clemarfolly/TK3000/componentes.jpg

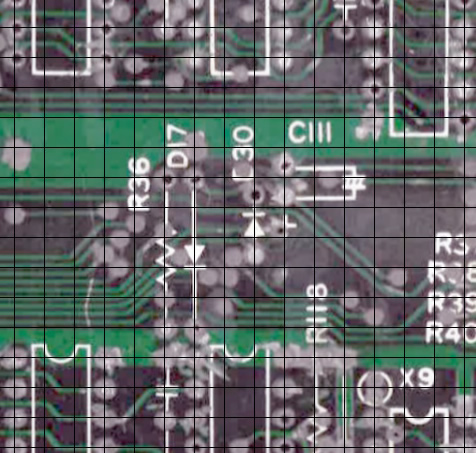
componentes.jpg
