clemarfolly/TK3000/TK3000_mapa_cis.jpg

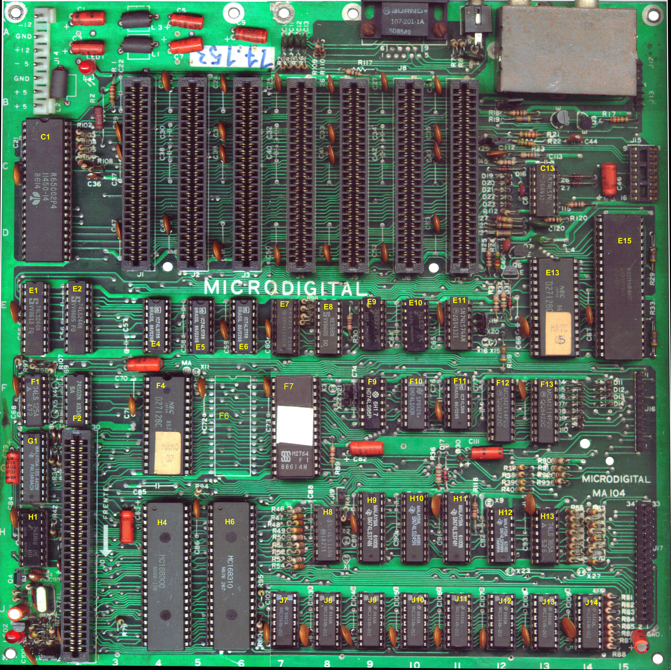
TK3000_mapa_cis.jpg
