clemarfolly/TK3000/Fotos Originais/SEskasoni-H25090512270.pdf

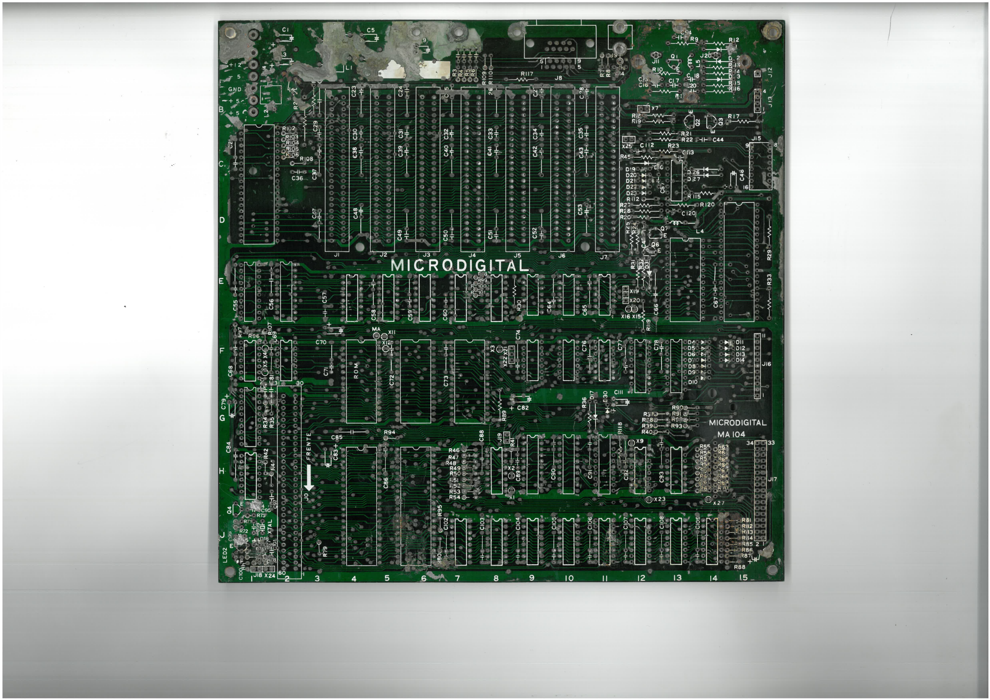
[picture p3: page 1]
