clemarfolly/TK3000/Fotos Originais/SEskasoni-H25090512280.pdf

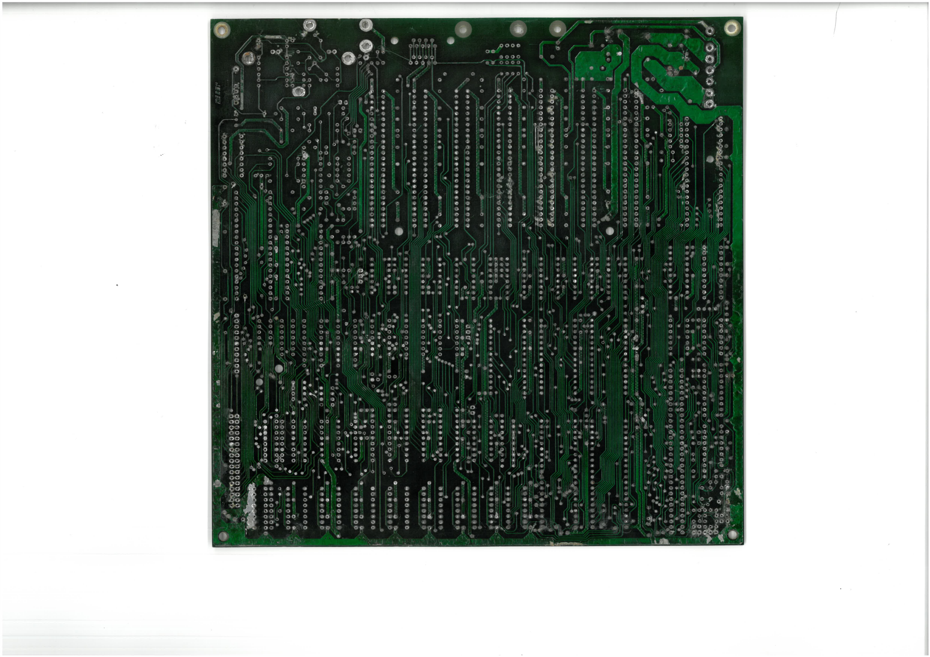
[picture p4: page 1]
