clemarfolly/TK3000/Apoio/ModuladorRF-canal-vbe-youtube-v=0MxuOd1NND4.jpg

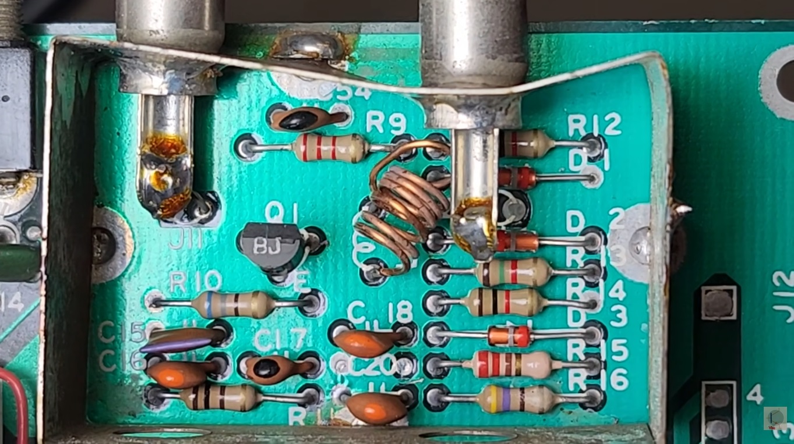
Apoio/ModuladorRF-canal-vbe-youtube-v=0MxuOd1NND4.jpg
