clemarfolly/TK3000/Apoio/tk3000_f.JPG

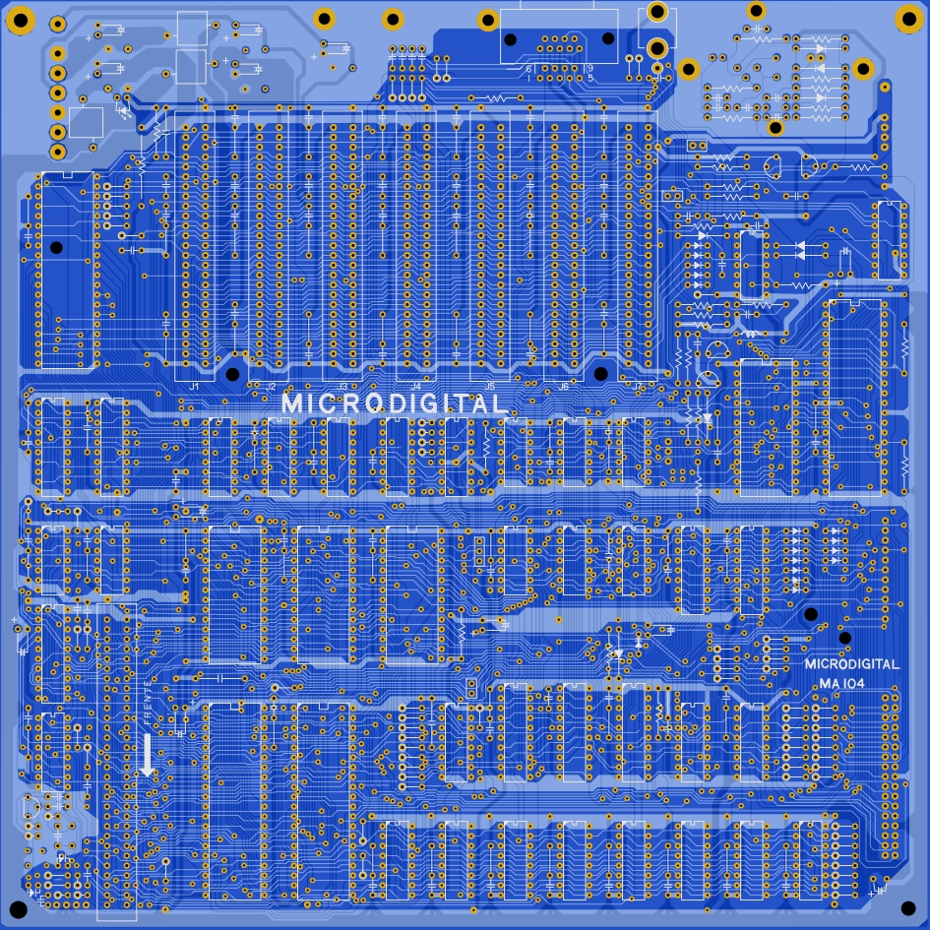
Apoio/tk3000_f.JPG
