clemarfolly/TK3000/comparação.jpg

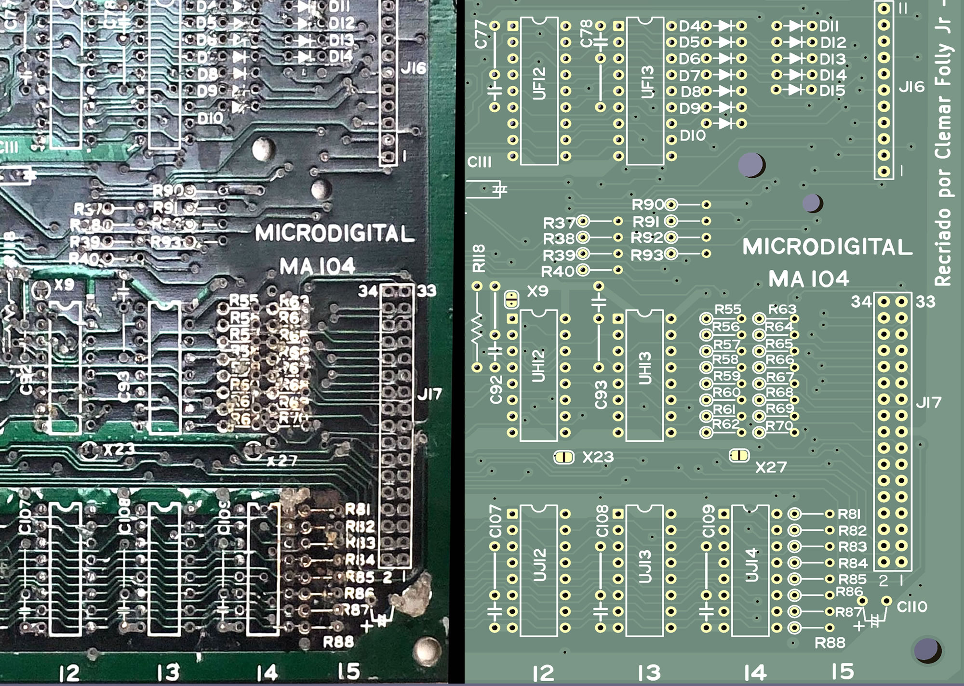
comparação.jpg
