clemarfolly/TK3000/Esquema Original/esquema_tk3000_microdigital.gif

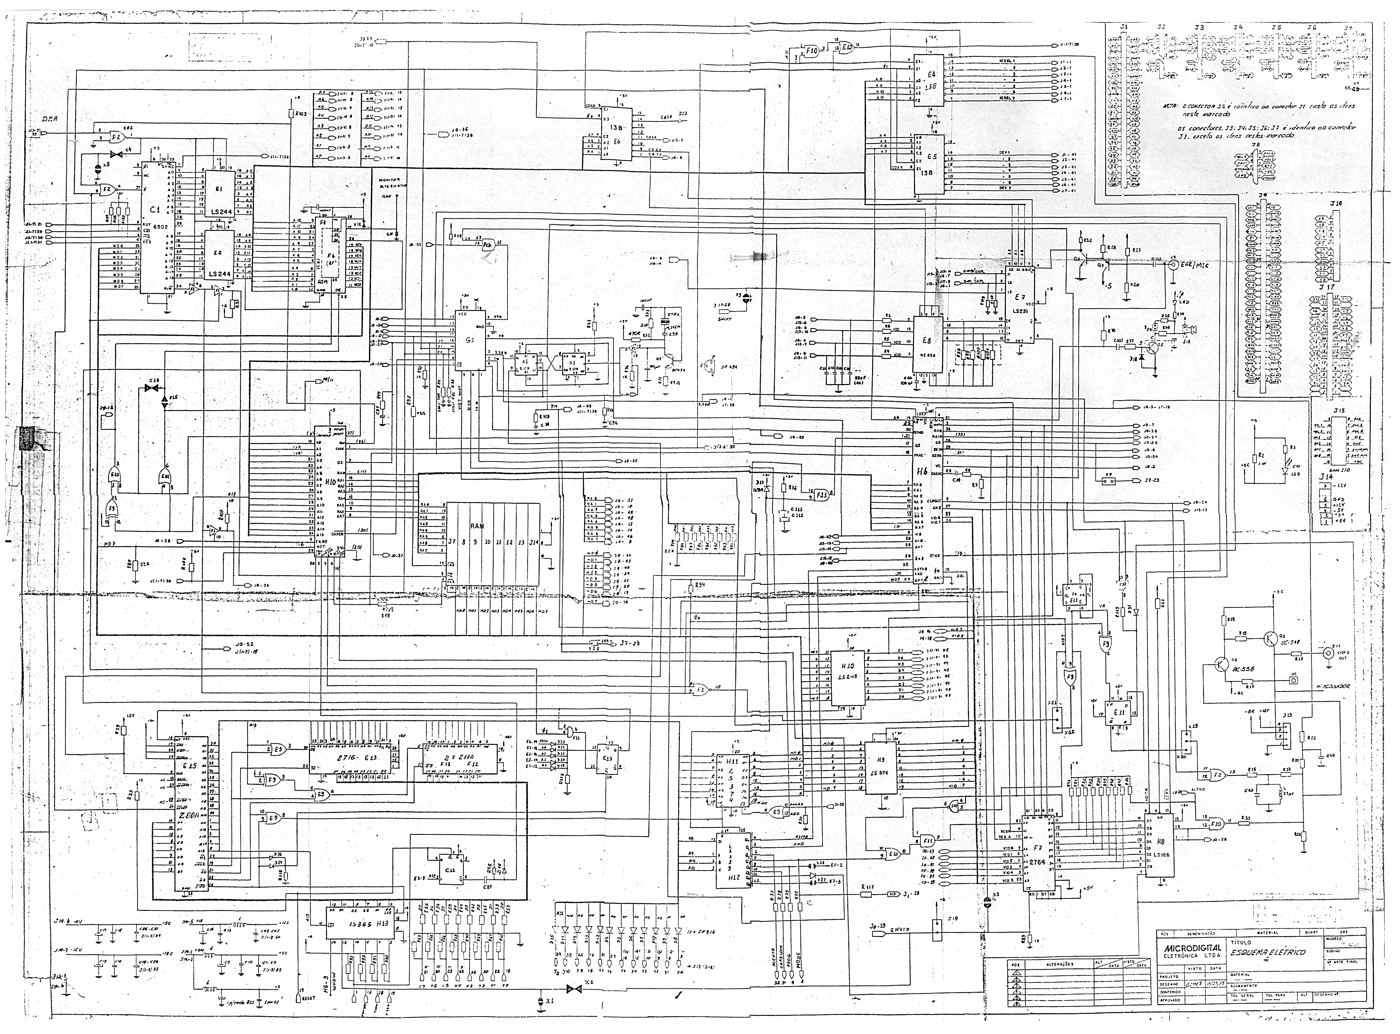
Esquema Original/esquema_tk3000_microdigital.gif
