clemarfolly/TK3000/Esquema Original/TK3000_DiagramaBlocos.tif

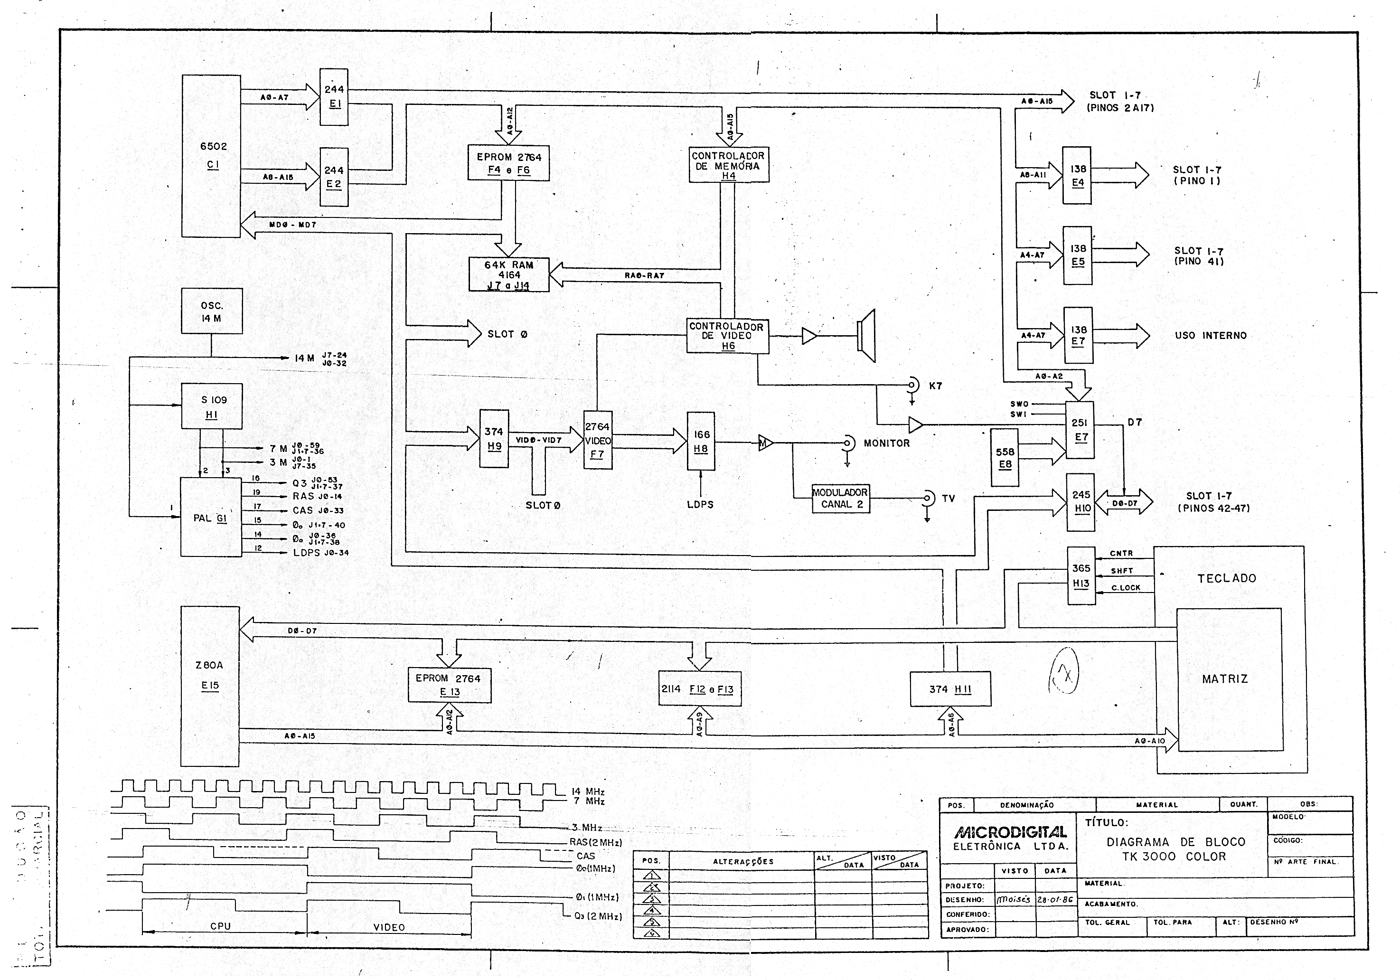
Esquema Original/TK3000_DiagramaBlocos.tif
