clemarfolly/TK3000/Fotos Ajustadas/tk3000_cel_frente2.jpg

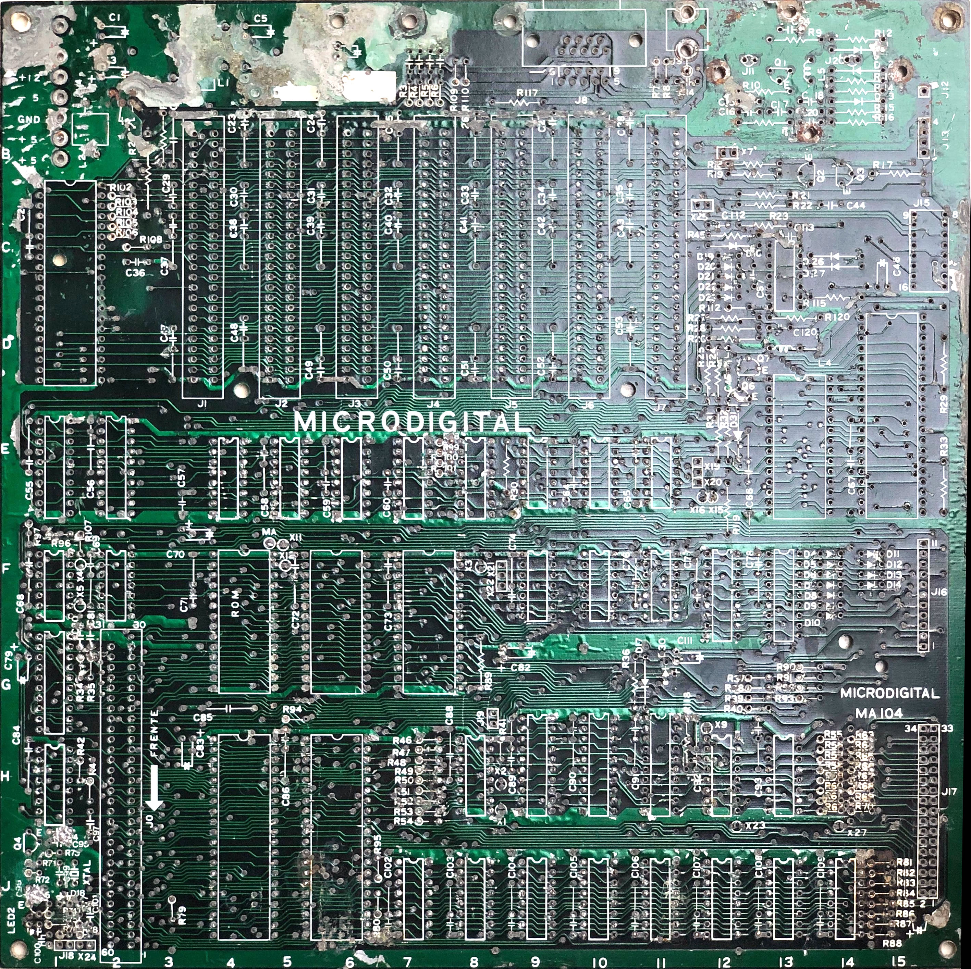
Fotos Ajustadas/tk3000_cel_frente2.jpg
