clemarfolly/TK3000/Fotos Ajustadas/tk3000_cel_frente3.jpg

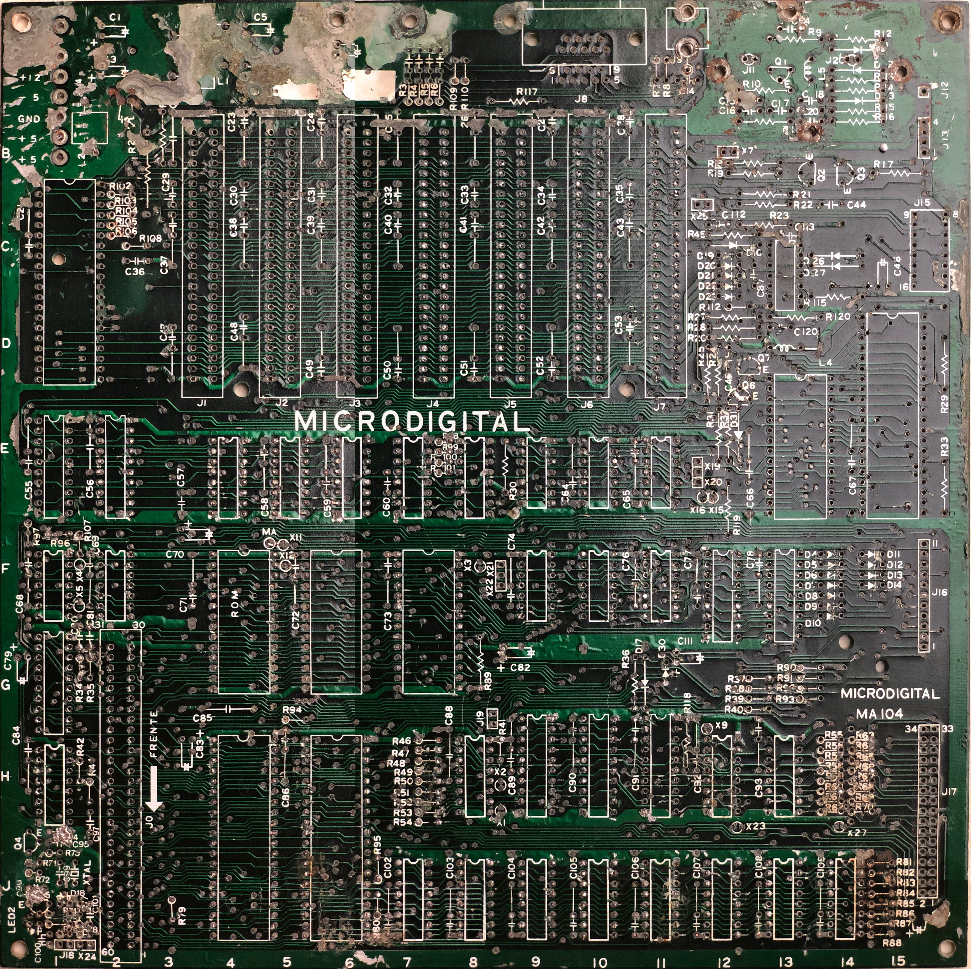
Fotos Ajustadas/tk3000_cel_frente3.jpg
