clemarfolly/TK3000/Fotos Ajustadas/tk3000_cel_verso2.jpg

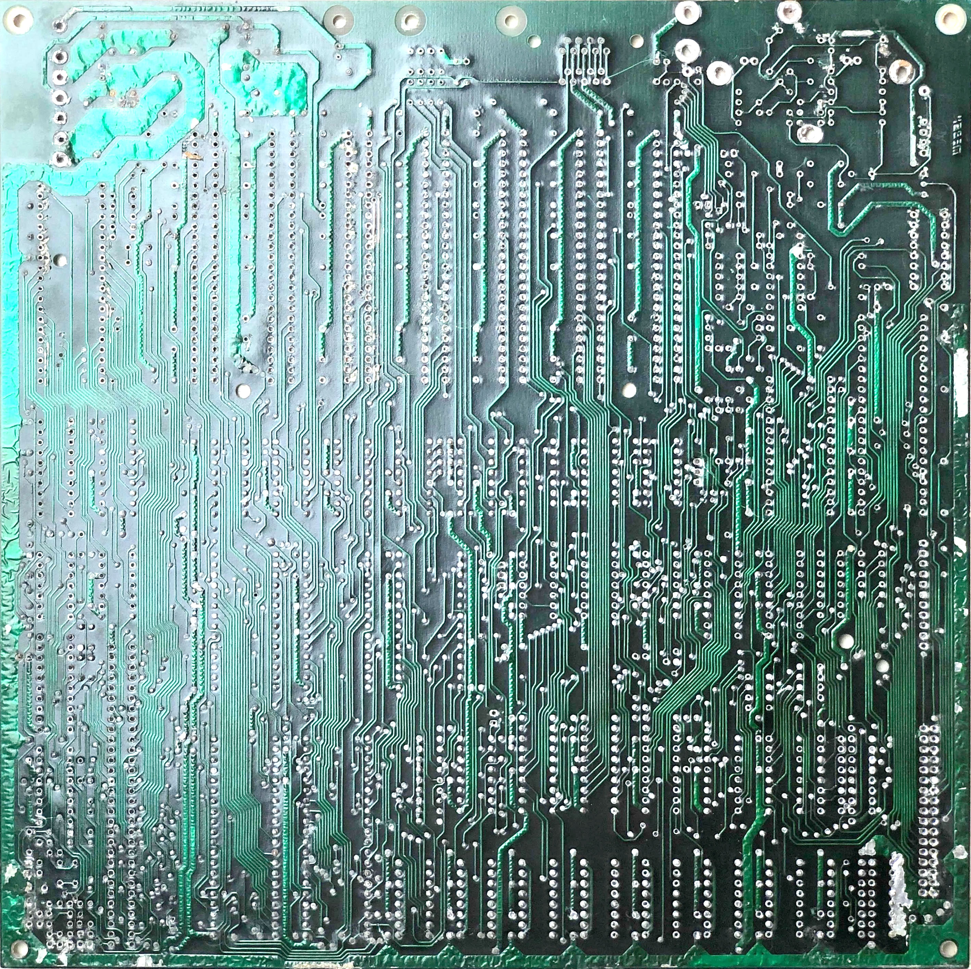
Fotos Ajustadas/tk3000_cel_verso2.jpg
