clemarfolly/TK3000/Fotos Ajustadas/tk3000_cel_verso4.jpg

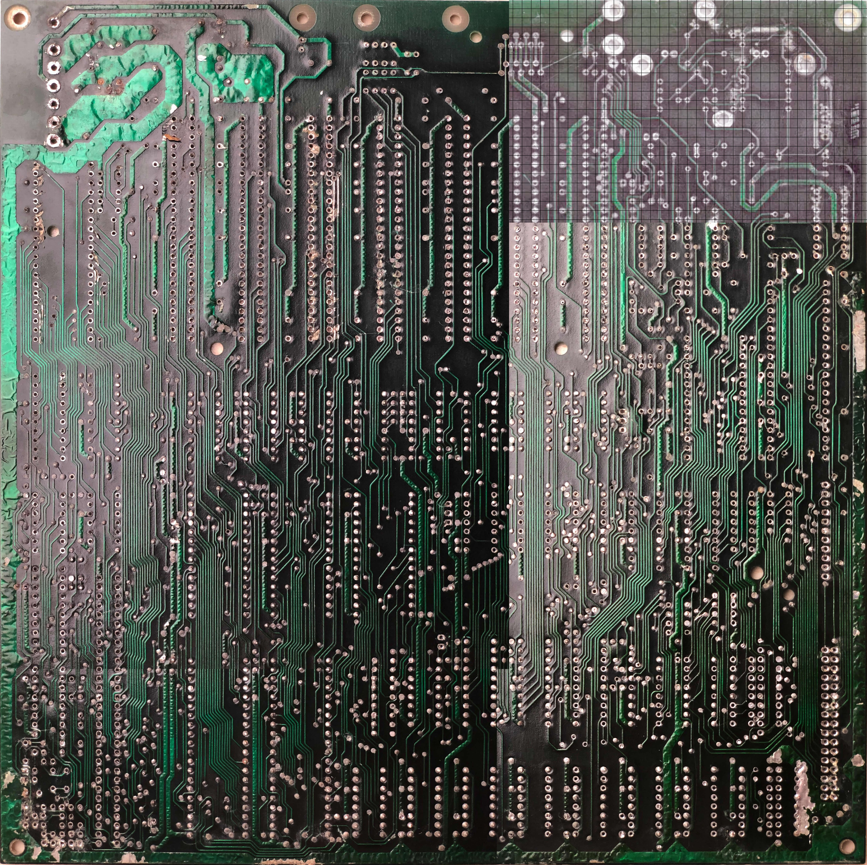
Fotos Ajustadas/tk3000_cel_verso4.jpg
