clemarfolly/TK3000/Fotos Ajustadas/TK3000_scan_frente.jpg

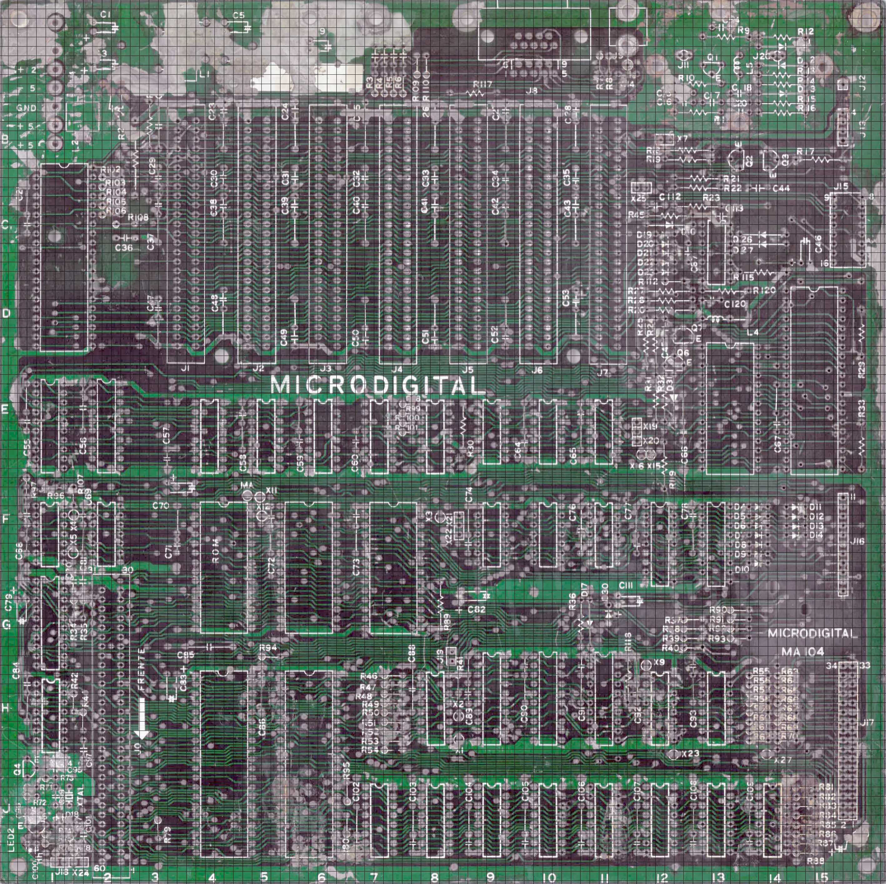
Fotos Ajustadas/TK3000_scan_frente.jpg
