clemarfolly/TK3000/Fotos Ajustadas/TK3000_scan_verso.jpg

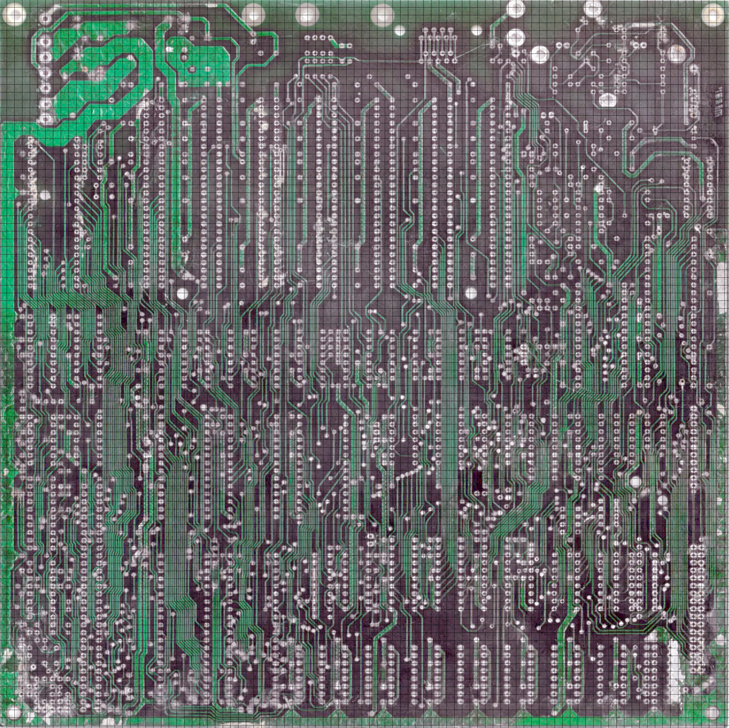
Fotos Ajustadas/TK3000_scan_verso.jpg
