clemarfolly/TK3000/Fotos Ajustadas/tk3000_verso_alternativo.jpg

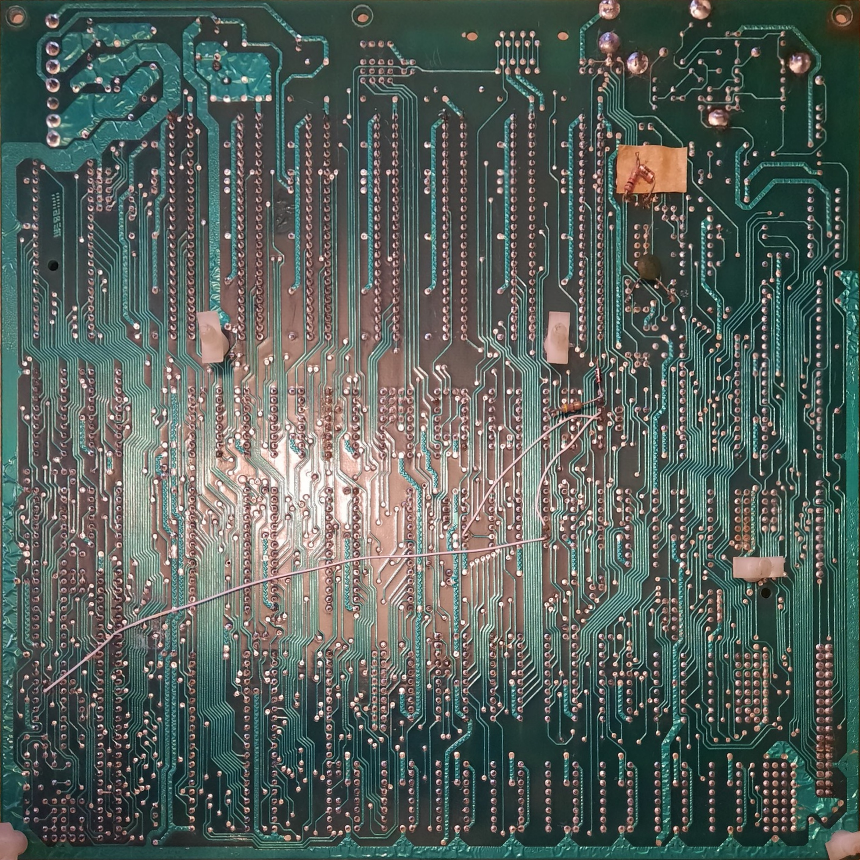
Fotos Ajustadas/tk3000_verso_alternativo.jpg
