clemarfolly/TK3000/Fotos Originais/459558370_9009164292432499_6865627964230679064_n.jpg

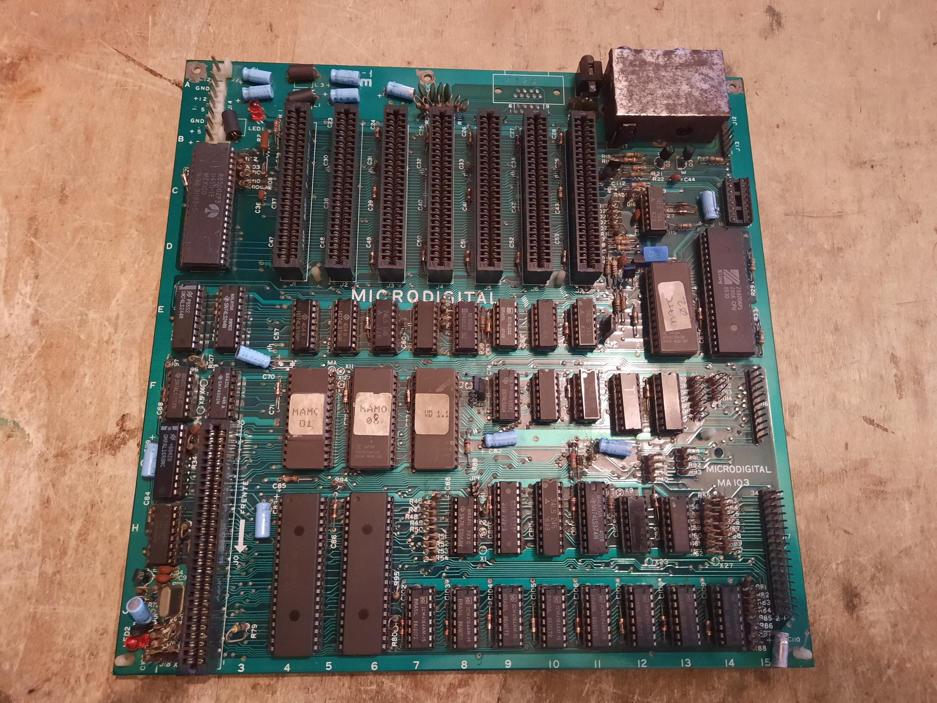
Fotos Originais/459558370_9009164292432499_6865627964230679064_n.jpg
