clemarfolly/TK3000/Fotos Originais/459910241_9009164349099160_2916040112095149237_n.jpg

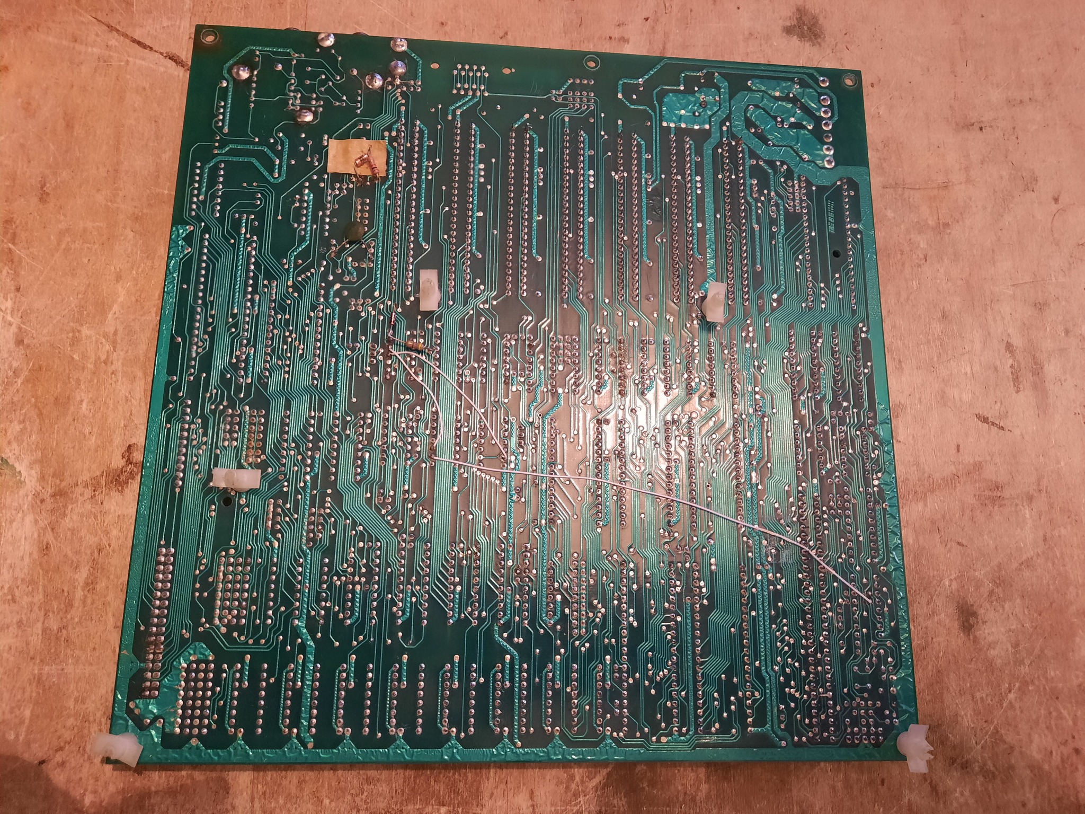
Fotos Originais/459910241_9009164349099160_2916040112095149237_n.jpg
