clemarfolly/TK3000/Fotos Originais/Celular/01.jpeg

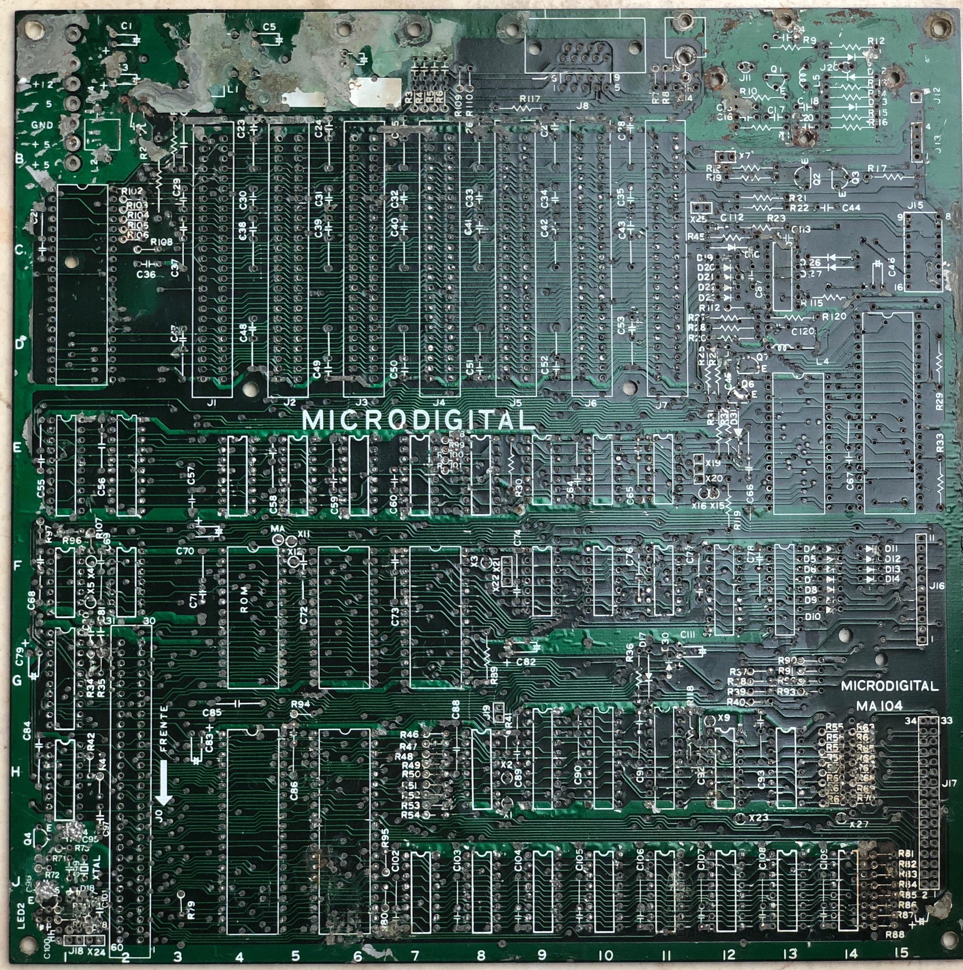
Fotos Originais/Celular/01.jpeg
