clemarfolly/TK3000/Fotos Originais/Celular/02.jpeg

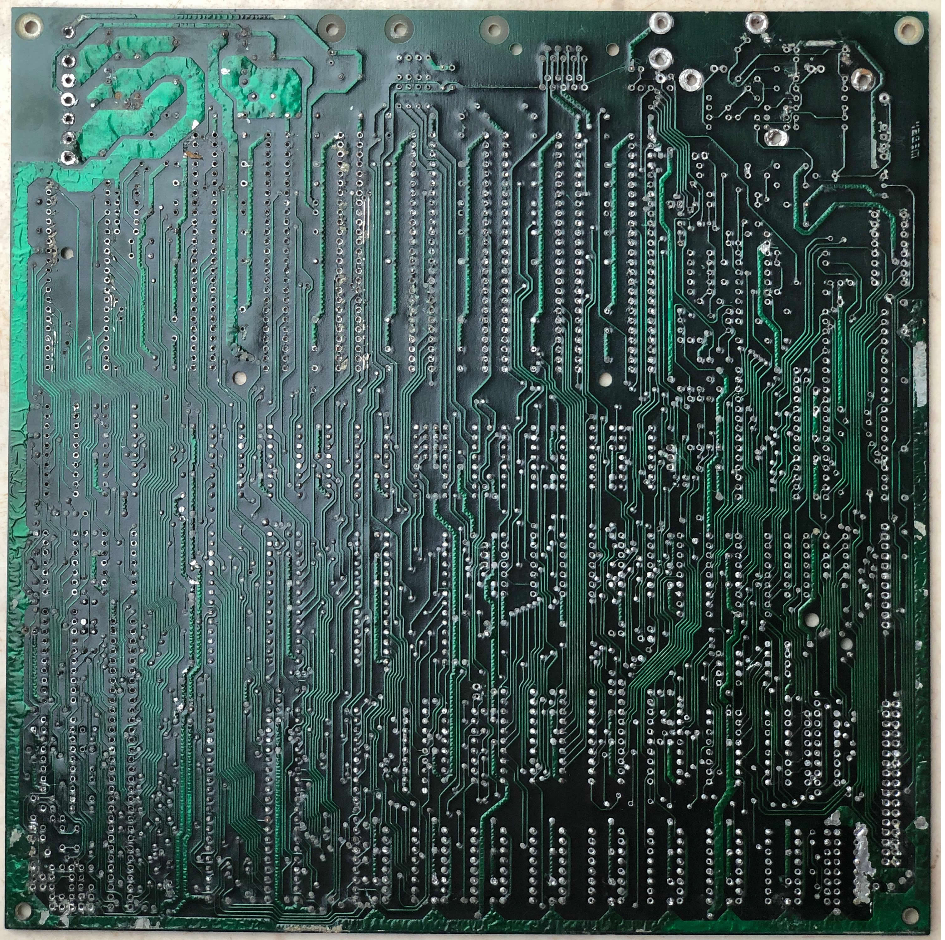
Fotos Originais/Celular/02.jpeg
