clemarfolly/TK3000/Fotos Originais/Celular/03.jpeg

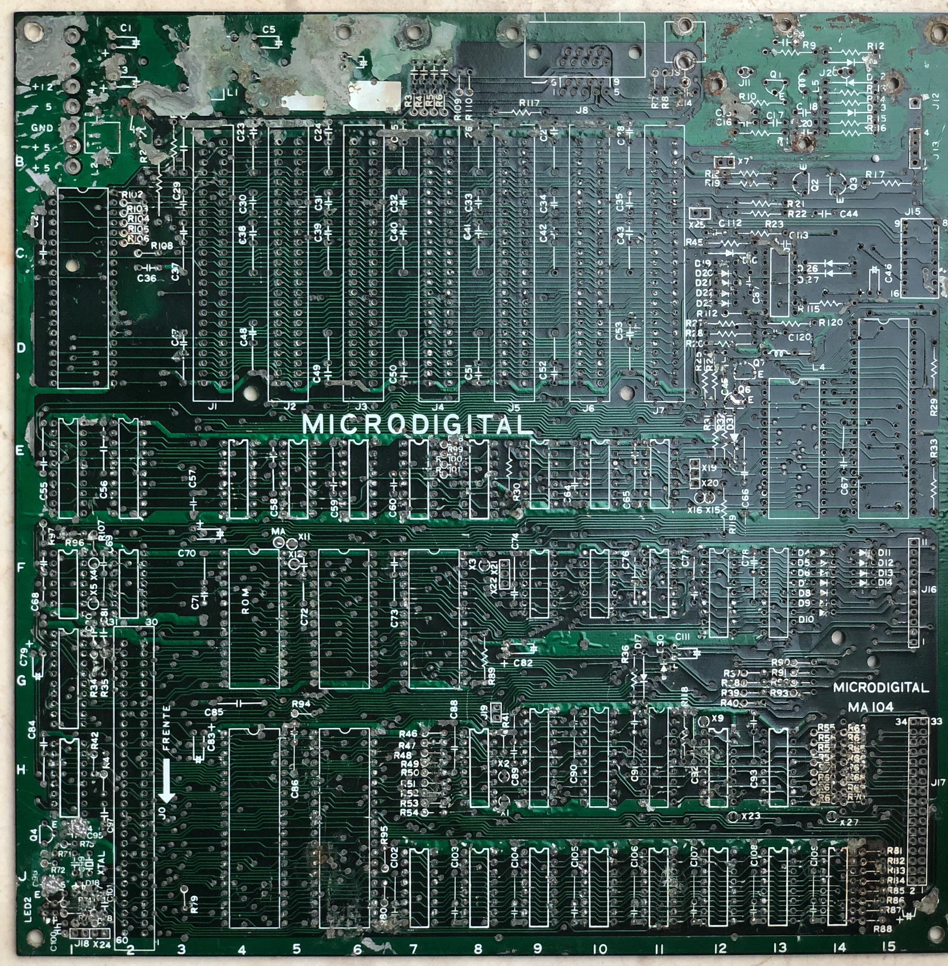
Fotos Originais/Celular/03.jpeg
