clemarfolly/TK3000/Fotos Originais/Celular/04.jpeg

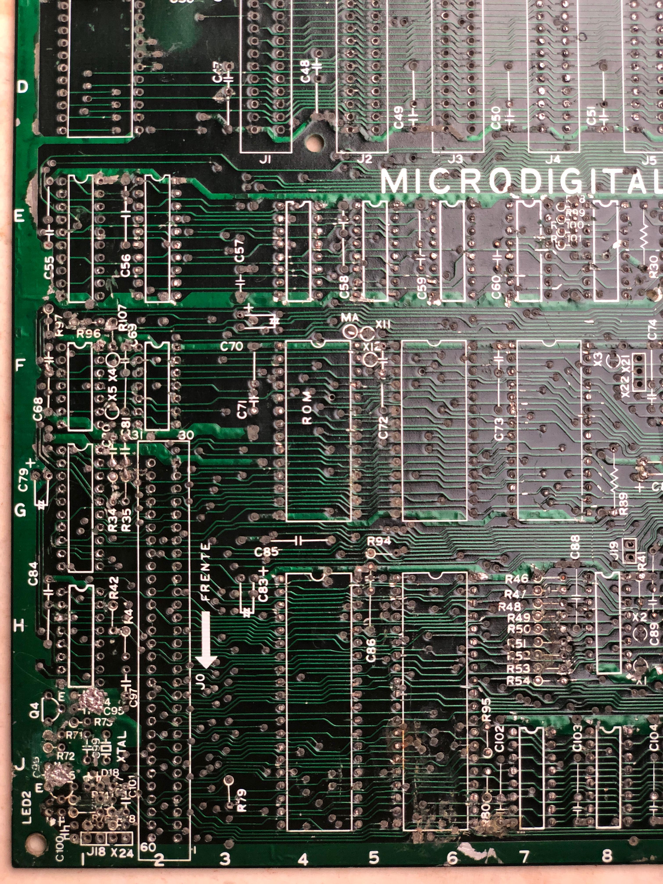
Fotos Originais/Celular/04.jpeg
