clemarfolly/TK3000/Fotos Originais/Celular/05.jpeg

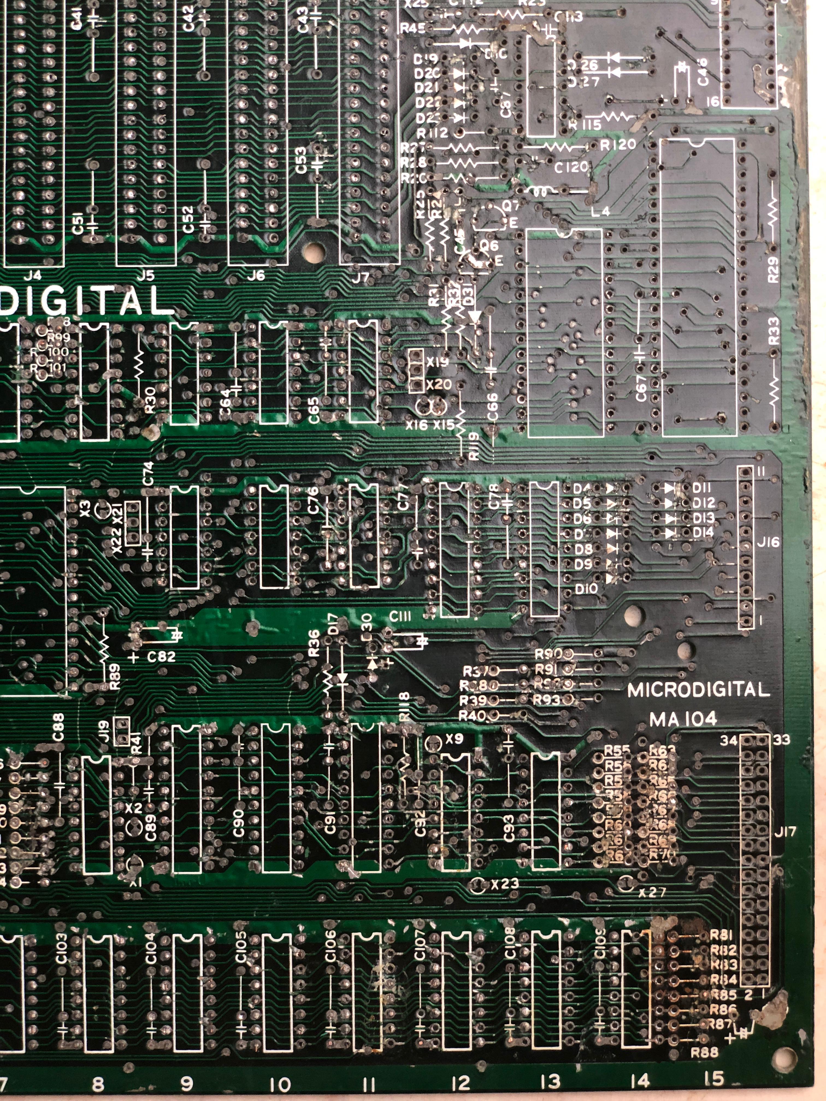
Fotos Originais/Celular/05.jpeg
