clemarfolly/TK3000/Fotos Originais/Celular/06.jpeg

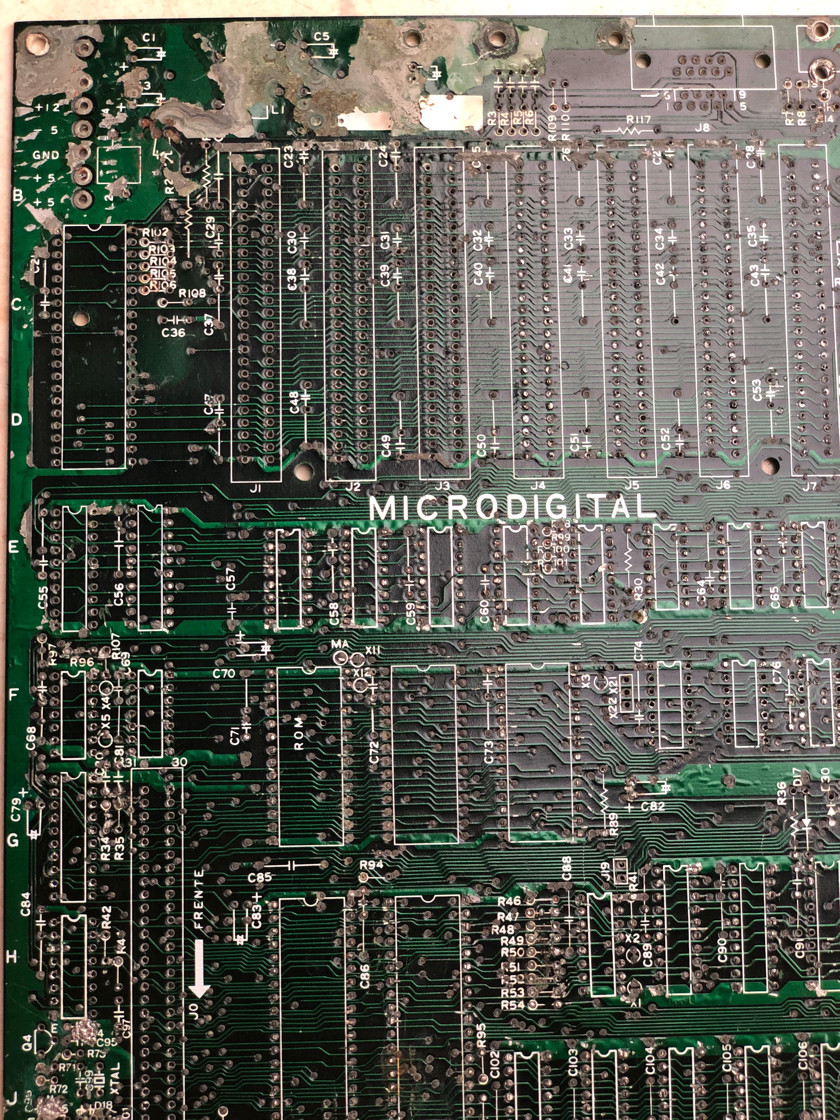
Fotos Originais/Celular/06.jpeg
