clemarfolly/TK3000/Fotos Originais/Celular/07.jpeg

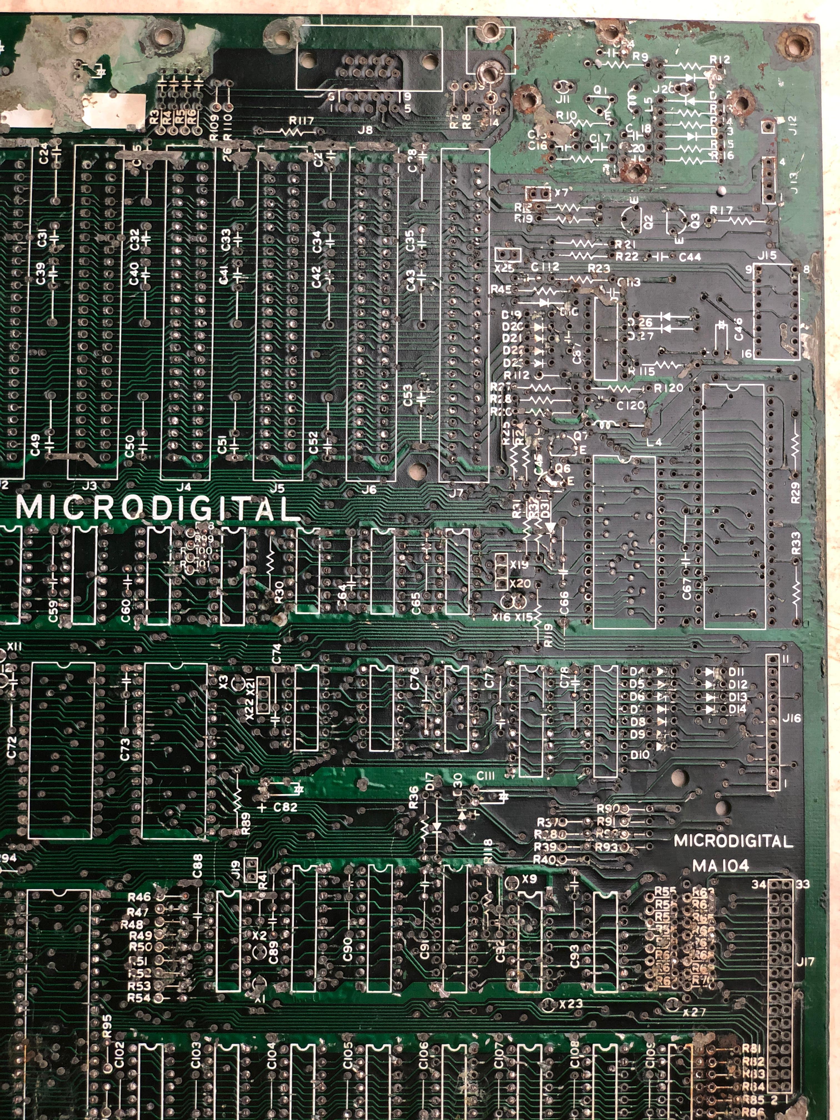
Fotos Originais/Celular/07.jpeg
