clemarfolly/TK3000/Fotos Originais/Celular/08.jpeg

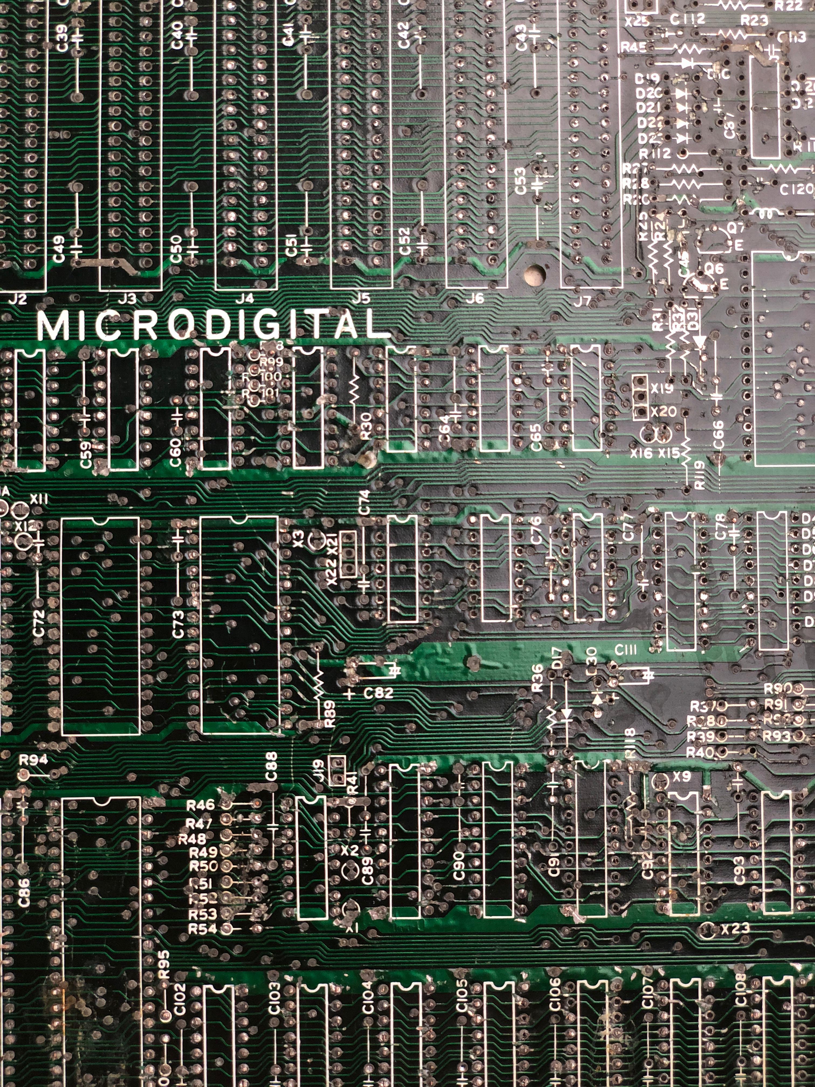
Fotos Originais/Celular/08.jpeg
