clemarfolly/TK3000/Fotos Originais/Celular/09.jpeg

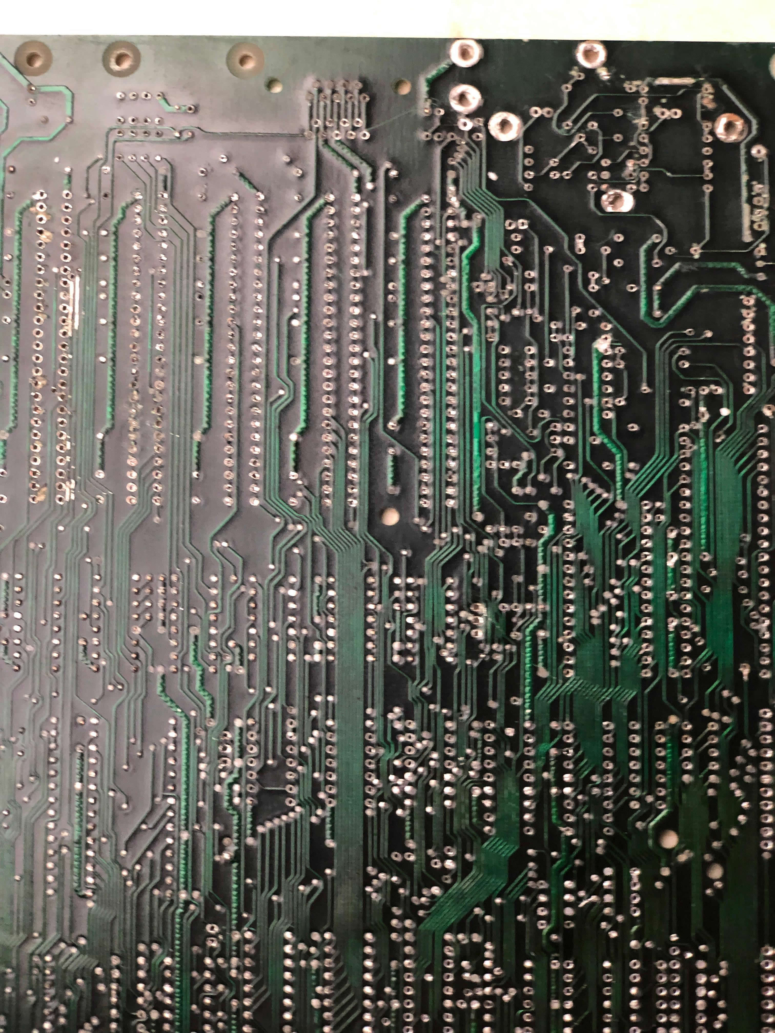
Fotos Originais/Celular/09.jpeg
