clemarfolly/TK3000/Fotos Originais/Celular/10.jpeg

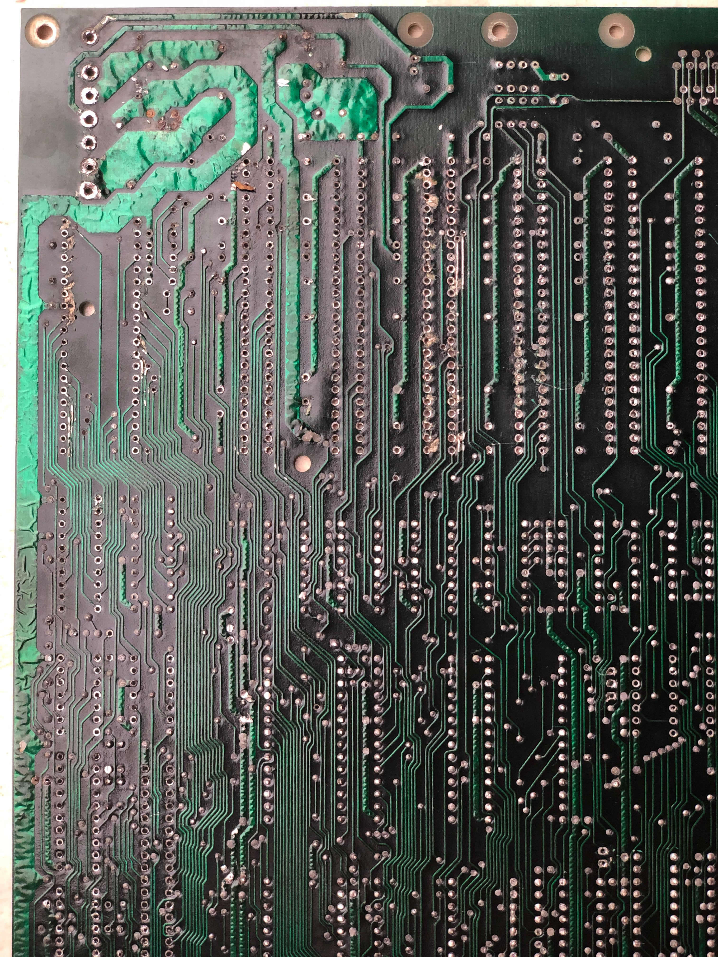
Fotos Originais/Celular/10.jpeg
