clemarfolly/TK3000/Fotos Originais/Celular/11.jpeg

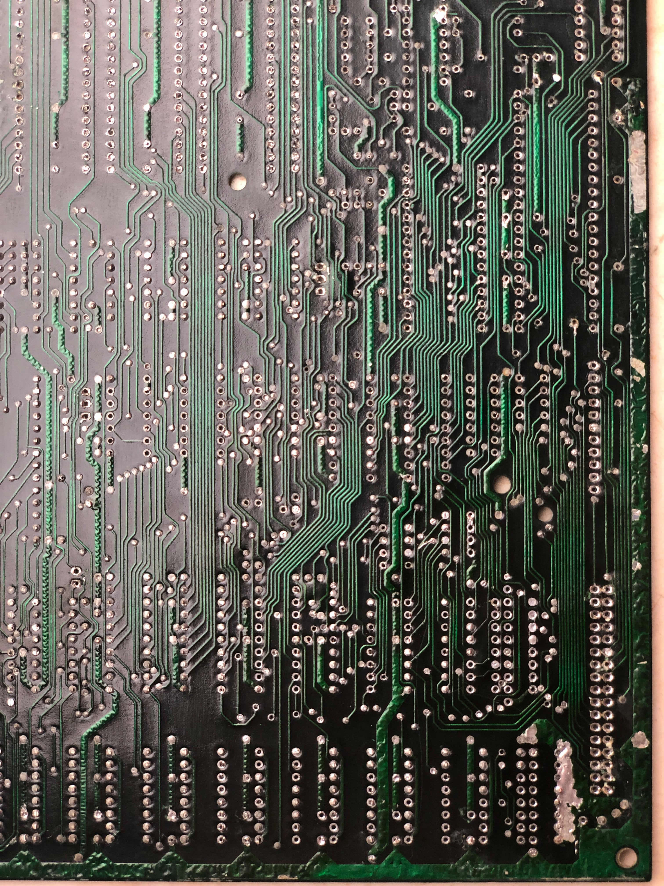
Fotos Originais/Celular/11.jpeg
