clemarfolly/TK3000/Fotos Originais/Celular/12.jpeg

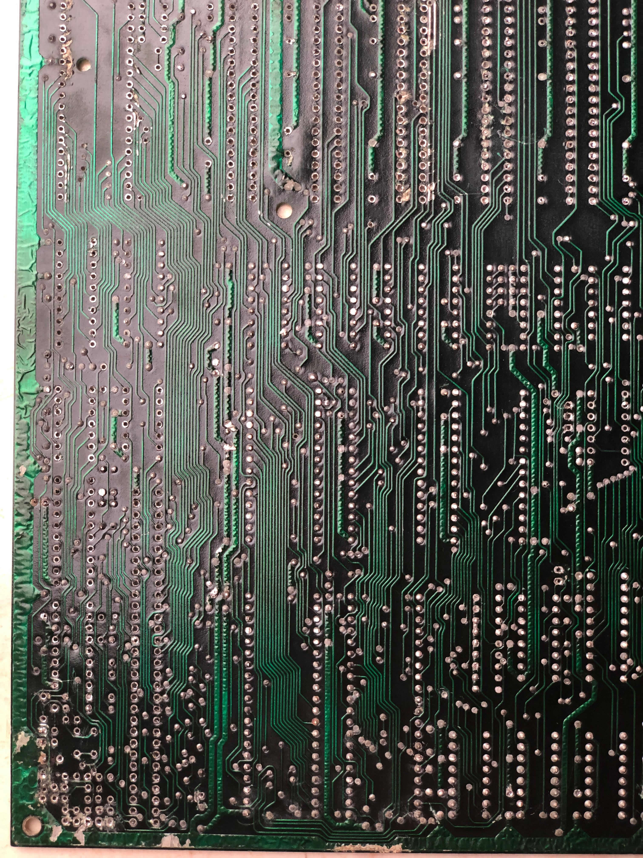
Fotos Originais/Celular/12.jpeg
