clemarfolly/TK3000/Fotos Originais/Celular/13.jpeg

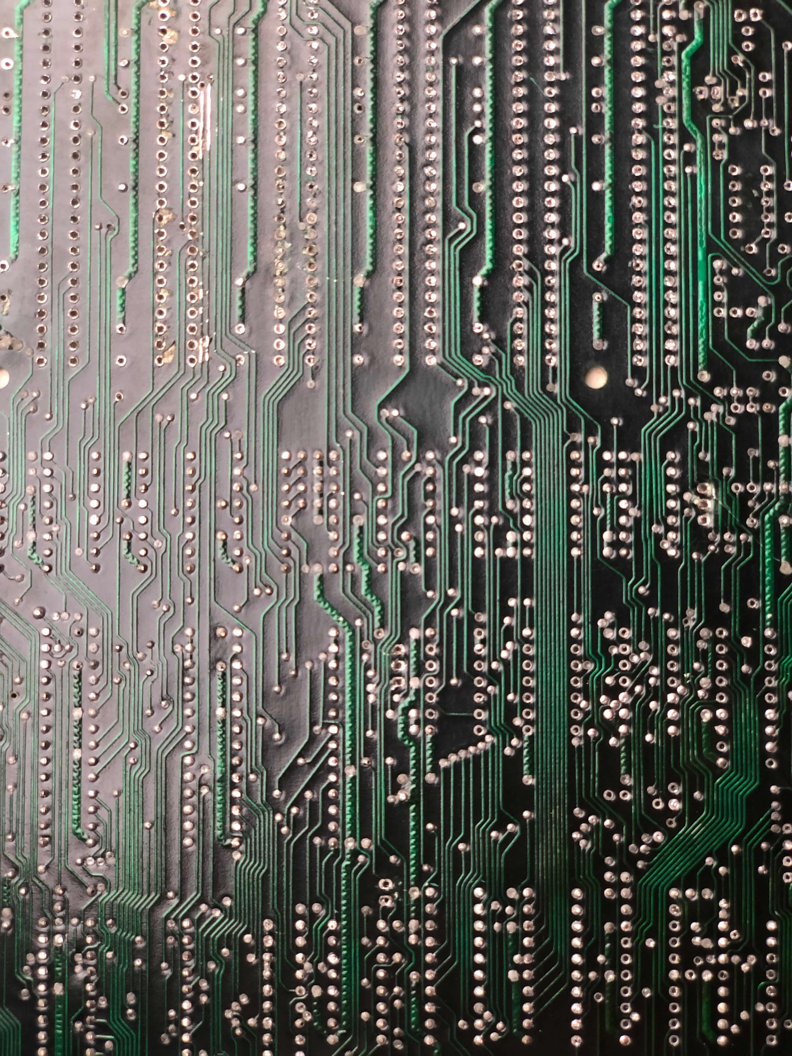
Fotos Originais/Celular/13.jpeg
