clemarfolly/TK3000/Fotos Originais/D_NQ_NP_2X_725195-MLB78293878917_082024-F.webp

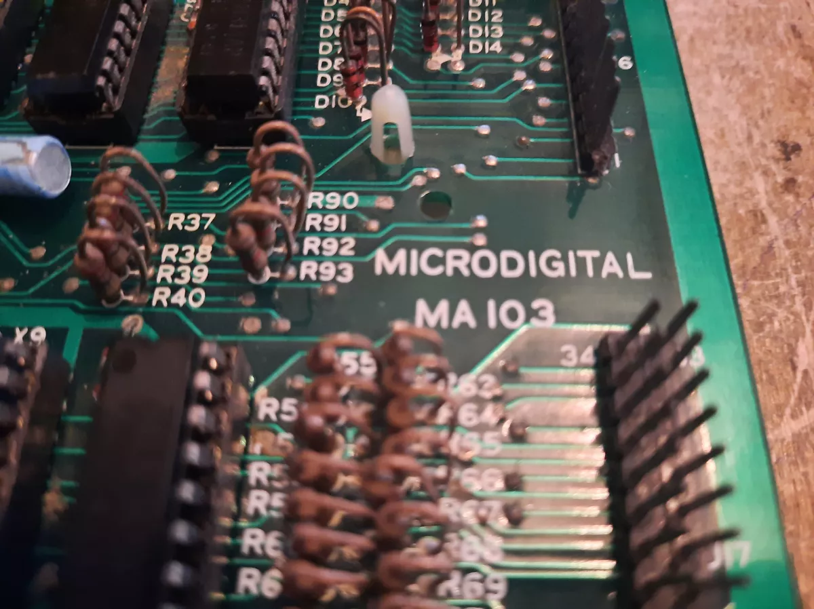
Fotos Originais/D_NQ_NP_2X_725195-MLB78293878917_082024-F.webp
