clemarfolly/TK3000/Fotos Originais/D_NQ_NP_2X_956720-MLB78293879247_082024-F.webp

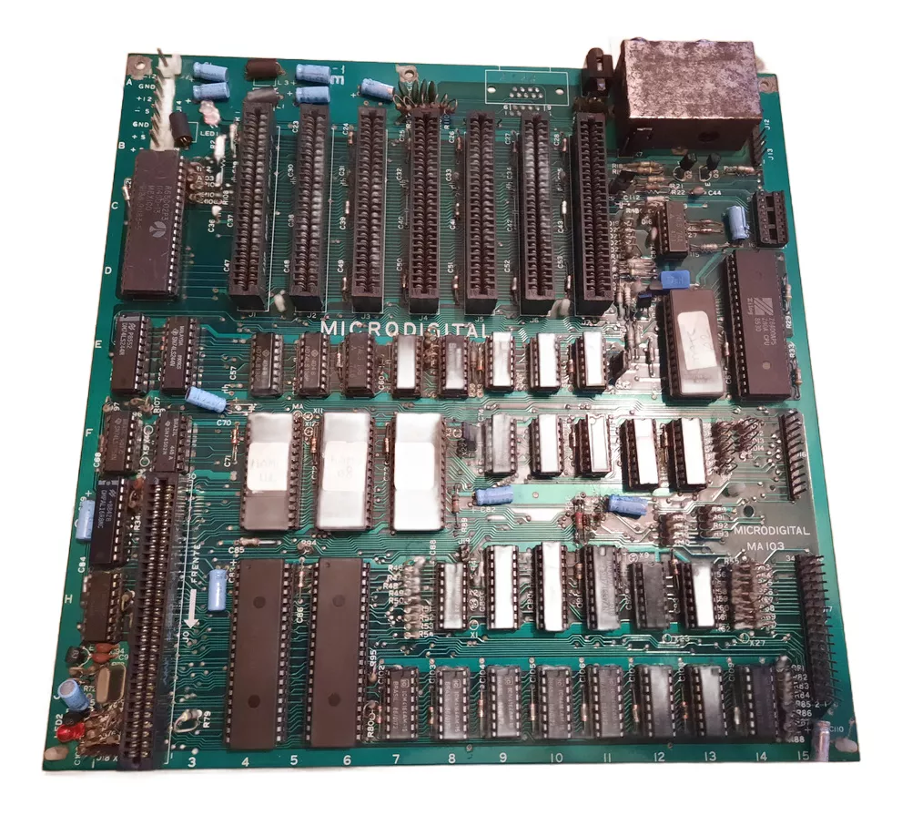
Fotos Originais/D_NQ_NP_2X_956720-MLB78293879247_082024-F.webp
