clemarfolly/TK3000/Fotos Originais/Microdigital_TK3000IIe_MoBo_MA104.jpg

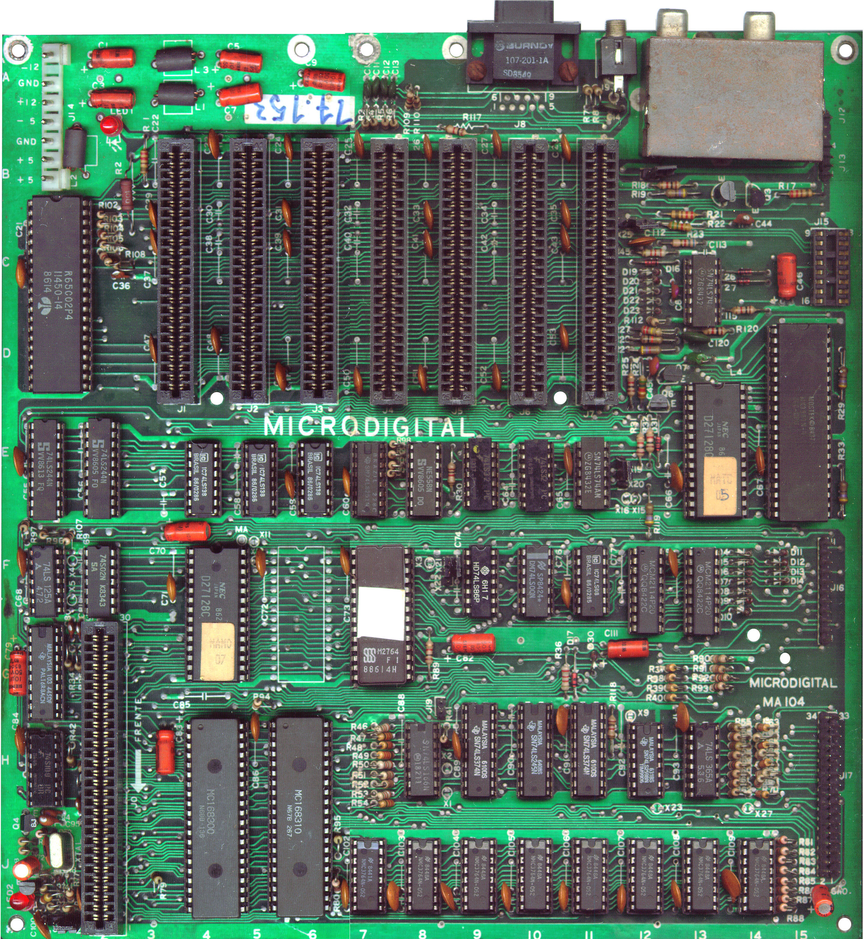
Fotos Originais/Microdigital_TK3000IIe_MoBo_MA104.jpg
