clemarfolly/TK3000/Fotos Originais/TK Works/D_NQ_NP_2X_950521-MLB77225402566_072024-F.webp

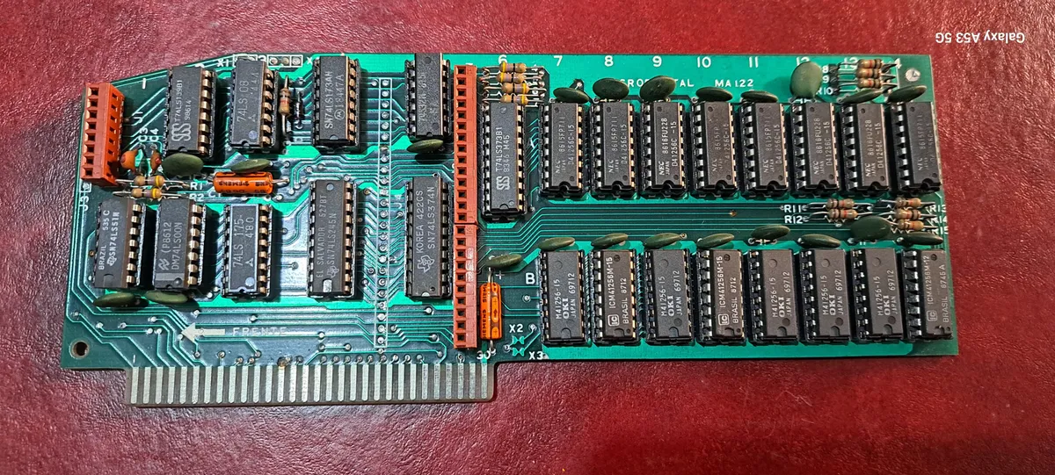
Fotos Originais/TK Works/D_NQ_NP_2X_950521-MLB77225402566_072024-F.webp
