clemarfolly/TK3000/Fotos Originais/TK Works/D_NQ_NP_2X_957518-MLB77439985691_072024-F.webp

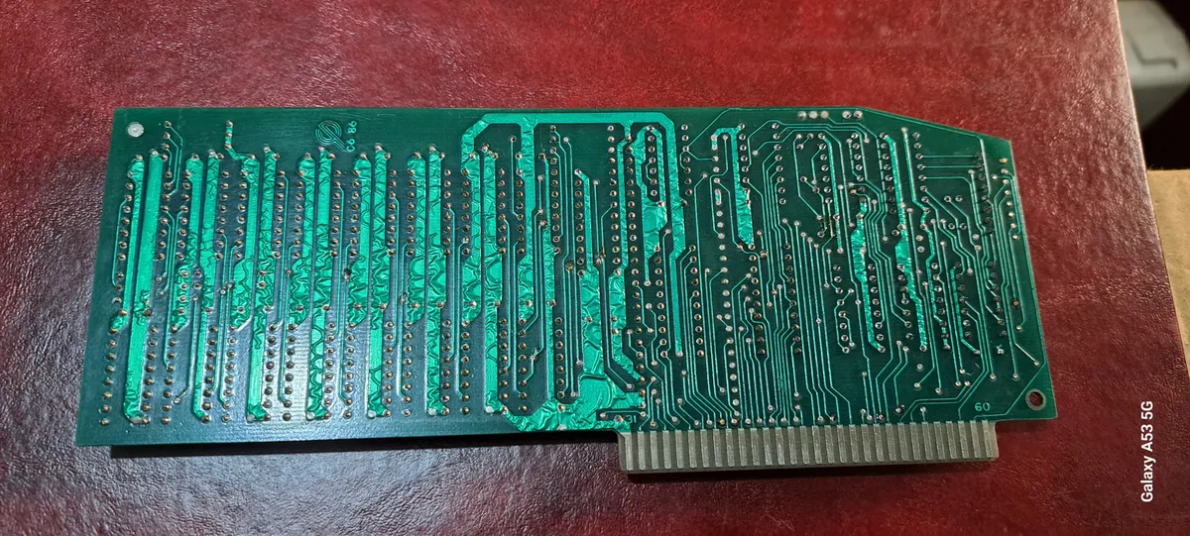
Fotos Originais/TK Works/D_NQ_NP_2X_957518-MLB77439985691_072024-F.webp
