clemarfolly/TK3000/Fotos Originais/TK Works/esquema_sobreplaca_tkworks_microdigital.gif

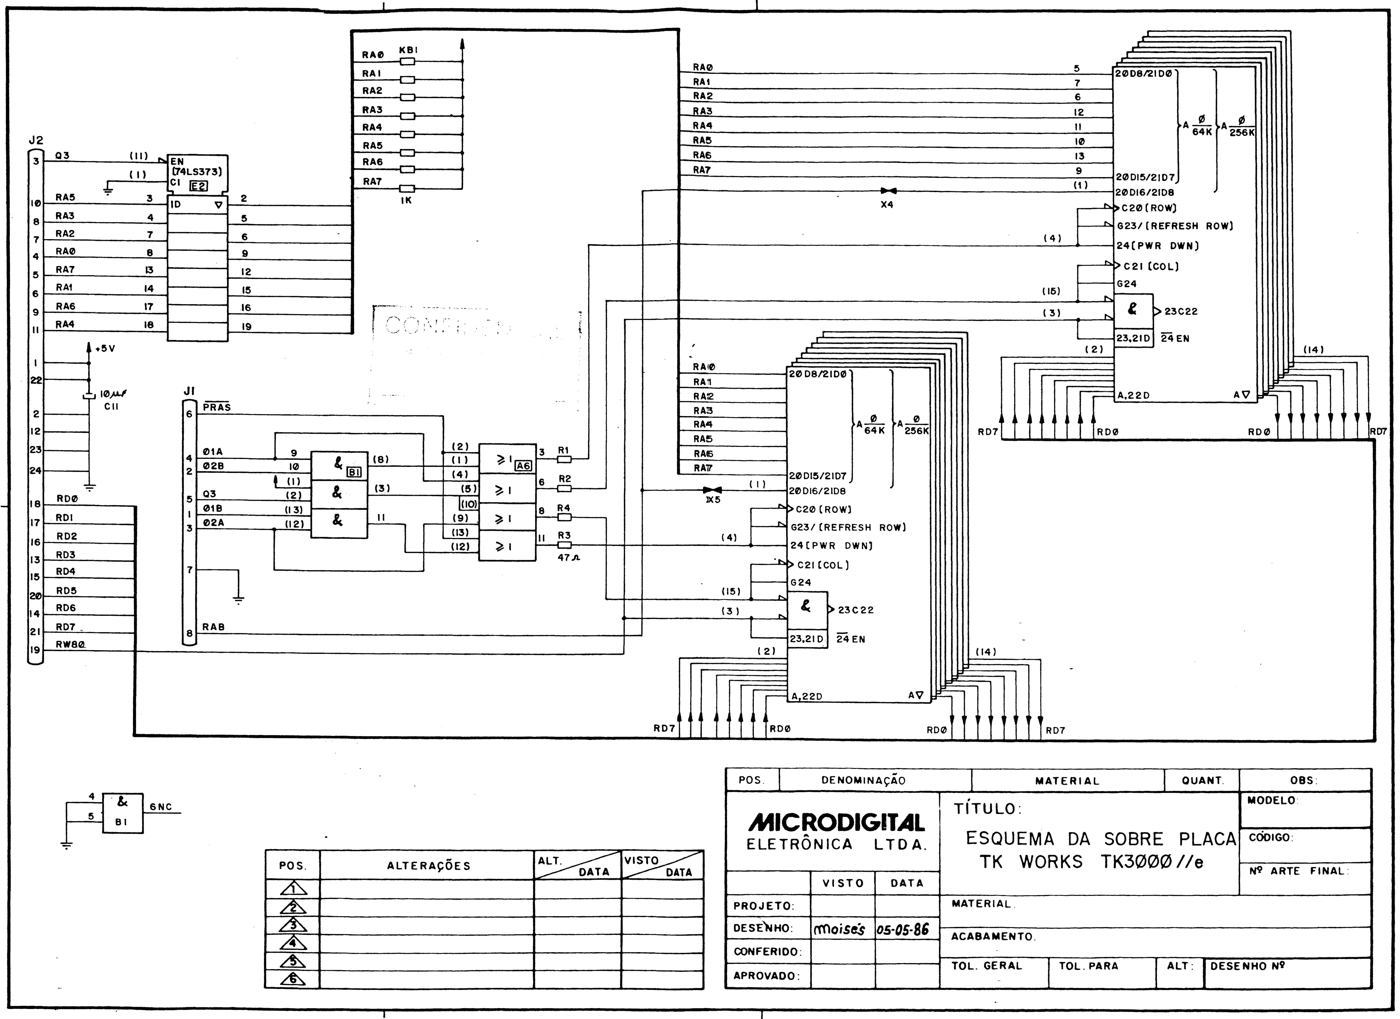
Fotos Originais/TK Works/esquema_sobreplaca_tkworks_microdigital.gif
