clemarfolly/TK3000/Fotos Originais/v3.jpg

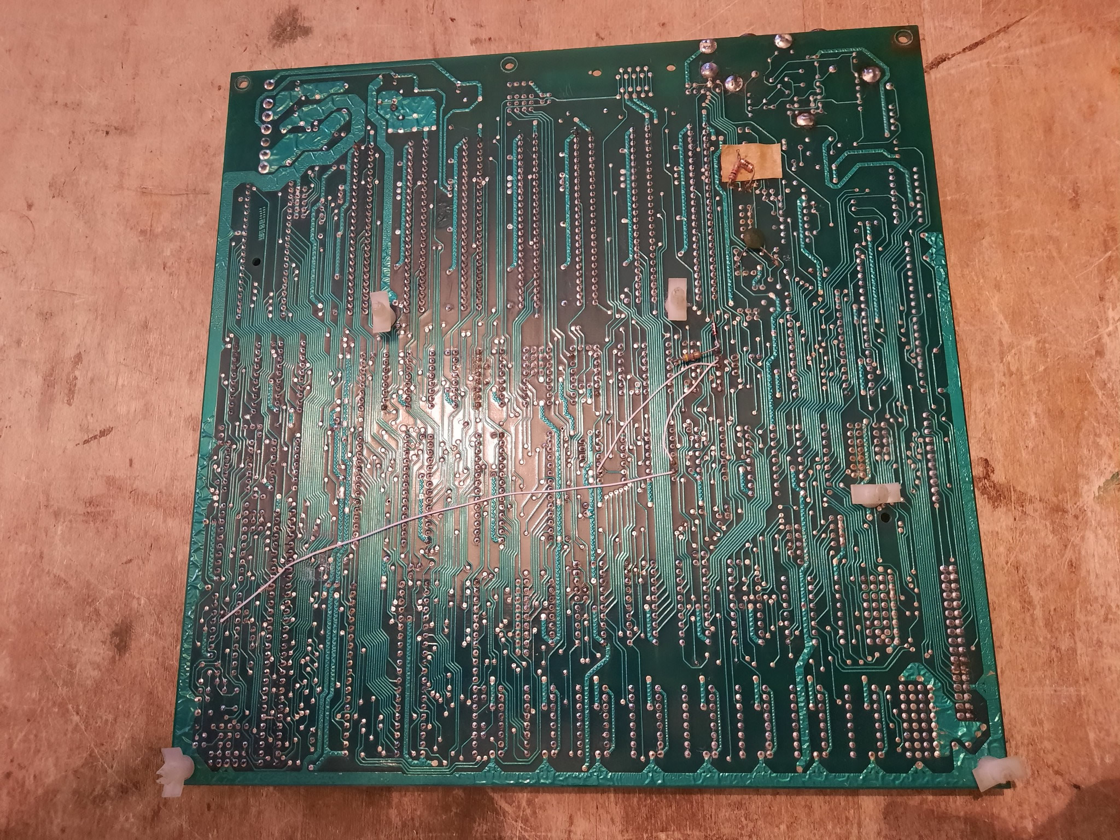
Fotos Originais/v3.jpg
