clemarfolly/TK3000/sl.JPG

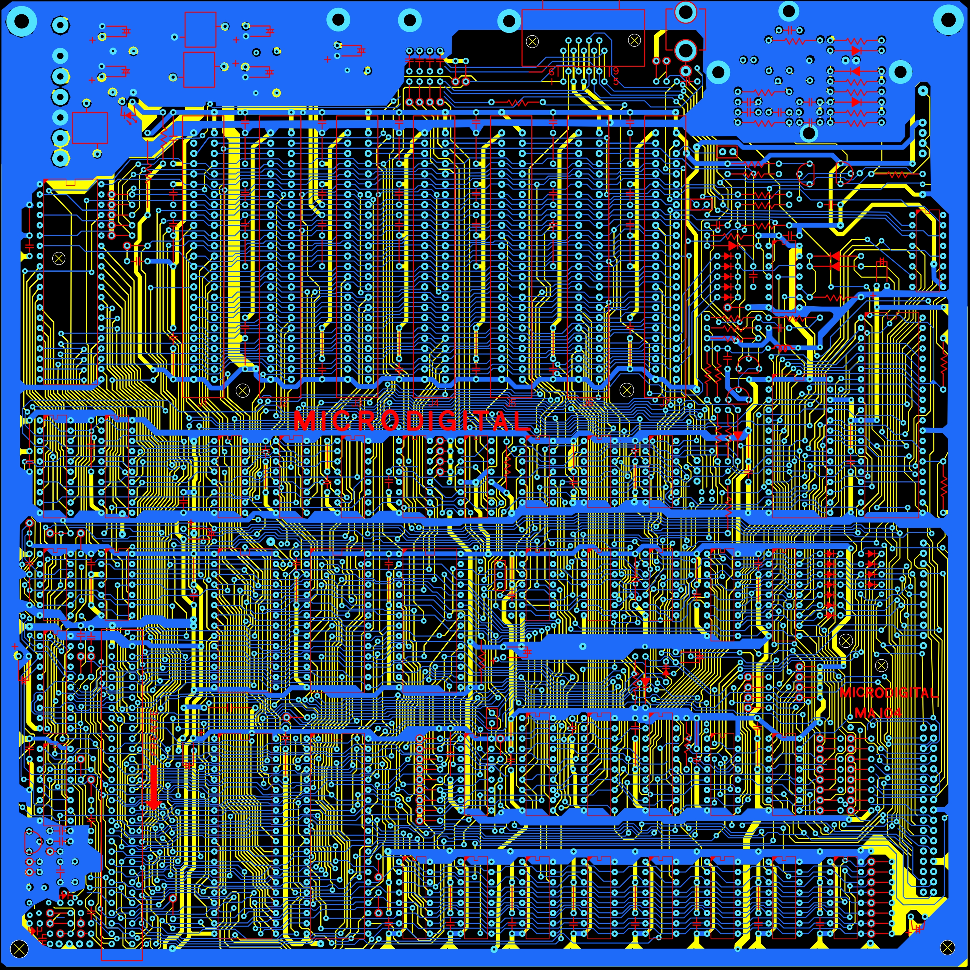
sl.JPG
