clemarfolly/TK3000/text_sample.jpg

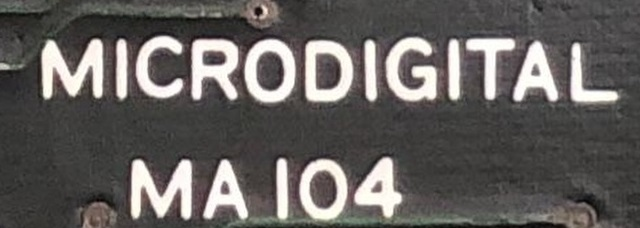
text_sample.jpg
