clemarfolly/TK3000/Apoio/TK3000_lista_componentes.ods

Sheet: Leia-me
Microdigital TK 3000 IIe - Lista de Componentes
Objetivo do Projeto
Este projeto tem como objetivo principal a criação de uma réplica funcional do Microdigital TK 3000 IIe,
um microcomputador brasileiro lançado na década de 1980.
Os objetivos específicos são:
1. Construir uma réplica completa do TK 3000 IIe, incluindo esquema elétrico e PCB.
2. Recriar o esquema elétrico com alta qualidade, já que os esquemas disponíveis na internet
apresentam pouca qualidade e são difíceis de ler.
3. Permitir que interessados possam construir réplicas funcionais do TK 3000 IIe.
4. Disponibilizar o esquema elétrico e a PCB para que sejam utilizados na manutenção e
reparo de TK 3000 IIe originais existentes.
O esquema elétrico e a PCB serão de código aberto (open source) e estarão disponíveis no GitHub.
Todos os materiais serão compartilhados sob licença livre.
Esta planilha contém a lista de componentes extraída do esquema elétrico. Alguns valores ainda
precisam ser validados ou preenchidos. Contribua validando os valores existentes ou
preenchendo os valores ausentes!
Como contribuir:
- Valide os valores já preenchidos na planilha
- Preencha os valores que estiverem ausentes
- Adicione informações adicionais quando possível
Aguarde! Em breve o esquema e a PCB estarão disponíveis no GitHub.
Obrigado, Clemar Folly Jr.

Sheet: Créditos
Créditos e Contribuidores
Esta seção é destinada a listar as pessoas que contribuíram para este projeto.
Como adicionar seu nome:
Se você contribuiu com valores de componentes, informações técnicas ou qualquer outra
ajuda para este projeto, sinta-se à vontade para adicionar seu nome na tabela abaixo.
Esta é uma forma de reconhecimento e agradecimento a todos que dedicaram seu tempo
e conhecimento para tornar este projeto possível.
Todos os campos são OPCIONAIS. Você pode incluir:
- Nome ou apelido
- Um link para email ou rede social
- Uma descrição breve da sua contribuição
A participação é voluntária e anônima. Se preferir não ser citado, basta não preencher a tabela.
Nome / Apelido | Email / Rede Social | Tipo de Contribuição

Sheet: Resistores
Lista de Resistores - TK 3000 IIe
Referência | Valor | Tamanho / Formato | Potência
R1 | 220R | THT 12.7mm
R2 | 100R/1W | THT 20.32mm (1W) | 1W
R3 |  | THT 5.08mm
R4 |  | THT 5.08mm
R5 |  | THT 5.08mm
R6 |  | THT 5.08mm
R7 |  | THT 5.08mm
R8 |  | THT 5.08mm
R11 |  | THT 12.7mm
R17 | 220R | THT 12.7mm
R18 | 1k | THT 12.7mm
R19 | 47R | THT 12.7mm
R20 | 4k7 | THT 12.7mm
R21 | 220R | THT 12.7mm
R22 | 5k6 | THT 12.7mm
R23 | 6k8 | THT 12.7mm
R24 | 6k8 | THT 12.7mm
R25 | 1k | THT 12.7mm
R27 | 220k | THT 12.7mm
R28 | 10k | THT 12.7mm
R29 | 1k | THT 12.7mm
R30 | 1k | THT 12.7mm
R31 | 1k | THT 12.7mm
R32 | 1k | THT 12.7mm
R33 |  | THT 12.7mm
R34 | 120R | THT 5.08mm
R35 | 120R | THT 5.08mm
R36 | 2k2 | THT 12.7mm
R37 |  | THT 5.08mm
R38 |  | THT 5.08mm
R39 |  | THT 5.08mm
R40 |  | THT 5.08mm
R41 | 1k5 | THT 5.08mm
R42 | 1k | THT 5.08mm
R44 | 120R | THT 5.08mm
R45 |  | THT 12.7mm
R46 | 2k2 | THT 5.08mm
R47 | 2k2 | THT 5.08mm
R48 | 2k2 | THT 5.08mm
R49 | 2k2 | THT 5.08mm
R50 | 2k2 | THT 5.08mm
R51 | 2k2 | THT 5.08mm
R52 | 2k2 | THT 5.08mm
R53 | 2k2 | THT 5.08mm
R54 | 2k2 | THT 5.08mm
R55 |  | THT 5.08mm
R56 |  | THT 5.08mm
R57 |  | THT 5.08mm
R58 |  | THT 5.08mm
R59 |  | THT 5.08mm
R60 |  | THT 5.08mm
R61 |  | THT 5.08mm
R62 |  | THT 5.08mm
R63 |  | THT 5.08mm
R64 |  | THT 5.08mm
R65 |  | THT 5.08mm
R66 |  | THT 5.08mm
R67 |  | THT 5.08mm
R68 |  | THT 5.08mm
R69 |  | THT 5.08mm
R70 |  | THT 5.08mm
R71 | 47R | THT 2.54mm
R72 | 470R | THT 2.54mm
R73 |  | THT 2.54mm
R74 |  | THT 5.08mm
R75 |  | THT 5.08mm
R76 | 75R | THT 2.54mm
R77 | 51k | THT 2.54mm
R78 | 3k3 | THT 2.54mm
R79 |  | THT 5.08mm
R80 |  | THT 5.08mm
R81 | 22k | THT 5.08mm
R82 | 22k | THT 5.08mm
R83 | 22k | THT 5.08mm
R84 | 22k | THT 5.08mm
R85 | 22k | THT 5.08mm
R86 | 22k | THT 5.08mm
R87 | 22k | THT 5.08mm
R88 | 22k | THT 5.08mm
R89 | 1k | THT 12.7mm
R90 | 1k | THT 5.08mm
R91 | 1k | THT 5.08mm
R92 | 1k | THT 5.08mm
R93 | 1k | THT 5.08mm
R94 |  | THT 5.08mm
R95 |  | THT 5.08mm
R96 | 1k | THT 5.08mm
R97 |  | THT 5.08mm
R98 |  | THT 2.54mm
R99 |  | THT 2.54mm
R100 |  | THT 2.54mm
R101 |  | THT 2.54mm
R102 |  | THT 5.08mm
R103 |  | THT 5.08mm
R104 |  | THT 5.08mm
R105 |  | THT 5.08mm
R106 |  | THT 5.08mm
R107 | 1k | THT 5.08mm
R108 | 120R | THT 5.08mm
R109 |  | THT 5.08mm
R110 |  | THT 5.08mm
R112 |  | THT 5.08mm
R115 |  | THT 12.7mm
R117 |  | THT 12.7mm
R118 | 1k | THT 12.7mm
R119 |  | THT 12.7mm
R120 | 1k | THT 12.7mm

Sheet: Capacitores
Lista de Capacitores - TK 3000 IIe
Referência | Valor | Tensão | Tipo | Tamanho / Formato
C1 | 10uF |  | Eletrolítico | Eletrolítico 111
C2 |  |  | Cerâmico | Disco 5.08mm
C3 | 10uF |  | Eletrolítico | Eletrolítico 111
C4 |  |  | Cerâmico | Disco 5.08mm
C5 | 10uF |  | Eletrolítico | Eletrolítico 111
C6 |  |  | Cerâmico | Disco 5.08mm
C7 | 10uF |  | Eletrolítico | Eletrolítico Tipo 2
C8 |  |  | Cerâmico | Disco 5.08mm
C9 | 10uF |  | Eletrolítico | Eletrolítico 111
C10 |  |  | Cerâmico | Disco 5.08mm
C11 |  |  | Cerâmico | Disco 5.08mm
C12 |  |  | Cerâmico | Disco 5.08mm
C13 |  |  | Cerâmico | Disco 5.08mm
C14 |  |  | Cerâmico | Disco 5.08mm
C21 | 100nF |  | Cerâmico | Disco 12.7mm
C22 | 100nF |  | Cerâmico | Disco 12.7mm
C23 | 100nF |  | Cerâmico | Disco 12.7mm
C24 | 100nF |  | Cerâmico | Disco 12.7mm
C25 | 100nF |  | Cerâmico | Disco 12.7mm
C26 | 100nF |  | Cerâmico | Disco 12.7mm
C27 | 100nF |  | Cerâmico | Disco 12.7mm
C28 | 100nF |  | Cerâmico | Disco 12.7mm
C29 | 100nF |  | Cerâmico | Disco 5.08mm
C30 | 100nF |  | Cerâmico | Disco 5.08mm
C31 | 100nF |  | Cerâmico | Disco 5.08mm
C32 | 100nF |  | Cerâmico | Disco 5.08mm
C33 | 100nF |  | Cerâmico | Disco 5.08mm
C34 | 100nF |  | Cerâmico | Disco 5.08mm
C35 | 100nF |  | Cerâmico | Disco 5.08mm
C36 | 220pF |  | Cerâmico | Disco 5.08mm
C37 | 100nF |  | Cerâmico | Disco 12.7mm
C38 | 100nF |  | Cerâmico | Disco 12.7mm
C39 | 100nF |  | Cerâmico | Disco 12.7mm
C40 | 100nF |  | Cerâmico | Disco 12.7mm
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
C109 | 100nF |  | Cerâmico | Disco 12.7mm
C110 | 10uF |  | Eletrolítico | Eletrolítico C110
C111 |  |  | Eletrolítico | Eletrolítico 111
C112 | 100nF |  | Cerâmico | Disco 5.08mm
C113 | 100nF |  | Cerâmico | Disco 5.08mm
C120 |  |  | Cerâmico | Disco 5.08mm
C208 |  |  | Cerâmico | Disco 5.08mm

Sheet: Indutores
Lista de Indutores - TK 3000 IIe
Referência | Valor | Tamanho / Formato
L1 |  | THT
L2 |  | THT
L3 |  | THT
L4 | 27uH | THT 7.62mm

Sheet: Transistores
Lista de Transistores - TK 3000 IIe
Referência | Valor | Tamanho / Formato
Q2 | BC558 | TO-92
Q3 | BC548 | TO-92
Q4 | BF494 | TO-92
Q5 | BC548 | TO-92
Q6 | BC548 | TO-92
Q7 | BC558 | TO-92

Sheet: Diodos
Lista de Diodos - TK 3000 IIe
Referência | Valor | Tamanho / Formato | Potência
D4 | 1N914 | DO-35 (5.08mm) | 0.3W (máx.)
D5 | 1N914 | DO-35 (5.08mm) | 0.3W (máx.)
D6 | 1N914 | DO-35 (5.08mm) | 0.3W (máx.)
D7 | 1N914 | DO-35 (5.08mm) | 0.3W (máx.)
D8 | 1N914 | DO-35 (5.08mm) | 0.3W (máx.)
D9 | 1N914 | DO-35 (5.08mm) | 0.3W (máx.)
D10 | 1N914 | DO-35 (5.08mm) | 0.3W (máx.)
D11 | 1N914 | DO-35 (5.08mm) | 0.3W (máx.)
D12 | 1N914 | DO-35 (5.08mm) | 0.3W (máx.)
D13 | 1N914 | DO-35 (5.08mm) | 0.3W (máx.)
D14 | 1N914 | DO-35 (5.08mm) | 0.3W (máx.)
D15 | 1N914 | DO-35 (5.08mm) | 0.3W (máx.)
D16 | 1N914 | DO-35/DO-41 (12.7mm) | 0.3W (máx.)
D17 | 1N914 | DO-35/DO-41 (12.7mm) | 1W (máx.)
D18 | 1N914 | DO-35 | 0.3W (máx.)
D19 | 1N914 | DO-35 (5.08mm) | 0.3W (máx.)
D20 | 1N914 | DO-35 (5.08mm) | 0.3W (máx.)
D21 | 1N914 | DO-35 (5.08mm) | 0.3W (máx.)
D22 | 1N914 | DO-35 (5.08mm) | 0.3W (máx.)
D23 | 1N914 | DO-35 (5.08mm) | 0.3W (máx.)
D26 | 1N914 | DO-35/DO-41 (12.7mm) | 1W (máx.)
D27 | 1N914 | DO-35/DO-41 (12.7mm) | 1W (máx.)
D30 | 1N914 | DO-35 (5.08mm) | 1W (máx.)
D31 | 1N914 | DO-35/DO-41 (12.7mm) | 0.3W (máx.)
