clemarfolly/TK3000/KiCad/TK3000/production/bom.csv

Designator | Footprint | Quantity | Value | LCSC Part #
C1, C111, C3, C5, C79, C82, C9 | C_Elet_111 | 7 | 10uF
C10, C11, C12, C13 | C_Disc_5.08 | 4 | 22nF
C100 | C_Disc_C100 | 1 | 100nF
C101, C112, C113, C2, C208, C29, C30, C31, C32, C33, C34, C35, C4, C57, C6, C8 | C_Disc_5.08 | 16 | 100nF
C102, C103, C104, C105, C106, C107, C108, C109, C21, C23, C24, C25, C26, C27, C28, C37, C38, C39, C40, C41, C42, C43, C47, C48, C49, C50, C51, C52, C53, C55, C58, C59, C64, C66, C67, C68, C69, C71, C72, C73, C74, C77, C78, C84, C86, C89, C90, C91, C92, C93 | C_Disc_5.08_12.7mm | 50 | 100nF
C110 | C_Elet_C110 | 1 | 10uF
C120, C87 | C_Disc_5.08 | 2 | C
C14 | C_Disc_5.08 | 1 | 47nF
C22, C56, C76, C85, C88 | C_Disc_12.7mm | 5 | 100nF
C36, C80, C81, C97 | C_Disc_5.08 | 4 | 220pF
C44, C94, C95 | C_Disc_5.08 | 3 | 100pF
C45 | C_Disc_5.08 | 1 | 47pF
C46, C7, C70, C83 | C_Elet_Tipo2 | 4 | 10uF
C60 | C_Disc_5.08 | 1 | 100n
C65 | C65_Disc_5.08_12.7mm | 1 | 100nF
C98 | CP_Disc_5.08 | 1 | 10uF
C99 | C_Disc_5.08 | 1 | 33pF
D10, D11, D12, D13, D14, D15, D19, D20, D21, D22, D23, D30, D4, D5, D6, D7, D8, D9 | D_5.08 | 18 | 1N914
D16, D17, D26, D27, D31 | D_12.7 | 5 | 1N914
D18 | D_D18 | 1 | 1N914
J0 | SLOT-60_W5.08 | 1 | ~
J1, J2, J3, J4, J5, J6, J7 | SLOT-50_W5.08 | 7 | ~
J10 | EarJack | 1 | EAR
J11 | RCA_AV-8,4-5A | 1 | ~
J12 | J12 | 1 | Conn_01x01_Pin
J13 | J13 | 1 | J13
J14 | J14 | 1 | Power Connector
J15 | GAME_IO | 1 | ~
J16 | J16 | 1 | J16
J17 | J17 | 1 | J17
J18 | J18 | 1 | Alto-Falante
J19 | PinHeader_1x02_P2.54mm_Vertical | 1 | Conn_01x02_Pin
J8 | DB9 | 1 | DE9_Socket
J9 | EarJack | 1 | EAR/MIC
L1, L2, L3 | Ind | 3 | Ind
L4 | Ind_762 | 1 | 47uH
LED1 | led1 | 1 | LED
LED2 | led2 | 1 | LED
Q2, Q7 | BC558 | 2 | BC558
Q3, Q5, Q6 | BC548 | 3 | BC548
Q4 | BF494 | 1 | BF494
R1, R17, R21 | Resistor_P12.70mm_Horizontal | 3 | 220R
R100, R101, R98, R99 | Resistor_P2.54mm_Vertical | 4 | 1k
R102, R46, R47, R48, R49, R50, R51, R52, R53, R54, R63, R64, R65, R66, R67, R68, R69, R70 | Resistor_P5.08mm_Vertical | 18 | 2k2
R103, R104, R105, R106, R107, R109, R110, R112, R41, R42, R55, R56, R57, R58, R59, R60, R61, R62, R90, R91, R92, R93, R94, R96, R97 | Resistor_P5.08mm_Vertical | 25 | 1k
R108, R34, R35, R44 | Resistor_P5.08mm_Vertical | 4 | 120R
R11 | Resistor_P12.70mm_Horizontal | 1 | 100R
R115, R117, R118, R120, R18, R25, R29, R30, R31, R32, R89 | Resistor_P12.70mm_Horizontal | 11 | 1k
R119 | Resistor_P12.70mm_Horizontal | 1 | 470R
R19 | Resistor_P12.70mm_Horizontal | 1 | 47R
R2 | Res_20.32 | 1 | 100R/1W
R20, R33 | Resistor_P12.70mm_Horizontal | 2 | 4k7
R22 | Resistor_P12.70mm_Horizontal | 1 | 5k6
R23, R24 | Resistor_P12.70mm_Horizontal | 2 | 6k8
R27 | Resistor_P12.70mm_Horizontal | 1 | 220k
R28 | Resistor_P12.70mm_Horizontal | 1 | 10k
R3, R4, R5, R6, R7, R74 | Resistor_P5.08mm_Vertical | 6 | 100R
R36, R45 | Resistor_P12.70mm_Horizontal | 2 | 2k2
R37, R38, R39, R40 | Resistor_P5.08mm_Vertical | 4 | 220
R71 | Resistor_P2.54mm_Vertical | 1 | 47R
R72 | Resistor_P2.54mm_Vertical | 1 | 470R
R73 | Resistor_P2.54mm_Vertical | 1 | 22k
R75 | Resistor_P5.08mm_Vertical | 1 | 33R
R76 | Resistor_P2.54mm_Vertical | 1 | 75R
R77 | Resistor_P2.54mm_Vertical | 1 | 51k
R78 | Resistor_P2.54mm_Vertical | 1 | 3k3
R79, R95 | Resistor_P5.08mm_Vertical | 2 | 47R
R8 | Resistor_P5.08mm_Vertical | 1 | 12k
R80, R81, R82, R83, R84, R85, R86, R87, R88 | Resistor_P5.08mm_Vertical | 9 | 22k
UC1 | DIP-40_W15.24mm | 1 | 6502
UC13 | DIP-14_W7.62mm | 1 | 74LS74
UE1, UE2 | DIP-20_W7.62mm | 2 | 74LS244
UE10 | UE10_DIP-14_W7.62mm | 1 | 74LS32
UE11 | UE11_DIP-14_W7.62mm | 1 | 74LS74
UE13 | DIP-28_W15.24mm | 1 | 27C128
UE15 | DIP-40_W15.24mm | 1 | Z80A
UE4 | UE4_DIP-16_W7.62mm | 1 | 74LS138
UE5, UE6 | DIP-16_W7.62mm | 2 | 74LS138
UE7 | DIP-16_W7.62mm | 1 | 74LS251
UE8 | DIP-16_W7.62mm | 1 | NE558
UE9 | UE9_DIP-14_W7.62mm | 1 | 74LS32
UF1 | DIP-14_W7.62mm | 1 | 74LS125
UF10 | DIP-14_W7.62mm | 1 | 74LS00
UF11 | DIP-14_W7.62mm | 1 | 74LS08
UF12 | RAM_F12-13 | 1 | 2 x 2114
UF2 | DIP-14_W7.62mm | 1 | 74S02
UF4 | ROM_F4-F6 | 1 | 27128
UF7 | UF7_DIP-28_W15.24mm | 1 | 27C64
UF9 | DIP-14_W7.62mm | 1 | 74LS86
UG1 | UG1_DIP-20_W7.62mm | 1 | PAL16R8
UH1 | DIP-16_W7.62mm | 1 | 74S109
UH10 | DIP-20_W7.62mm | 1 | 74LS245
UH11, UH9 | DIP-20_W7.62mm | 2 | 74LS374
UH12 | DIP-16_W7.62mm | 1 | 74LS259
UH13 | DIP-16_W7.62mm | 1 | 74LS365
UH4 | UH4_DIP-40_W15.24mm | 1 | MMU
UH6 | UH6_DIP-40_W15.24mm | 1 | IOU
UH8 | UH8_DIP-16_W7.62mm | 1 | 74LS166
UJ7 | RAM_J7-J14 | 1 | NMC3764
X25, X7 | Jumper_2_Open | 2 | Jumper_2_Open
Y1 | XTAL | 1 | 14.30244 MHz
