clemarfolly/TK3000/KiCad/TK3000/3d/RAM_J7-J14_W7.62mm.step

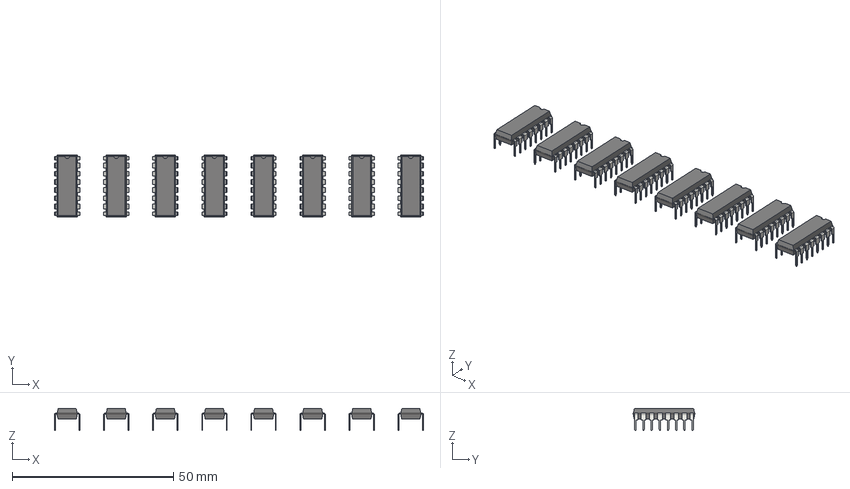
[picture p42: CAD file, 2026-08-10]
KiCad/TK3000/3d/RAM_J7-J14_W7.62mm.step
114.6 x 19.2 x 6.98 mm
DIP-16_W7.62mm
DIP-16_W7.62mm001
DIP-16_W7.62mm002
DIP-16_W7.62mm003
DIP-16_W7.62mm004
DIP-16_W7.62mm005
DIP-16_W7.62mm006
DIP-16_W7.62mm007
