clemarfolly/TK3000/Apoio/elementos_teste.txt

TRACK,LAYER=1,WIDTH=2500,P0=1291168/1310749,P1=1303001/1310749,P2=1318500/1295250,P3=1420846/1294480,P4=1432616/1286749,P5=1622883/1286863,P6=1640320/1299067,P7=1824271/1299636,P8=1843500/1317500,P9=2122025/1317500,P10=2122624/1318100;
TRACK,LAYER=1,WIDTH=2500,P0=2226598/1319175,P1=2218214/1319175,P2=2216346/1317308,P3=2138846/1317308,P4=2128077/1306538,P5=2113846/1306538,P6=2110384/1310000,P7=1845858/1309773,P8=1825962/1291923,P9=1642820/1291809,P10=1627500/1281154,P11=1431923/1280576,P12=1419423/1288077,P13=1298668/1288078,P14=1272515/1309349,P15=1154472/1308565,P16=1144808/1315385,P17=1027550/1315385,P18=1018763/1306598;
TRACK,LAYER=1,WIDTH=2500,P0=1036289/1304948,P1=1042670/1304948,P2=1046894/1309172,P3=1142328/1309172,P4=1149000/1302500,P5=1272500/1302500,P6=1294000/1281000,P7=1417225/1281175,P8=1428000/1274250,P9=1628831/1275046,P10=1647635/1286000,P11=1830611/1286113,P12=1849452/1304500,P13=2107250/1304500,P14=2113250/1298500,P15=2131000/1298500,P16=2139500/1307000,P17=2206402/1307000,P18=2207629/1305773;
