clemarfolly/TK3000/(list of files, drawings)

Other design files:
SprintLayout/TK3000.lay6
