clemarfolly/TK3000/KiCad/TK3000/TK3000.kicad_pcb

## KiCad design KiCad/TK3000/TK3000.kicad_pcb (2026-10-20)

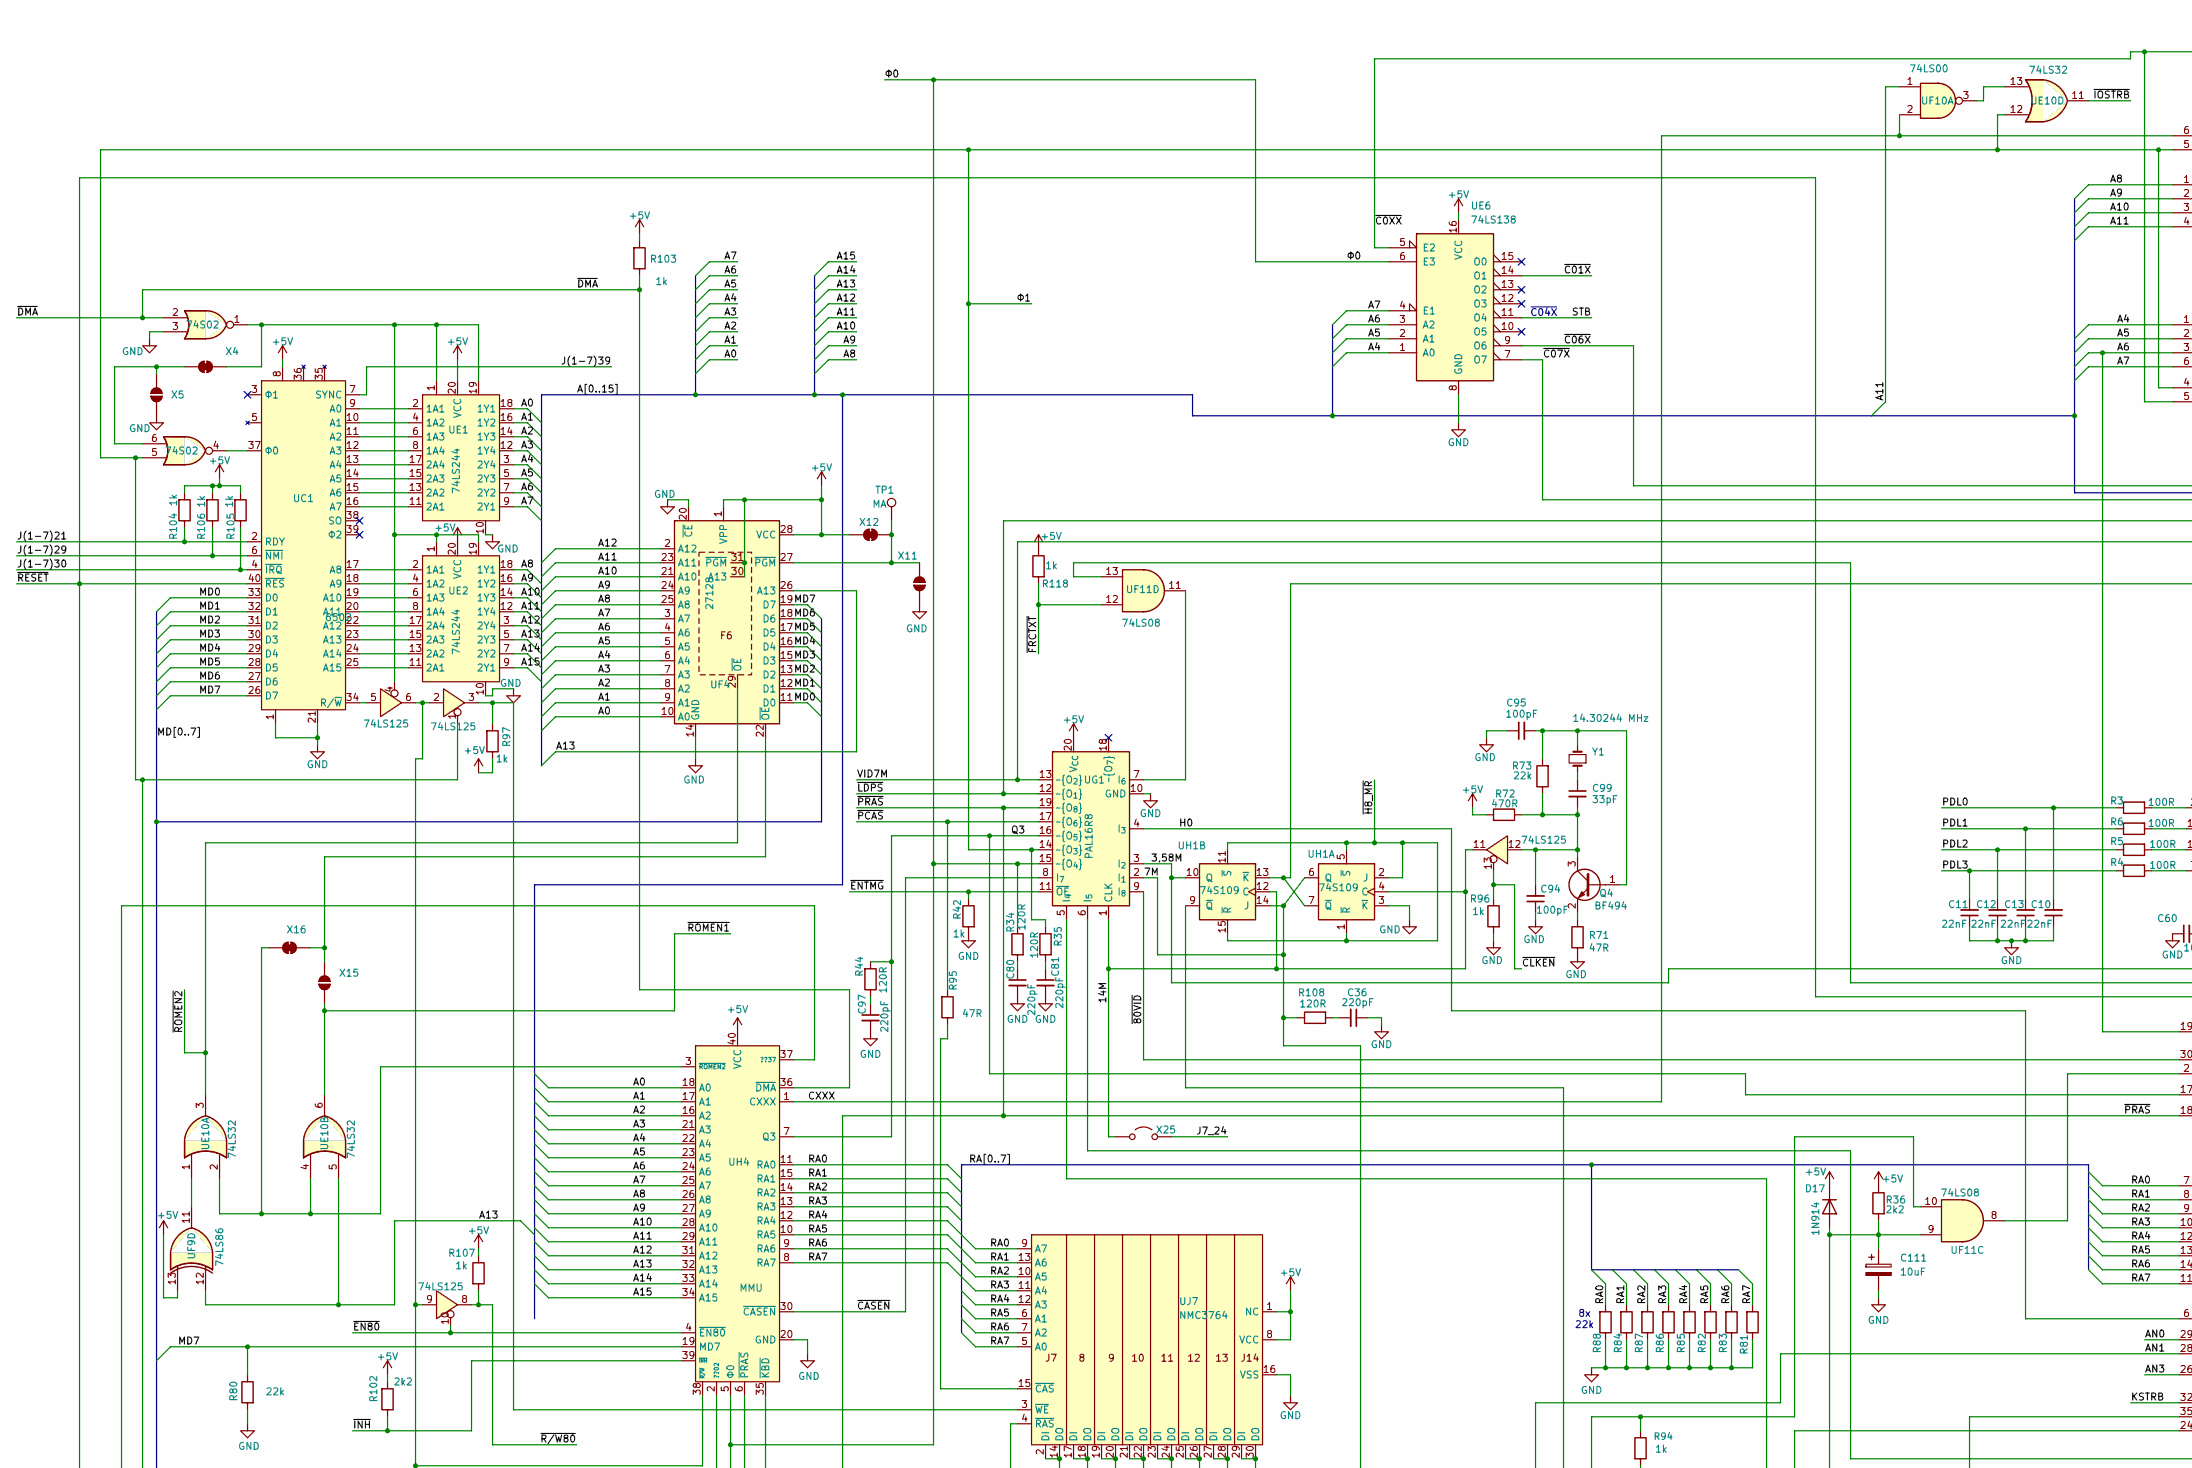
[picture p43: schematic TK3000.kicad_sch, Microdigital TK 3000 IIe, part in row 1, column 1]

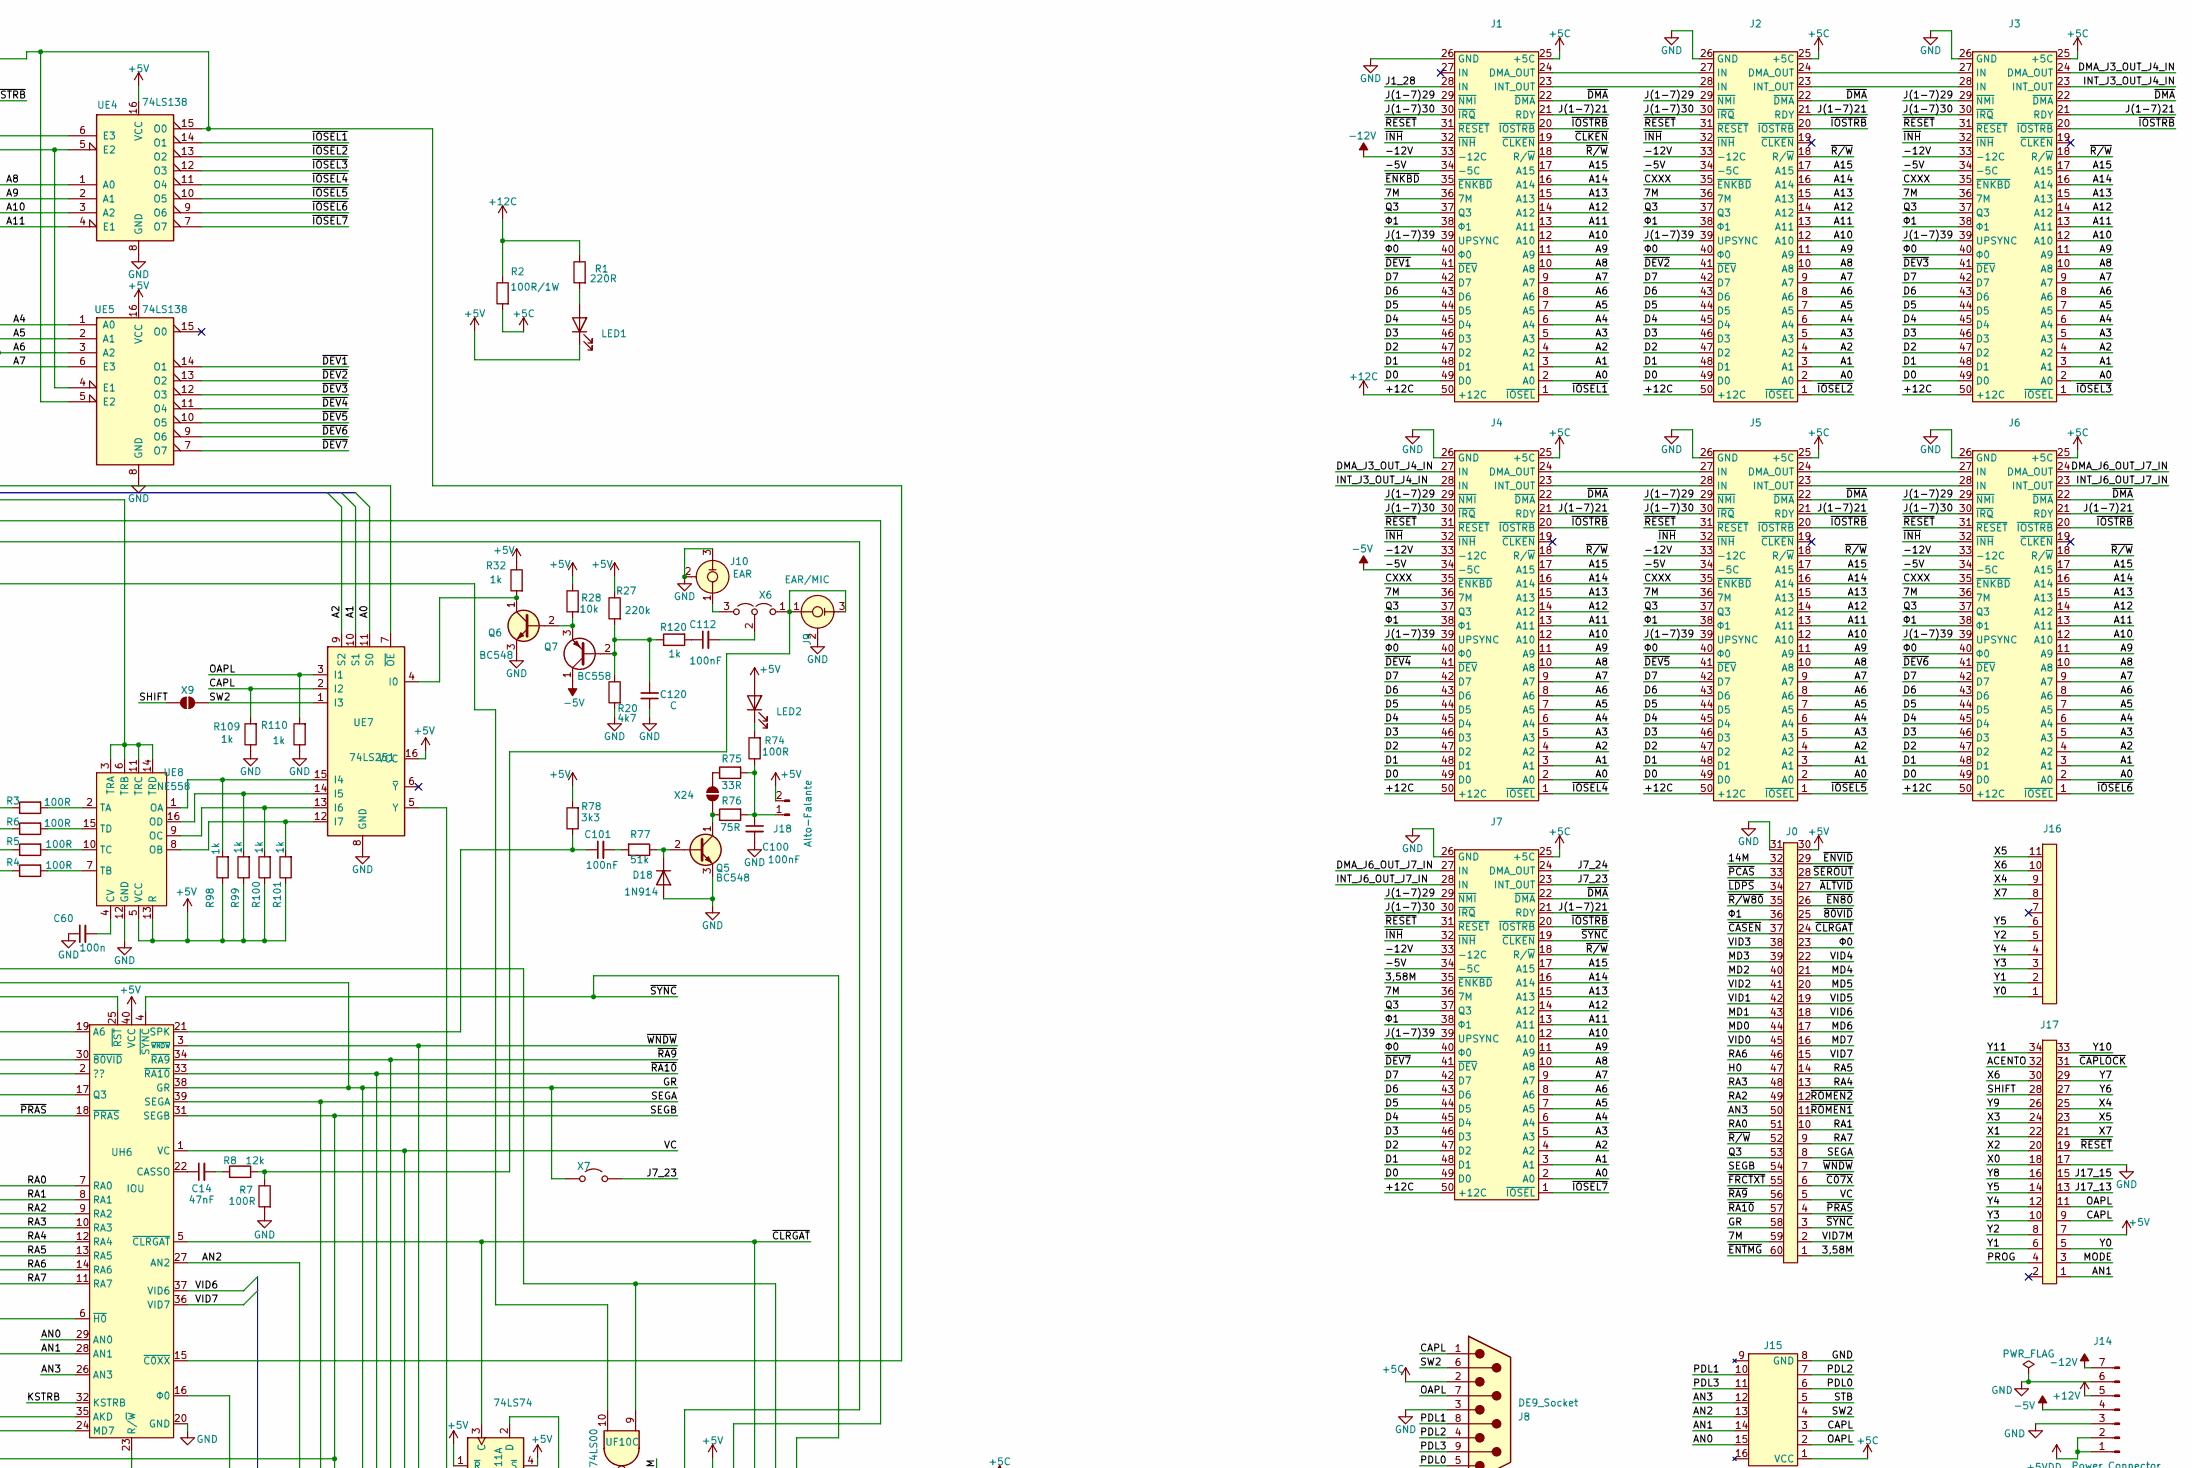
[picture p44: schematic TK3000.kicad_sch, Microdigital TK 3000 IIe, part in row 1, column 2]

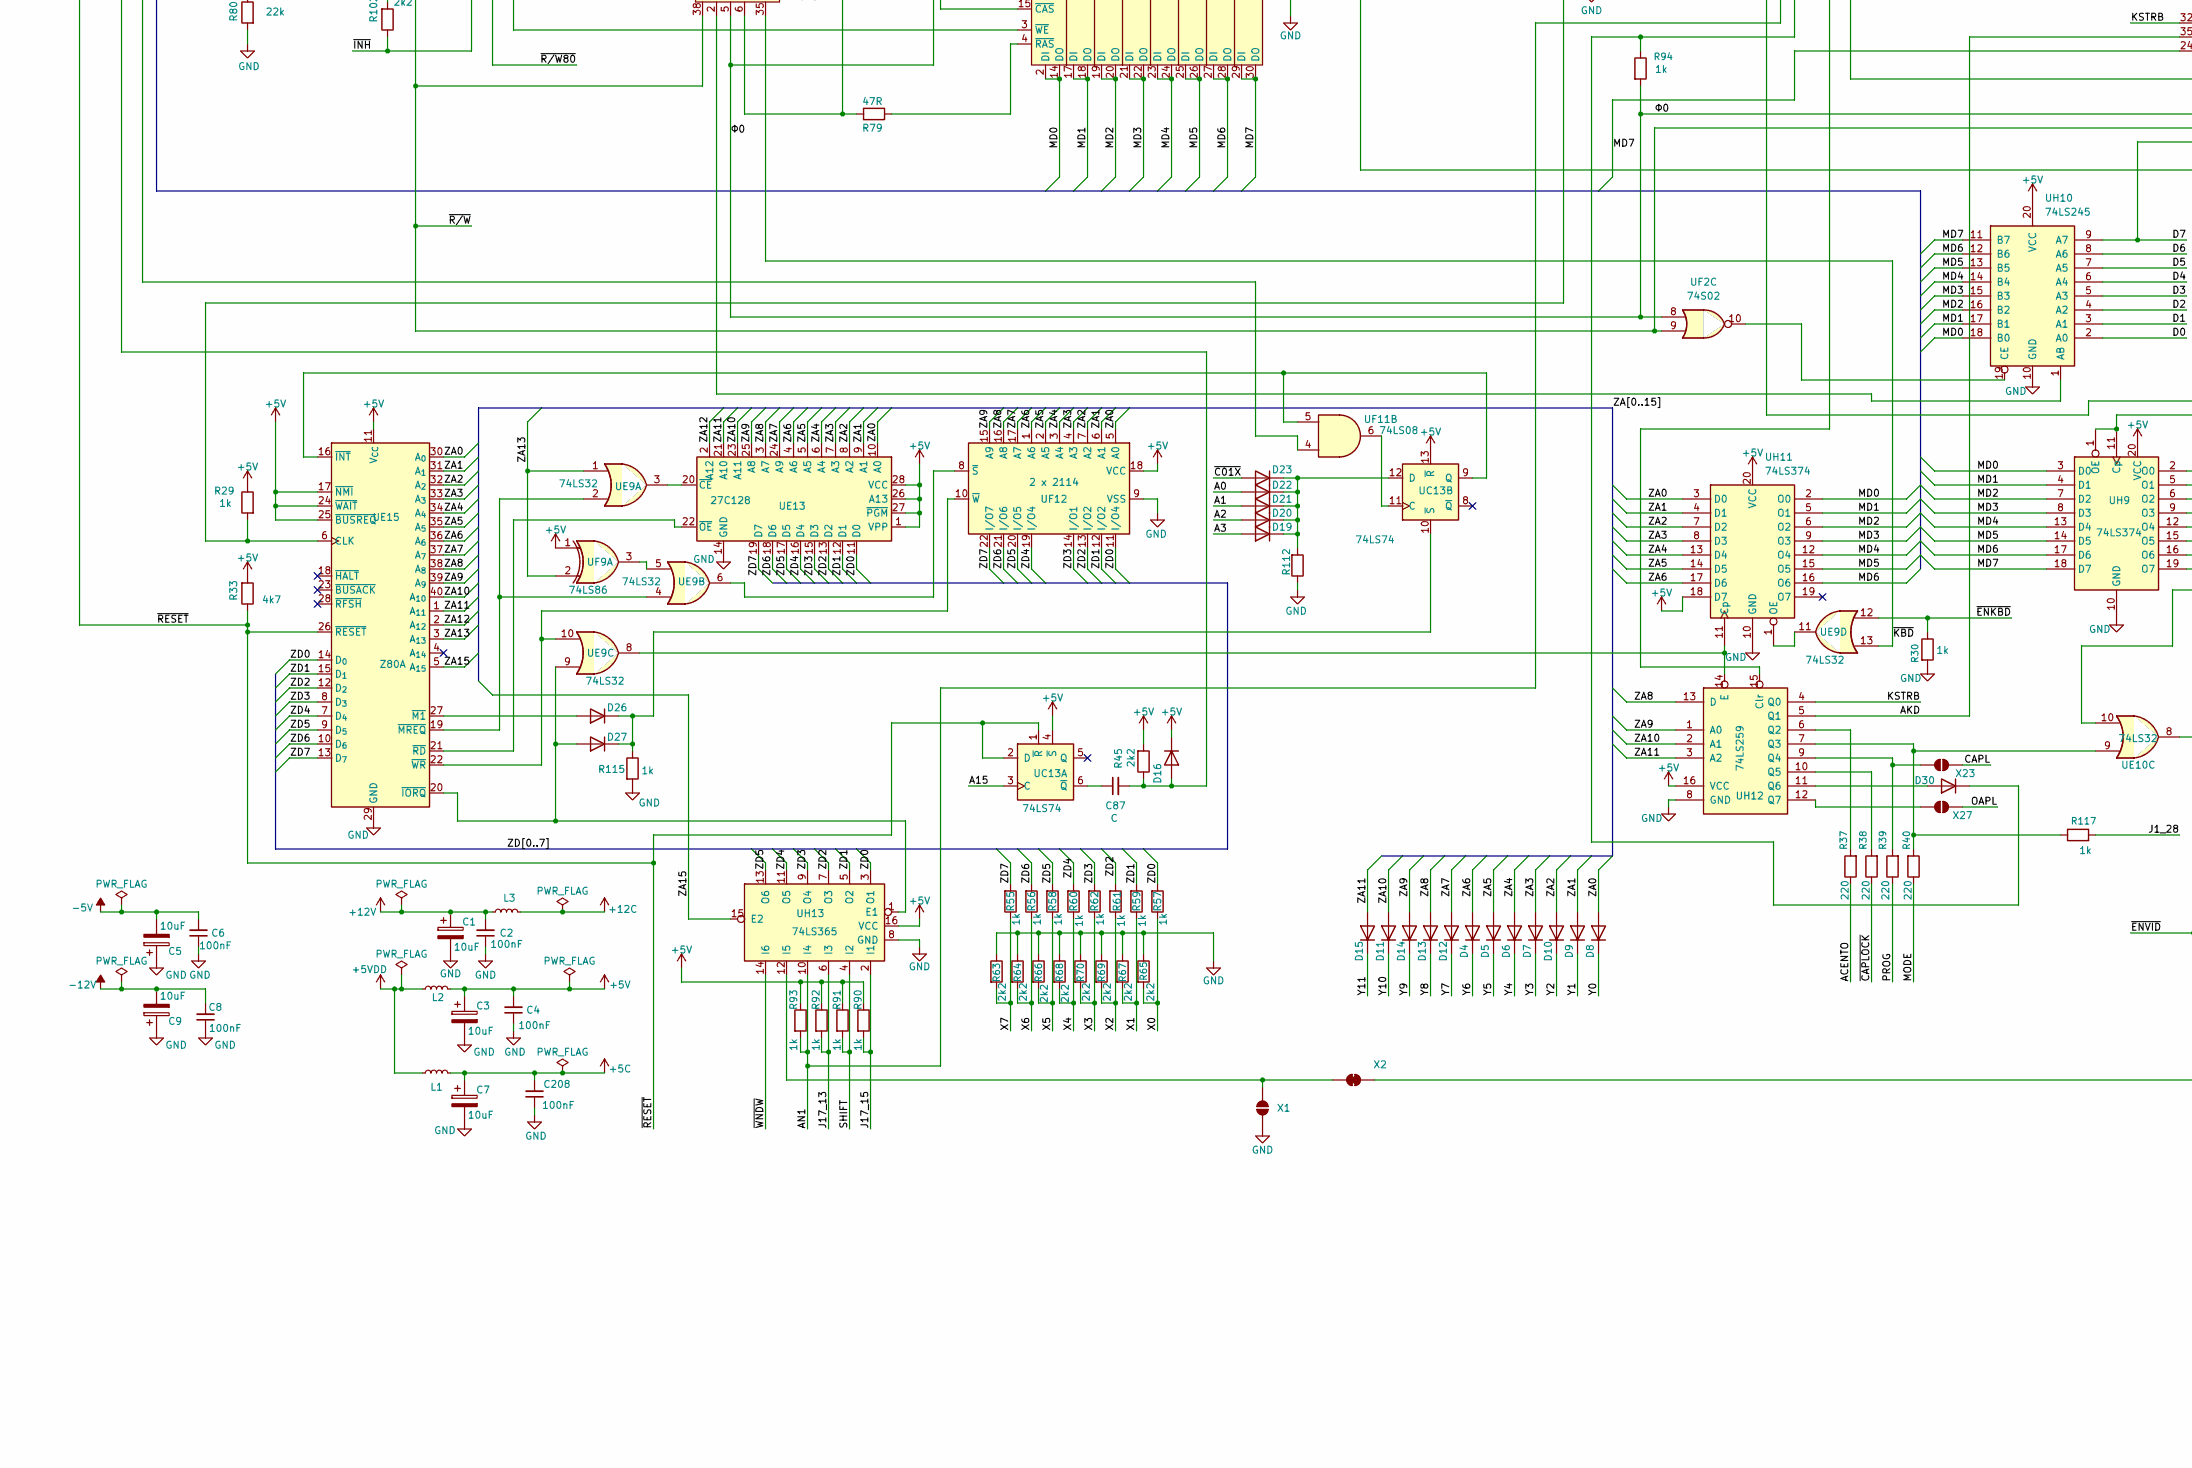
[picture p45: schematic TK3000.kicad_sch, Microdigital TK 3000 IIe, part in row 2, column 1]

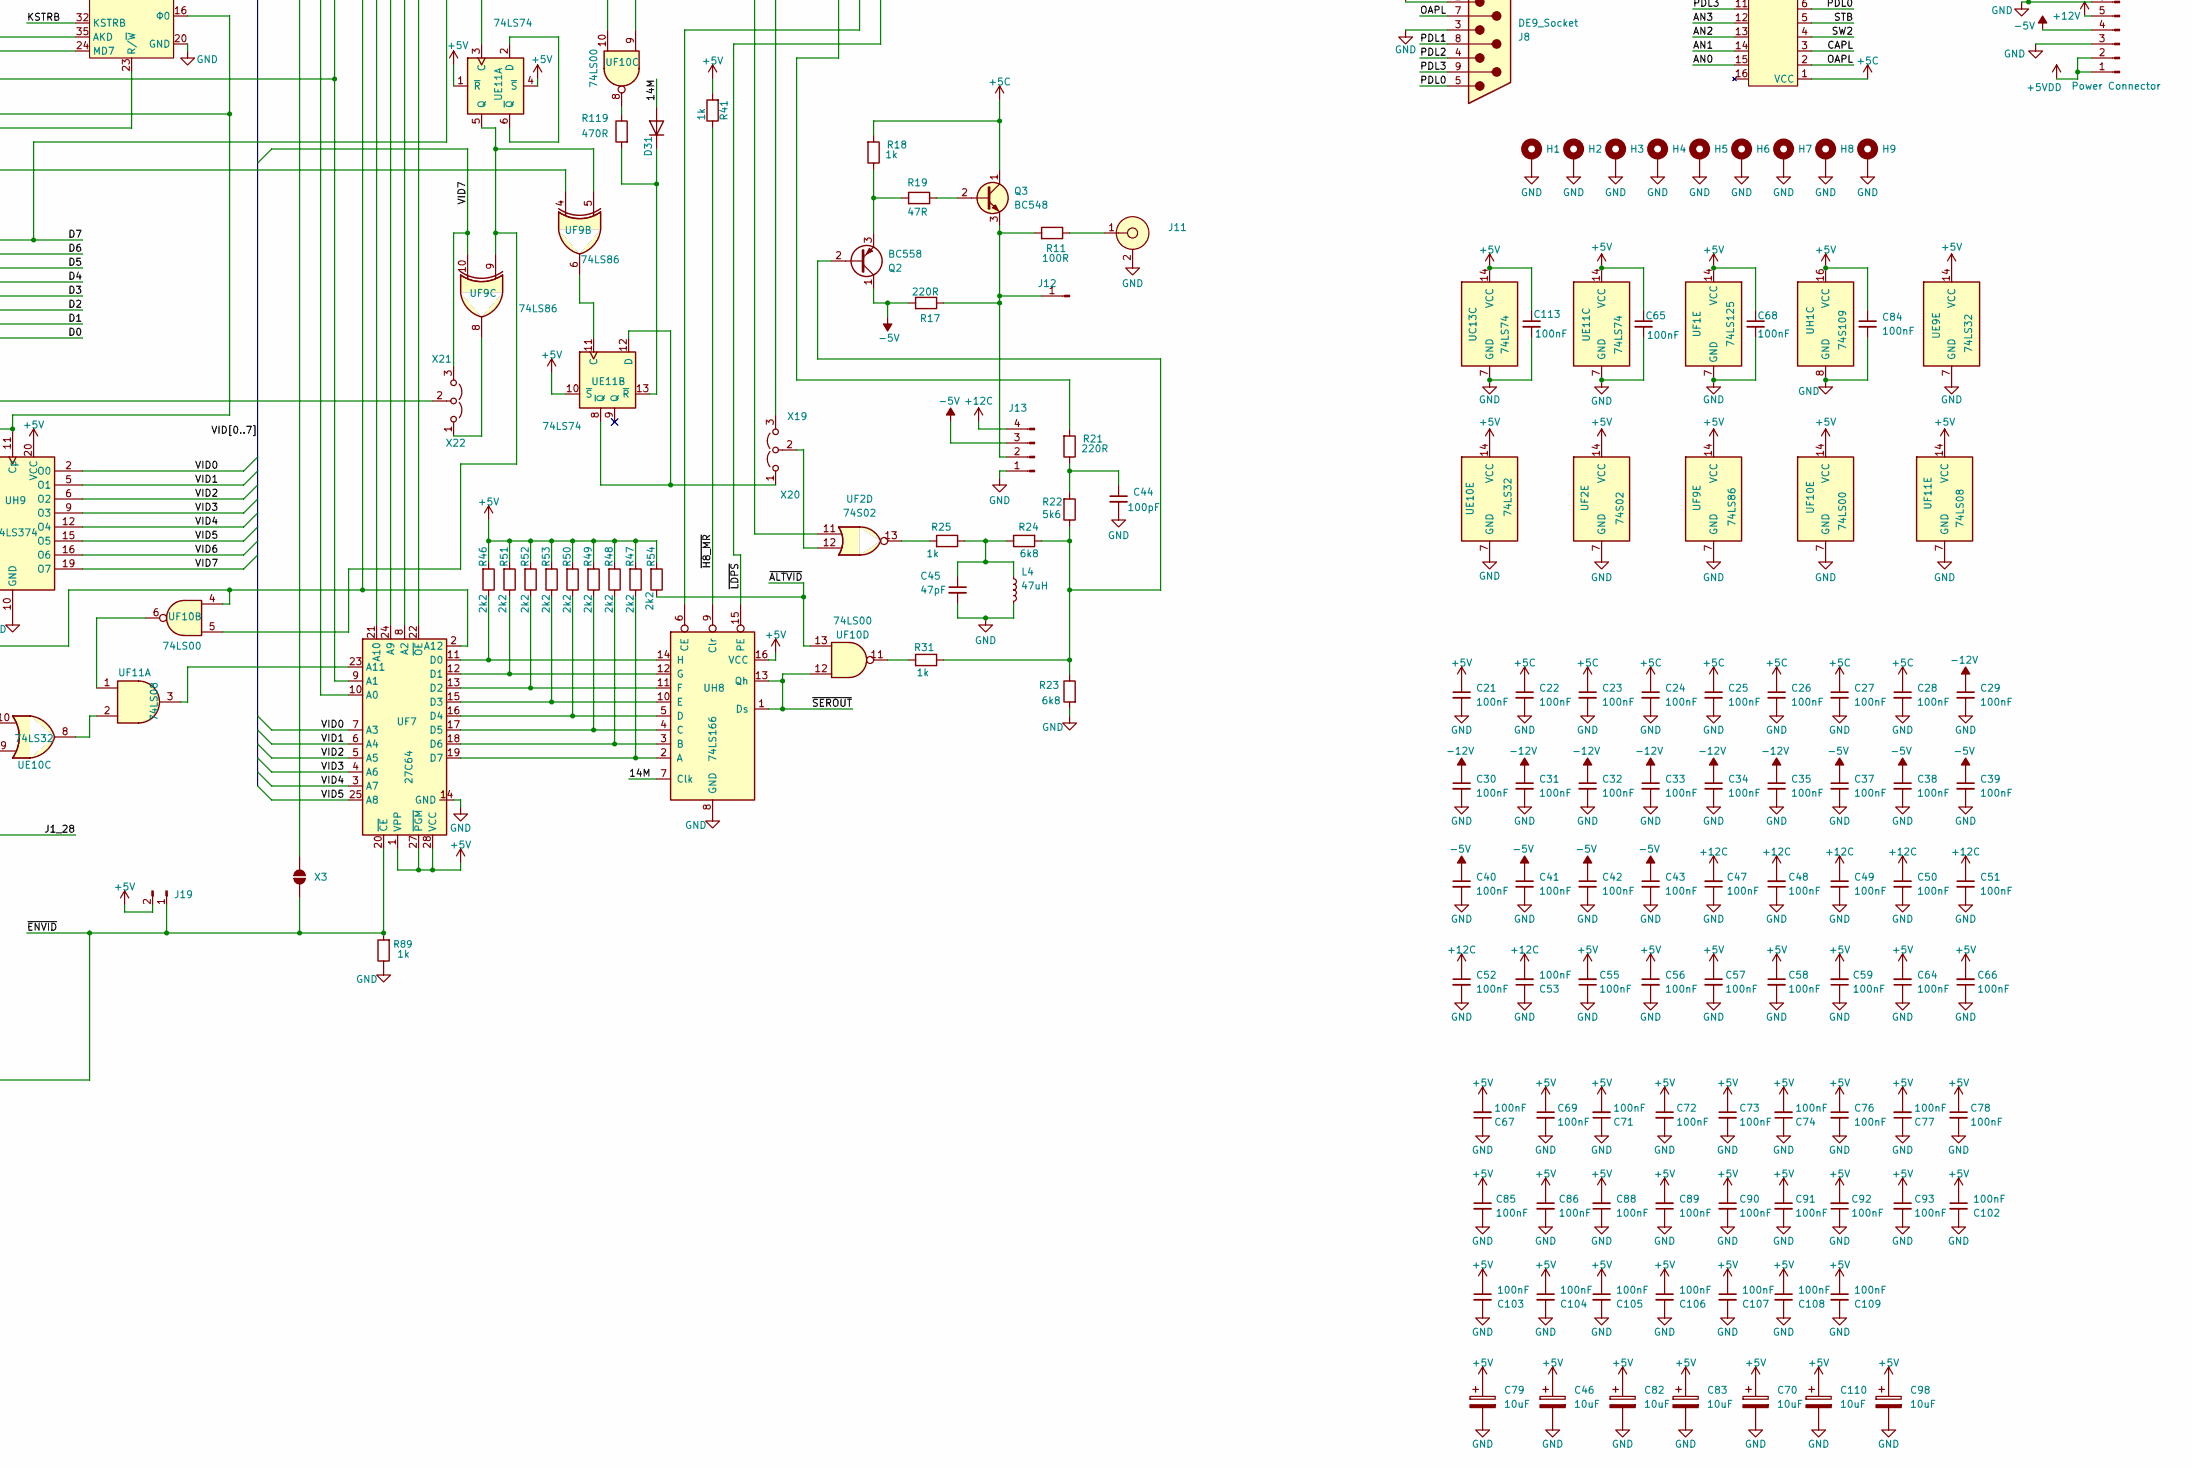
[picture p46: schematic TK3000.kicad_sch, Microdigital TK 3000 IIe, part in row 2, column 2]

Parts:
C1, C3, C5, C9, C79, C82, C111: 10uF; C_Elet_111
C2, C4, C6, C8, C29, C30, C31, C32, C33, C34, C35, C57, C101, C112, C113, C208: 100nF; C_Disc_5.08
C7, C46, C70, C83: 10uF; C_Elet_Tipo2
C10, C11, C12, C13: 22nF; C_Disc_5.08
C14: 47nF; C_Disc_5.08
C21, C23, C24, C25, C26, C27, C28, C37, C38, C39, C40, C41, C42, C43, C47, C48, C49, C50, C51, C52, C53, C55, C58, C59, C64, C66, C67, C68, C69, C71, C72, C73, C74, C77, C78, C84, C86, C89, C90, C91, C92, C93, C102, C103, C104, C105, C106, C107, C108, C109: 100nF; C_Disc_5.08_12.7mm
C22, C56, C76, C85, C88: 100nF; C_Disc_12.7mm
C36, C80, C81, C97: 220pF; C_Disc_5.08
C44, C94, C95: 100pF; C_Disc_5.08
C45: 47pF; C_Disc_5.08
C60: 100n; C_Disc_5.08
C65: 100nF; C65_Disc_5.08_12.7mm
C87, C120: C; C_Disc_5.08
C98: 10uF; CP_Disc_5.08
C99: 33pF; C_Disc_5.08
C100: 100nF; C_Disc_C100
C110: 10uF; C_Elet_C110
D4, D5, D6, D7, D8, D9, D10, D11, D12, D13, D14, D15, D19, D20, D21, D22, D23, D30: 1N914; D_5.08
D16, D17, D26, D27, D31: 1N914; D_12.7
D18: 1N914; D_D18
H1, H9: MountingHole_Pad; Furo_8mm_5mm
H2, H3, H4: MountingHole_Pad; Furo_7mm_4mm
H5, H6, H7, H8: MountingHole_Pad; Furo_5mm_3mm
J0: SLOT-60_W5.08
J1, J2, J3, J4, J5, J6, J7: SLOT-50_W5.08
J8: DE9_Socket; DB9
J9: EAR/MIC; EarJack
J10: EAR; EarJack
J11: RCA_AV-8,4-5A
J12: Conn_01x01_Pin; J12
J13: J13
J14: Power Connector; J14
J15: GAME_IO
J16: J16
J17: J17
J18: Alto-Falante; J18
J19: Conn_01x02_Pin; PinHeader_1x02_P2.54mm_Vertical
L1, L2, L3: Ind
L4: 47uH; Ind_762
LED1: LED; led1
LED2: LED; led2
Q2, Q7: BC558
Q3, Q5, Q6: BC548
Q4: BF494
R1, R17, R21: 220R; Resistor_P12.70mm_Horizontal
R2: 100R/1W; Res_20.32
R3, R4, R5, R6, R7, R74: 100R; Resistor_P5.08mm_Vertical
R8: 12k; Resistor_P5.08mm_Vertical
R11: 100R; Resistor_P12.70mm_Horizontal
R18, R25, R29, R30, R31, R32, R89, R115, R117, R118, R120: 1k; Resistor_P12.70mm_Horizontal
R19: 47R; Resistor_P12.70mm_Horizontal
R20, R33: 4k7; Resistor_P12.70mm_Horizontal
R22: 5k6; Resistor_P12.70mm_Horizontal
R23, R24: 6k8; Resistor_P12.70mm_Horizontal
R27: 220k; Resistor_P12.70mm_Horizontal
R28: 10k; Resistor_P12.70mm_Horizontal
R34, R35, R44, R108: 120R; Resistor_P5.08mm_Vertical
R36, R45: 2k2; Resistor_P12.70mm_Horizontal
R37, R38, R39, R40: 220; Resistor_P5.08mm_Vertical
R41, R42, R55, R56, R57, R58, R59, R60, R61, R62, R90, R91, R92, R93, R94, R96, R97, R103, R104, R105, R106, R107, R109, R110, R112: 1k; Resistor_P5.08mm_Vertical
R46, R47, R48, R49, R50, R51, R52, R53, R54, R63, R64, R65, R66, R67, R68, R69, R70, R102: 2k2; Resistor_P5.08mm_Vertical
R71: 47R; Resistor_P2.54mm_Vertical
R72: 470R; Resistor_P2.54mm_Vertical
R73: 22k; Resistor_P2.54mm_Vertical
R75: 33R; Resistor_P5.08mm_Vertical
R76: 75R; Resistor_P2.54mm_Vertical
R77: 51k; Resistor_P2.54mm_Vertical
R78: 3k3; Resistor_P2.54mm_Vertical
R79, R95: 47R; Resistor_P5.08mm_Vertical
R80, R81, R82, R83, R84, R85, R86, R87, R88: 22k; Resistor_P5.08mm_Vertical
R98, R99, R100, R101: 1k; Resistor_P2.54mm_Vertical
R119: 470R; Resistor_P12.70mm_Horizontal
TP1: MA; TestPoint
UC1: 6502; DIP-40_W15.24mm
UC13: 74LS74; DIP-14_W7.62mm
UE1, UE2: 74LS244; DIP-20_W7.62mm
UE4: 74LS138; UE4_DIP-16_W7.62mm
UE5, UE6: 74LS138; DIP-16_W7.62mm
UE7: 74LS251; DIP-16_W7.62mm
UE8: NE558; DIP-16_W7.62mm
UE9: 74LS32; UE9_DIP-14_W7.62mm
UE10: 74LS32; UE10_DIP-14_W7.62mm
UE11: 74LS74; UE11_DIP-14_W7.62mm
UE13: 27C128; DIP-28_W15.24mm
UE15: Z80A; DIP-40_W15.24mm
UF1: 74LS125; DIP-14_W7.62mm
UF2: 74S02; DIP-14_W7.62mm
UF4: 27128; ROM_F4-F6
UF7: 27C64; UF7_DIP-28_W15.24mm
UF9: 74LS86; DIP-14_W7.62mm
UF10: 74LS00; DIP-14_W7.62mm
UF11: 74LS08; DIP-14_W7.62mm
UF12: 2 x 2114; RAM_F12-13
UG1: PAL16R8; UG1_DIP-20_W7.62mm
UH1: 74S109; DIP-16_W7.62mm
UH4: MMU; UH4_DIP-40_W15.24mm
UH6: IOU; UH6_DIP-40_W15.24mm
UH8: 74LS166; UH8_DIP-16_W7.62mm
UH9, UH11: 74LS374; DIP-20_W7.62mm
UH10: 74LS245; DIP-20_W7.62mm
UH12: 74LS259; DIP-16_W7.62mm
UH13: 74LS365; DIP-16_W7.62mm
UJ7: NMC3764; RAM_J7-J14
X1, X3, X5, X9, X15, X23, X27: SolderJumper_2_Open; Jumper_Aberto
X2, X4, X16: SolderJumper_2_Bridged; Jumper_Fechado
X6: PinHeader_1x03_P2.54mm_Vertical
X7, X25: Jumper_2_Open
X11: X11; Jumper_Aberto
X12: SolderJumper_2_Bridged; JP12
X19: X20; PinHeader_1x03_P2.54mm_Vertical
X21: X22; PinHeader_1x03_P2.54mm_Vertical
X24: SolderJumper_2_Open; X24
Y1: 14.30244 MHz; XTAL

Connections:
+5C: C7.1, C22.1, C23.1, C24.1, C25.1, C26.1, C27.1, C28.1, C208.2, J1.25 (+5C), J2.25 (+5C), J3.25 (+5C), J4.25 (+5C), J5.25 (+5C), J6.25 (+5C), J7.25 (+5C), J8.2, J15.1 (VCC), L1.2, Q3.1 (C), R2.1, R18.1
+5V: C3.1, C4.2, C21.1, C46.1, C55.2, C56.1, C57.1, C58.1, C59.2, C64.2, C65.1, C66.2, C67.2, C68.1, C69.1, C70.1, C71.2, C72.1, C73.1, C74.2, C76.1, C77.2, C78.1, C79.1, C82.1, C83.1, C84.1, C85.1, C86.1, C88.2, C89.2, C90.1, C91.1, C92.2, C93.1, C98.1, C102.1, C103.1, C104.1, C105.1, C106.1, C107.1, C108.1, C109.1, C110.1, C113.1, D16.1 (K), D17.1 (K), J0.30, J17.7, J18.2, J19.2, L2.2, LED1.1 (K), LED2.2 (A), R27.2, R28.2, R29.2, R32.2, R33.1, R36.2, R41.1, R45.1, R46.1, R47.1, R48.1, R49.1, R50.1, R51.1, R52.1, R53.1, R54.1, R72.1, R78.1, R90.2, R91.2, R92.2, R93.2, R97.2, R98.2, R99.2, R100.2, R101.2, R102.1, R103.1, R104.1, R105.1, R106.1, R107.2, R118.2, UC1.8, UC13.4 (~S), UC13.13 (~R), UC13.14 (VCC), UE1.20 (VCC), UE2.20 (VCC), UE4.16 (VCC), UE5.16 (VCC), UE6.16 (VCC), UE7.16 (VCC), UE8.5 (VCC), UE8.13 (R), UE9.14 (VCC), UE10.14 (VCC), UE11.1 (~R), UE11.4 (~S), UE11.10 (~S), UE11.14 (VCC), UE13.1 (VPP), UE13.26 (A13), UE13.27 (~PGM), UE13.28 (VCC), UE15.11 (V_{CC}), UE15.17 (~NMI), UE15.24 (~WAIT), UE15.25 (~BUSREQ), UF1.14 (VCC), UF2.14 (VCC), UF4.1 (VPP), UF4.28 (VCC), UF4.30 (A13), UF4.31 (~PGM), UF7.1 (VPP), UF7.27 (~PGM), UF7.28 (VCC), UF9.1, UF9.13, UF9.14 (VCC), UF10.14 (VCC), UF11.14 (VCC), UF12.18 (VCC), UG1.20 (V_{CC}), UH1.16 (VCC), UH4.40 (VCC), UH6.40 (VCC), UH8.16 (VCC), UH9.20 (VCC), UH10.20 (VCC), UH11.18 (D7), UH11.20 (VCC), UH12.16 (VCC), UH13.16 (VCC), UJ7.1 (NC), UJ7.8 (VCC), X12.1 (A)
+5VDD: J14.1, J14.2, L1.1, L2.1
+12C: C47.2, C48.2, C49.1, C50.1, C51.1, C52.1, C53.2, J1.50 (+12C), J2.50 (+12C), J3.50 (+12C), J4.50 (+12C), J5.50 (+12C), J6.50 (+12C), J7.50 (+12C), J13.4, L3.2, R1.2, R2.2
+12V: C1.1, C2.2, J14.5, L3.1
-5V: C5.2, C6.2, C37.1, C38.1, C39.1, C40.1, C41.1, C42.1, C43.1, J1.34 (-5C), J2.34 (-5C), J3.34 (-5C), J4.34 (-5C), J5.34 (-5C), J6.34 (-5C), J7.34 (-5C), J13.3, J14.4, Q2.1 (C), Q7.1 (C), R17.1
-12V: C8.2, C9.2, C29.1, C30.1, C31.1, C32.1, C33.1, C34.1, C35.1, J1.33 (-12C), J2.33 (-12C), J3.33 (-12C), J4.33 (-12C), J5.33 (-12C), J6.33 (-12C), J7.33 (-12C), J14.7
/3,58M: J0.1, J7.35 (~ENKBD), UF10.9, UG1.3 (I_{2}), UH1.10 (Q), X19.3 (B)
/7M: J0.59, J1.36 (7M), J2.36 (7M), J3.36 (7M), J4.36 (7M), J5.36 (7M), J6.36 (7M), J7.36 (7M), R108.2, UF9.4, UG1.2 (I_{1}), UH1.6 (Q), UH1.14 (J)
/14M: D31.2 (A), J0.32, UF1.11, UG1.1 (CLK), UH1.4 (C), UH1.12 (C), UH8.7 (Clk), X25.1 (A)
/A0: D22.2 (A), J1.2 (A0), J2.2 (A0), J3.2 (A0), J4.2 (A0), J5.2 (A0), J6.2 (A0), J7.2 (A0), UE1.18 (1Y1), UE7.11 (S0), UF4.10 (A0), UH4.18 (A0)
/A1: D21.2 (A), J1.3 (A1), J2.3 (A1), J3.3 (A1), J4.3 (A1), J5.3 (A1), J6.3 (A1), J7.3 (A1), UE1.16 (1Y2), UE7.10 (S1), UF4.9 (A1), UH4.17 (A1)
/A2: D20.2 (A), J1.4 (A2), J2.4 (A2), J3.4 (A2), J4.4 (A2), J5.4 (A2), J6.4 (A2), J7.4 (A2), UE1.14 (1Y3), UE7.9 (S2), UF4.8 (A2), UH4.16 (A2)
/A3: D19.2 (A), J1.5 (A3), J2.5 (A3), J3.5 (A3), J4.5 (A3), J5.5 (A3), J6.5 (A3), J7.5 (A3), UE1.12 (1Y4), UF4.7 (A3), UH4.21 (A3)
/A4: J1.6 (A4), J2.6 (A4), J3.6 (A4), J4.6 (A4), J5.6 (A4), J6.6 (A4), J7.6 (A4), UE1.3 (2Y4), UE5.1 (A0), UE6.1 (A0), UF4.6 (A4), UH4.22 (A4)
/A5: J1.7 (A5), J2.7 (A5), J3.7 (A5), J4.7 (A5), J5.7 (A5), J6.7 (A5), J7.7 (A5), UE1.5 (2Y3), UE5.2 (A1), UE6.2 (A1), UF4.5 (A5), UH4.23 (A5)
/A6: J1.8 (A6), J2.8 (A6), J3.8 (A6), J4.8 (A6), J5.8 (A6), J6.8 (A6), J7.8 (A6), UE1.7 (2Y2), UE5.3 (A2), UE6.3 (A2), UF4.4 (A6), UH4.24 (A6), UH6.19 (A6)
/A7: J1.9 (A7), J2.9 (A7), J3.9 (A7), J4.9 (A7), J5.9 (A7), J6.9 (A7), J7.9 (A7), UE1.9 (2Y1), UE5.6 (E3), UE6.4 (E1), UF4.3 (A7), UH4.25 (A7)
/A8: J1.10 (A8), J2.10 (A8), J3.10 (A8), J4.10 (A8), J5.10 (A8), J6.10 (A8), J7.10 (A8), UE2.18 (1Y1), UE4.1 (A0), UF4.25 (A8), UH4.26 (A8)
/A9: J1.11 (A9), J2.11 (A9), J3.11 (A9), J4.11 (A9), J5.11 (A9), J6.11 (A9), J7.11 (A9), UE2.16 (1Y2), UE4.2 (A1), UF4.24 (A9), UH4.27 (A9)
/A10: J1.12 (A10), J2.12 (A10), J3.12 (A10), J4.12 (A10), J5.12 (A10), J6.12 (A10), J7.12 (A10), UE2.14 (1Y3), UE4.3 (A2), UF4.21 (A10), UH4.28 (A10)
/A11: J1.13 (A11), J2.13 (A11), J3.13 (A11), J4.13 (A11), J5.13 (A11), J6.13 (A11), J7.13 (A11), UE2.12 (1Y4), UE4.4 (E1), UF4.23 (A11), UF10.1, UH4.29 (A11)
/A12: J1.14 (A12), J2.14 (A12), J3.14 (A12), J4.14 (A12), J5.14 (A12), J6.14 (A12), J7.14 (A12), UE2.3 (2Y4), UF4.2 (A12), UH4.31 (A12)
/A13: J1.15 (A13), J2.15 (A13), J3.15 (A13), J4.15 (A13), J5.15 (A13), J6.15 (A13), J7.15 (A13), UE2.5 (2Y3), UE10.5, UF4.26 (A13), UF9.12, UH4.32 (A13)
/A14: J1.16 (A14), J2.16 (A14), J3.16 (A14), J4.16 (A14), J5.16 (A14), J6.16 (A14), J7.16 (A14), UE2.7 (2Y2), UH4.33 (A14)
/A15: J1.17 (A15), J2.17 (A15), J3.17 (A15), J4.17 (A15), J5.17 (A15), J6.17 (A15), J7.17 (A15), UC13.3 (C), UE2.9 (2Y1), UH4.34 (A15)
/ACENTO: J17.32, R37.2
/AKD: UH6.35 (AKD), UH12.5 (Q1)
/AN0: J15.15, UH6.29 (AN0)
/AN1: J15.14, J17.1, R93.1, UH6.28 (AN1), UH13.10 (I4)
/AN2: J15.13, UH6.27 (AN2), X3.2 (B)
/AN3: J0.50, J15.12, UH6.26 (AN3)
/CAPL: J8.1, J15.3, J17.9, R109.1, UE7.2 (I2), X23.2 (B)
/CXXX: J2.35 (~ENKBD), J3.35 (~ENKBD), J4.35 (~ENKBD), J5.35 (~ENKBD), J6.35 (~ENKBD), UE4.6 (E3), UF10.2, UH4.1 (CXXX)
/D0: J1.49 (D0), J2.49 (D0), J3.49 (D0), J4.49 (D0), J5.49 (D0), J6.49 (D0), J7.49 (D0), UH10.2 (A0)
/D1: J1.48 (D1), J2.48 (D1), J3.48 (D1), J4.48 (D1), J5.48 (D1), J6.48 (D1), J7.48 (D1), UH10.3 (A1)
/D2: J1.47 (D2), J2.47 (D2), J3.47 (D2), J4.47 (D2), J5.47 (D2), J6.47 (D2), J7.47 (D2), UH10.4 (A2)
/D3: J1.46 (D3), J2.46 (D3), J3.46 (D3), J4.46 (D3), J5.46 (D3), J6.46 (D3), J7.46 (D3), UH10.5 (A3)
/D4: J1.45 (D4), J2.45 (D4), J3.45 (D4), J4.45 (D4), J5.45 (D4), J6.45 (D4), J7.45 (D4), UH10.6 (A4)
/D5: J1.44 (D5), J2.44 (D5), J3.44 (D5), J4.44 (D5), J5.44 (D5), J6.44 (D5), J7.44 (D5), UH10.7 (A5)
/D6: J1.43 (D6), J2.43 (D6), J3.43 (D6), J4.43 (D6), J5.43 (D6), J6.43 (D6), J7.43 (D6), UH10.8 (A6)
/D7: J1.42 (D7), J2.42 (D7), J3.42 (D7), J4.42 (D7), J5.42 (D7), J6.42 (D7), J7.42 (D7), UE7.5 (Y), UH10.9 (A7)
/DMA_J3_OUT_J4_IN: J3.24 (DMA_OUT), J4.27 (IN)
/DMA_J6_OUT_J7_IN: J6.24 (DMA_OUT), J7.27 (IN)
/GR: J0.58, UE10.10, UF7.2 (A12), UF10.4, UF11.13, UH6.38 (GR), X7.1 (A)
/H0: J0.47, UG1.4 (I_{3}), UH6.6 (~H0)
/INT_J3_OUT_J4_IN: J3.23 (INT_OUT), J4.28 (IN)
/INT_J6_OUT_J7_IN: J6.23 (INT_OUT), J7.28 (IN)
/J1_28: J1.28 (IN), R117.1
/J7_23: J7.23 (INT_OUT), X7.2 (B)
/J7_24: J7.24 (DMA_OUT), X25.2 (B)
/J17_13: J17.13, R92.1, UH13.6 (I3)
/J17_15: J17.15, R90.1, UH13.2 (I1)
/J(1-7)21: J1.21 (RDY), J2.21 (RDY), J3.21 (RDY), J4.21 (RDY), J5.21 (RDY), J6.21 (RDY), J7.21 (RDY), R104.2, UC1.2 (RDY)
/J(1-7)29: J1.29 (~NMI), J2.29 (~NMI), J3.29 (~NMI), J4.29 (~NMI), J5.29 (~NMI), J6.29 (~NMI), J7.29 (~NMI), R106.2, UC1.6 (~NMI)
/J(1-7)30: J1.30 (~IRQ), J2.30 (~IRQ), J3.30 (~IRQ), J4.30 (~IRQ), J5.30 (~IRQ), J6.30 (~IRQ), J7.30 (~IRQ), R105.2, UC1.4 (~IRQ)
/J(1-7)39: J1.39 (UPSYNC), J2.39 (UPSYNC), J3.39 (UPSYNC), J4.39 (UPSYNC), J5.39 (UPSYNC), J6.39 (UPSYNC), J7.39 (UPSYNC), UC1.7 (SYNC)
/KSTRB: UH6.32 (KSTRB), UH12.4 (Q0)
/MD0: J0.44, UC1.33 (D0), UF4.11 (D0), UH9.3 (D0), UH10.18 (B0), UH11.2 (O0), UJ7.2 (DI), UJ7.14 (DO)
/MD1: J0.43, UC1.32 (D1), UF4.12 (D1), UH9.4 (D1), UH10.17 (B1), UH11.5 (O1), UJ7.17 (DI), UJ7.18 (DO)
/MD2: J0.40, UC1.31 (D2), UF4.13 (D2), UH9.7 (D2), UH10.16 (B2), UH11.6 (O2), UJ7.19 (DI), UJ7.20 (DO)
/MD3: J0.39, UC1.30 (D3), UF4.15 (D3), UH9.8 (D3), UH10.15 (B3), UH11.9 (O3), UJ7.21 (DI), UJ7.22 (DO)
/MD4: J0.21, UC1.29 (D4), UF4.16 (D4), UH9.13 (D4), UH10.14 (B4), UH11.12 (O4), UJ7.23 (DI), UJ7.24 (DO)
/MD5: J0.20, UC1.28 (D5), UF4.17 (D5), UH9.14 (D5), UH10.13 (B5), UH11.15 (O5), UJ7.25 (DI), UJ7.26 (DO)
/MD6: J0.17, UC1.27 (D6), UF4.18 (D6), UH9.17 (D6), UH10.12 (B6), UH11.16 (O6), UJ7.27 (DI), UJ7.28 (DO)
/MD7: J0.16, R80.2, UC1.26 (D7), UF4.19 (D7), UH4.19 (MD7), UH6.24 (MD7), UH9.18 (D7), UH10.11 (B7), UJ7.29 (DI), UJ7.30 (DO)
/MODE: J17.3, R40.2
/OAPL: J8.7, J15.2, J17.11, R110.1, UE7.3 (I1), X27.2 (B)
/PDL0: C10.2, J8.5, J15.6, R3.2
/PDL1: C13.2, J8.8, J15.10, R6.2
/PDL2: C12.2, J8.4, J15.7, R5.2
/PDL3: C11.2, J8.9, J15.11, R4.2
/PROG: J17.4, R39.2
/Q3: J0.53, J1.37 (Q3), J2.37 (Q3), J3.37 (Q3), J4.37 (Q3), J5.37 (Q3), J6.37 (Q3), J7.37 (Q3), R44.1, UG1.16 (~O_{5}), UH4.7 (Q3), UH6.17 (Q3)
/RA0: J0.51, R88.1, UH4.11 (RA0), UH6.7 (RA0), UJ7.9 (A7)
/RA1: J0.10, R84.1, UH4.15 (RA1), UH6.8 (RA1), UJ7.13 (A6)
/RA2: J0.49, R87.1, UH4.14 (RA2), UH6.9 (RA2), UJ7.10 (A5)
/RA3: J0.48, R86.1, UH4.13 (RA3), UH6.10 (RA3), UJ7.11 (A4)
/RA4: J0.13, R85.1, UH4.12 (RA4), UH6.12 (RA4), UJ7.12 (A3)
/RA5: J0.14, R82.1, UH4.10 (RA5), UH6.13 (RA5), UJ7.6 (A1)
/RA6: J0.46, R83.1, UH4.9 (RA6), UH6.14 (RA6), UJ7.7 (A2)
/RA7: J0.9, R81.1, UH4.8 (RA7), UH6.11 (RA7), UJ7.5 (A0)
/SEGA: J0.8, UF7.10 (A0), UH6.39 (SEGA)
/SEGB: J0.54, UF7.9 (A1), UG1.6 (I_{5}), UH6.31 (SEGB)
/SHIFT: J17.28, R91.1, UH13.4 (I2), X9.1 (A)
/STB: J15.5, UE6.11 (O4)
/SW2: J8.6, J15.4, UE7.1 (I3), X9.2 (B)
/VC: J0.5, UF7.8 (A2), UH6.1 (VC)
/VID0: J0.45, UF7.7 (A3), UH9.2 (O0)
/VID1: J0.42, UF7.6 (A4), UH9.5 (O1)
/VID2: J0.41, UF7.5 (A5), UH9.6 (O2)
/VID3: J0.38, UF7.4 (A6), UH9.9 (O3)
/VID4: J0.22, UF7.3 (A7), UH9.12 (O4)
/VID5: J0.19, UF7.25 (A8), UH9.15 (O5)
/VID6: J0.18, UH6.37 (VID6), UH9.16 (O6)
/VID7: J0.15, UF9.10, UH6.36 (VID7), UH9.19 (O7), X21.3 (B)
/VID7M: J0.2, UG1.13 (~O_{2}), UH8.6 (CE)
/X0: J17.18, R57.2, R65.1
/X1: J17.22, R59.2, R67.1
/X2: J17.20, R61.2, R69.1
/X3: J17.24, R62.2, R70.1
/X4: J16.9, J17.25, R60.2, R68.1
/X5: J16.11, J17.23, R58.2, R66.1
/X6: J16.10, J17.30, R56.2, R64.1
/X7: J16.8, J17.21, R55.2, R63.1
/Y0: D8.1 (K), J16.1, J17.5
/Y1: D9.1 (K), J16.2, J17.6
/Y2: D10.1 (K), J16.5, J17.8
/Y3: D7.1 (K), J16.3, J17.10
/Y4: D6.1 (K), J16.4, J17.12
/Y5: D5.1 (K), J16.6, J17.14
/Y6: D4.1 (K), J17.27
/Y7: D12.1 (K), J17.29
/Y8: D13.1 (K), J17.16
/Y9: D14.1 (K), J17.26
/Y10: D11.1 (K), J17.33
/Y11: D15.1 (K), J17.34
/ZA0: D8.2 (A), UE13.10 (A0), UE15.30 (A_{0}), UF12.5 (A0), UH11.3 (D0)
/ZA1: D9.2 (A), UE13.9 (A1), UE15.31 (A_{1}), UF12.6 (A1), UH11.4 (D1)
/ZA2: D10.2 (A), UE13.8 (A2), UE15.32 (A_{2}), UF12.7 (A2), UH11.7 (D2)
/ZA3: D7.2 (A), UE13.7 (A3), UE15.33 (A_{3}), UF12.4 (A3), UH11.8 (D3)
/ZA4: D6.2 (A), UE13.6 (A4), UE15.34 (A_{4}), UF12.3 (A4), UH11.13 (D4)
/ZA5: D5.2 (A), UE13.5 (A5), UE15.35 (A_{5}), UF12.2 (A5), UH11.14 (D5)
/ZA6: D4.2 (A), UE13.4 (A6), UE15.36 (A_{6}), UF12.1 (A6), UH11.17 (D6)
/ZA7: D12.2 (A), UE13.24 (A9), UE15.37 (A_{7}), UF12.17 (A7)
/ZA8: D13.2 (A), UE13.3 (A7), UE15.38 (A_{8}), UF12.16 (A8), UH12.13 (D)
/ZA9: D14.2 (A), UE13.25 (A8), UE15.39 (A_{9}), UF12.15 (A9), UH12.1 (A0)
/ZA10: D11.2 (A), UE13.23 (A11), UE15.40 (A_{10}), UH12.2 (A1)
/ZA11: D15.2 (A), UE13.21 (A10), UE15.1 (A_{11}), UH12.3 (A2)
/ZA12: UE13.2 (A12), UE15.2 (A_{12})
/ZA13: UE9.1, UE15.3 (A_{13}), UF9.2
/ZA15: UE15.5 (A_{15}), UH13.15 (E2)
/ZD0: R57.1, UE13.11 (D0), UE15.14 (D_{0}), UF12.11 (I/O4), UH13.3 (O1)
/ZD1: R59.1, UE13.12 (D1), UE15.15 (D_{1}), UF12.12 (I/O2), UH13.5 (O2)
/ZD2: R61.1, UE13.13 (D2), UE15.12 (D_{2}), UF12.13 (I/O2), UH13.7 (O3)
/ZD3: R62.1, UE13.15 (D3), UE15.8 (D_{3}), UF12.14 (I/O1), UH13.9 (O4)
/ZD4: R60.1, UE13.16 (D4), UE15.7 (D_{4}), UF12.19 (I/O4), UH13.11 (O5)
/ZD5: R58.1, UE13.17 (D5), UE15.9 (D_{5}), UF12.20 (I/O5), UH13.13 (O6)
/ZD6: R56.1, UE13.18 (D6), UE15.10 (D_{6}), UF12.21 (I/O6)
/ZD7: R55.1, UE13.19 (D7), UE15.13 (D_{7}), UF12.22 (I/O7)
/~80VID: J0.25, UG1.9 (I_{8}), UH6.30 (~80VID)
/~ALTVID: J0.27, R54.2, UF10.13
/~C0XX: UE4.15 (O0), UE5.5 (E2), UE6.5 (E2), UH6.15 (~C0XX)
/~C01X: D23.2 (A), UE6.14 (O1)
/~C06X: UE6.9 (O6), UE7.7 (~OE)
/~C07X: J0.6, UE6.7 (O7), UE8.3 (TRA), UE8.6 (TRB), UE8.11 (TRC), UE8.14 (TRD)
/~CAPLOCK: J17.31, R38.2
/~CASEN: J0.37, UG1.8 (I_{7}), UH4.30 (~CASEN)
/~CLKEN: J1.19 (~CLKEN), R96.2, UF1.13
/~CLRGAT: J0.24, UE11.3 (C), UF2.11, UH6.5 (~CLRGAT)
/~DEV1: J1.41 (~DEV), UE5.14 (O1)
/~DEV2: J2.41 (~DEV), UE5.13 (O2)
/~DEV3: J3.41 (~DEV), UE5.12 (O3)
/~DEV4: J4.41 (~DEV), UE5.11 (O4)
/~DEV5: J5.41 (~DEV), UE5.10 (O5)
/~DEV6: J6.41 (~DEV), UE5.9 (O6)
/~DEV7: J7.41 (~DEV), UE5.7 (O7)
/~DMA: J1.22 (~DMA), J2.22 (~DMA), J3.22 (~DMA), J4.22 (~DMA), J5.22 (~DMA), J6.22 (~DMA), J7.22 (~DMA), R103.2, UF2.2, UH4.36 (~DMA)
/~EN80: J0.26, UF1.10, UH4.4 (~EN80)
/~ENKBD: J1.35 (~ENKBD), R30.2, UE9.12
/~ENTMG: J0.60, R42.2, UG1.11 (~OE)
/~ENVID: J0.29, J19.1, R89.1, UF7.20 (~CE), X2.2 (B), X3.1 (A)
/~FRCTXT: J0.55, R118.1, UF11.12
/~H8_MR: R41.2, UH1.1 (~R), UH1.2 (J), UH1.5 (~S), UH1.11 (~S), UH1.15 (~R), UH8.9 (Clr)
/~INH: J1.32 (~INH), J2.32 (~INH), J3.32 (~INH), J4.32 (~INH), J5.32 (~INH), J6.32 (~INH), J7.32 (~INH), R102.2, UH4.39 (~INH)
/~IOSEL1: J1.1 (~IOSEL), UE4.14 (O1)
/~IOSEL2: J2.1 (~IOSEL), UE4.13 (O2)
/~IOSEL3: J3.1 (~IOSEL), UE4.12 (O3)
/~IOSEL4: J4.1 (~IOSEL), UE4.11 (O4)
/~IOSEL5: J5.1 (~IOSEL), UE4.10 (O5)
/~IOSEL6: J6.1 (~IOSEL), UE4.9 (O6)
/~IOSEL7: J7.1 (~IOSEL), UE4.7 (O7)
/~IOSTRB: J1.20 (~IOSTRB), J2.20 (~IOSTRB), J3.20 (~IOSTRB), J4.20 (~IOSTRB), J5.20 (~IOSTRB), J6.20 (~IOSTRB), J7.20 (~IOSTRB), UE10.11
/~KBD: UE9.13, UH4.35 (~KBD)
/~LDPS: J0.34, UG1.12 (~O_{1}), UH8.15 (PE)
/~PCAS: J0.33, R95.1, UG1.17 (~O_{6})
/~PRAS: J0.4, R79.1, UG1.19 (~O_{8}), UH4.6 (~PRAS), UH6.18 (~PRAS)
/~RA9: J0.56, UF7.24 (A9), UH6.34 (~RA9)
/~RA10: J0.57, UF7.21 (A10), UH6.33 (~RA10)
/~RESET: J1.31 (~RESET), J2.31 (~RESET), J3.31 (~RESET), J4.31 (~RESET), J5.31 (~RESET), J6.31 (~RESET), J7.31 (~RESET), J17.19, R33.2, UC1.40 (~RES), UC13.1 (~R), UC13.2 (D), UE15.26 (~RESET), UH6.25 (~RST)
/~ROMEN1: J0.11, UE10.6, X15.1 (A)
/~ROMEN2: J0.12, UE10.3, UF4.29 (~OE)
/~R/W80: J0.35, R107.1, UF1.8
/~R/W: J0.52, J1.18 (R/~W), J2.18 (R/~W), J3.18 (R/~W), J4.18 (R/~W), J5.18 (R/~W), J6.18 (R/~W), J7.18 (R/~W), UF1.2, UF1.6, UF1.9, UF2.9, UH4.38 (~R/W), UH6.23 (R/~W)
/~SEROUT: J0.28, UF10.12, UH8.1 (Ds), UH8.13 (Qh)
/~SYNC: J0.3, J7.19 (~CLKEN), R21.1, UH6.4 (~SYNC)
/~WNDW: J0.7, UF7.22 (~OE), UH6.3 (~WNDW), UH13.14 (I6)
/Φ0: J0.23, J1.40 (Φ0), J2.40 (Φ0), J3.40 (Φ0), J4.40 (Φ0), J5.40 (Φ0), J6.40 (Φ0), J7.40 (Φ0), R34.2, R94.1, UE6.6 (E3), UF2.8, UG1.15 (~O_{4}), UH4.5 (Φ0), UH6.16 (Φ0), UH9.1 (OE), UH9.11 (Cp)
/Φ1: J0.36, J1.38 (Φ1), J2.38 (Φ1), J3.38 (Φ1), J4.38 (Φ1), J5.38 (Φ1), J6.38 (Φ1), J7.38 (Φ1), R35.2, UE4.5 (E2), UE5.4 (E1), UE10.12, UF1.1, UF2.5, UF11.4, UG1.14 (~O_{3})
GND: C1.2, C2.1, C3.2, C4.1, C5.1, C6.1, C7.2, C8.1, C9.1, C10.1, C11.1, C12.1, C13.1, C21.2, C22.2, C23.2, C24.2, C25.2, C26.2, C27.2, C28.2, C29.2, C30.2, C31.2, C32.2, C33.2, C34.2, C35.2, C36.1, C37.2, C38.2, C39.2, C40.2, C41.2, C42.2, C43.2, C44.2, C45.2, C46.2, C47.1, C48.1, C49.2, C50.2, C51.2, C52.2, C53.1, C55.1, C56.2, C57.2, C58.2, C59.1, C60.1, C64.1, C65.2, C66.1, C67.1, C68.2, C69.2, C70.2, C71.1, C72.2, C73.2, C74.1, C76.2, C77.1, C78.2, C79.2, C80.2, C81.2, C82.2, C83.2, C84.2, C85.2, C86.2, C88.1, C89.1, C90.2, C91.2, C92.1, C93.2, C94.1, C95.1, C97.2, C98.2, C100.2, C102.2, C103.2, C104.2, C105.2, C106.2, C107.2, C108.2, C109.2, C110.2, C111.2, C113.2, C120.1, C208.1, D18.2 (A), H1.1, H2.1, H3.1, H4.1, H5.1, H6.1, H7.1, H8.1, H9.1, J0.31, J1.26 (GND), J2.26 (GND), J3.26 (GND), J4.26 (GND), J5.26 (GND), J6.26 (GND), J7.26 (GND), J8.3, J9.2, J10.2, J10.3, J11.2, J13.1, J14.3, J14.6, J15.8 (GND), J17.17, L4.2, Q5.3 (E), Q6.3 (E), R7.1, R20.1, R23.1, R30.1, R42.1, R63.2, R64.2, R65.2, R66.2, R67.2, R68.2, R69.2, R70.2, R71.1, R80.1, R81.2, R82.2, R83.2, R84.2, R85.2, R86.2, R87.2, R88.2, R89.2, R96.1, R109.2, R110.2, R112.2, R115.1, UC1.1, UC1.21, UC13.7 (GND), UE1.10, UE2.10, UE4.8 (GND), UE5.8 (GND), UE6.8 (GND), UE7.8 (GND), UE8.12 (GND), UE9.7 (GND), UE10.7 (GND), UE11.7 (GND), UE13.14 (GND), UE15.29 (GND), UF1.7 (GND), UF2.3, UF2.7 (GND), UF4.14 (GND), UF4.20 (~CE), UF7.14 (GND), UF9.7 (GND), UF10.7 (GND), UF11.7 (GND), UF12.9 (VSS), UG1.10 (GND), UH1.3 (~K), UH1.8 (GND), UH4.20 (GND), UH6.20 (GND), UH8.8 (GND), UH9.10 (GND), UH10.10 (GND), UH11.10 (GND), UH12.8 (GND), UH13.8 (GND), UJ7.16 (VSS), X1.1 (A), X5.1 (A), X11.1 (A)
unnamed: C14.2, R8.2
unnamed: C36.2, R108.1
unnamed: C44.1, R21.2, R22.1
unnamed: C45.1, L4.1, R24.2, R25.2
unnamed: C80.1, R34.1
unnamed: C81.1, R35.1
unnamed: C97.1, R44.2
unnamed: C99.1, Y1.1
unnamed: C101.2, R77.1
unnamed: C112.1, R120.1
unnamed: C87.2, D16.2 (A), R45.2, UH4.37 (??37)
unnamed: C111.1, D17.2 (A), R36.1, UF11.9, UH12.15 (Clr)
unnamed: D18.1 (K), Q5.2 (B), R77.2
unnamed: D19.1 (K), D20.1 (K), D21.1 (K), D22.1 (K), D23.1 (K), R112.1, UC13.12 (D)
unnamed: D26.2 (A), UE15.27 (~M1)
unnamed: D26.1 (K), D27.1 (K), R115.2, UC13.10 (~S)
unnamed: D27.2 (A), UE9.9, UE15.20 (~IORQ), UH13.1 (E1)
unnamed: D30.2 (A), UH12.11 (Q6)
unnamed: D30.1 (K), R94.2, UF11.10
unnamed: D31.1 (K), R119.1, UE11.13 (~R)
unnamed: J1.24 (DMA_OUT), J2.27 (IN)
unnamed: J1.23 (INT_OUT), J2.28 (IN)
unnamed: J2.24 (DMA_OUT), J3.27 (IN)
unnamed: J2.23 (INT_OUT), J3.28 (IN)
unnamed: J4.24 (DMA_OUT), J5.27 (IN)
unnamed: J4.23 (INT_OUT), J5.28 (IN)
unnamed: J5.24 (DMA_OUT), J6.27 (IN)
unnamed: J5.23 (INT_OUT), J6.28 (IN)
unnamed: J11.1, R11.2
unnamed: J12.1, J13.2, Q3.3 (E), R11.1, R17.2
unnamed: C100.1, J18.1, R74.2, R75.1, R76.1
unnamed: LED1.2 (A), R1.1
unnamed: LED2.1 (K), R74.1
unnamed: Q2.2 (B), R22.2, R23.2, R24.1, R31.2
unnamed: Q2.3 (E), R18.2, R19.1
unnamed: Q3.2 (B), R19.2
unnamed: C95.2, Q4.1 (B), R73.1, Y1.2
unnamed: C94.2, C99.2, Q4.3 (C), R72.2, R73.2, UF1.12
unnamed: Q4.2 (E), R71.2
unnamed: Q5.1 (C), R76.2, X24.1 (A)
unnamed: Q6.2 (B), Q7.3 (E), R28.1
unnamed: Q6.1 (C), R32.1, UE7.4 (I0)
unnamed: C120.2, Q7.2 (B), R20.2, R27.1, R120.2
unnamed: R25.1, UF2.13
unnamed: R31.1, UF10.11
unnamed: R119.2, UF10.8
unnamed: UC1.9 (A0), UE1.2 (1A1)
unnamed: UC1.10 (A1), UE1.4 (1A2)
unnamed: UC1.11 (A2), UE1.6 (1A3)
unnamed: UC1.12 (A3), UE1.8 (1A4)
unnamed: UC1.13 (A4), UE1.17 (2A4)
unnamed: UC1.14 (A5), UE1.15 (2A3)
unnamed: UC1.15 (A6), UE1.13 (2A2)
unnamed: UC1.16 (A7), UE1.11 (2A1)
unnamed: UC1.17 (A8), UE2.2 (1A1)
unnamed: UC1.18 (A9), UE2.4 (1A2)
unnamed: UC1.19 (A10), UE2.6 (1A3)
unnamed: UC1.20 (A11), UE2.8 (1A4)
unnamed: UC1.22 (A12), UE2.17 (2A4)
unnamed: UC1.23 (A13), UE2.15 (2A3)
unnamed: UC1.24 (A14), UE2.13 (2A2)
unnamed: UC1.25 (A15), UE2.11 (2A1)
unnamed: UC1.34 (R/~W), UF1.5
unnamed: UC1.37 (Φ0), UF2.4
unnamed: C87.1, UC13.6 (~Q)
unnamed: UC13.11 (C), UF11.6
unnamed: UC13.9 (Q), UE15.16 (~INT), UF11.5
unnamed: R98.1, UE7.15 (I4), UE8.1 (OA)
unnamed: R99.1, UE7.14 (I5), UE8.16 (OD)
unnamed: R100.1, UE7.13 (I6), UE8.9 (OC)
unnamed: R101.1, UE7.12 (I7), UE8.8 (OB)
unnamed: C60.2, UE8.4 (CV)
unnamed: R3.1, UE8.2 (TA)
unnamed: R4.1, UE8.7 (TB)
unnamed: R5.1, UE8.10 (TC)
unnamed: R6.1, UE8.15 (TD)
unnamed: UE9.5, UF9.3
unnamed: UE10.1, UF9.11
unnamed: UE10.8, UF11.2
unnamed: UE10.13, UF10.3
unnamed: UE11.2 (D), UE11.6 (~Q)
unnamed: UE11.5 (Q), UF9.5, UF9.9, UF10.5
unnamed: UE11.11 (C), UF9.6
unnamed: UE11.8 (~Q), UE11.12 (D), X19.1 (A)
unnamed: UE9.3, UE13.20 (~CE)
unnamed: UE13.22 (~OE), UE15.21 (~RD)
unnamed: R29.1, UE15.6 (CLK), UH1.9 (~Q)
unnamed: UE9.2, UE9.4, UE15.19 (~MREQ)
unnamed: UE9.10, UE15.22 (~WR), UF12.10 (~W)
unnamed: UF7.23 (A11), UF11.3
unnamed: R46.2, UF7.11 (D0), UH8.14 (H)
unnamed: R51.2, UF7.12 (D1), UH8.12 (G)
unnamed: R52.2, UF7.13 (D2), UH8.11 (F)
unnamed: R53.2, UF7.15 (D3), UH8.10 (E)
unnamed: R50.2, UF7.16 (D4), UH8.5 (D)
unnamed: R49.2, UF7.17 (D5), UH8.4 (C)
unnamed: R48.2, UF7.18 (D6), UH8.3 (B)
unnamed: R47.2, UF7.19 (D7), UH8.2 (A)
unnamed: UF10.6, UF11.1
unnamed: UE9.6, UF12.8 (~S)
unnamed: UG1.5 (I_{4}), X21.2 (C)
unnamed: UF11.11, UG1.7 (I_{6})
unnamed: UF10.10, UH1.7 (~Q), UH1.13 (~K)
unnamed: UE10.2, UE10.4, UH4.3 (~ROMEN2), X16.1 (A)
unnamed: UF11.8, UH6.2 (??)
unnamed: C14.1, UH6.22 (CASSO)
unnamed: C101.1, R78.2, UH6.21 (SPK)
unnamed: UH4.2 (??02), UH10.1 (AB)
unnamed: UF2.10, UH10.19 (CE)
unnamed: UE9.8, UH11.11 (Cp), UH12.14 (E)
unnamed: UE9.11, UH11.1 (OE)
unnamed: R37.1, UH12.6 (Q2)
unnamed: R40.1, R117.2, UE10.9, UH12.7 (Q3)
unnamed: R39.1, UH12.9 (Q4), X23.1 (A)
unnamed: R38.1, UH12.10 (Q5)
unnamed: UH12.12 (Q7), X27.1 (A)
unnamed: UH13.12 (I5), X1.2 (B), X2.1 (A)
unnamed: R95.2, UJ7.15 (~CAS)
unnamed: R79.2, UJ7.4 (~RAS)
unnamed: R97.1, UF1.3, UJ7.3 (~WE)
unnamed: UF2.6, X4.1 (A), X5.2 (B)
unnamed: UE1.1, UE1.19, UE2.1, UE2.19, UF1.4, UF2.1, X4.2 (B)
unnamed: J9.1, J9.3, R7.2, R8.1, X6.1 (A)
unnamed: J10.1, X6.3 (B)
unnamed: C112.2, X6.2 (C)
unnamed: TP1.1, UF4.27 (~PGM), X11.2 (B), X12.2 (B)
unnamed: UF4.22 (~OE), X15.2 (B), X16.2 (B)
unnamed: UF2.12, X19.2 (C)
unnamed: UF9.8, X21.1 (A)
unnamed: R75.2, X24.2 (B)

Notes on the sheet:
8x 22k
~{C04X}

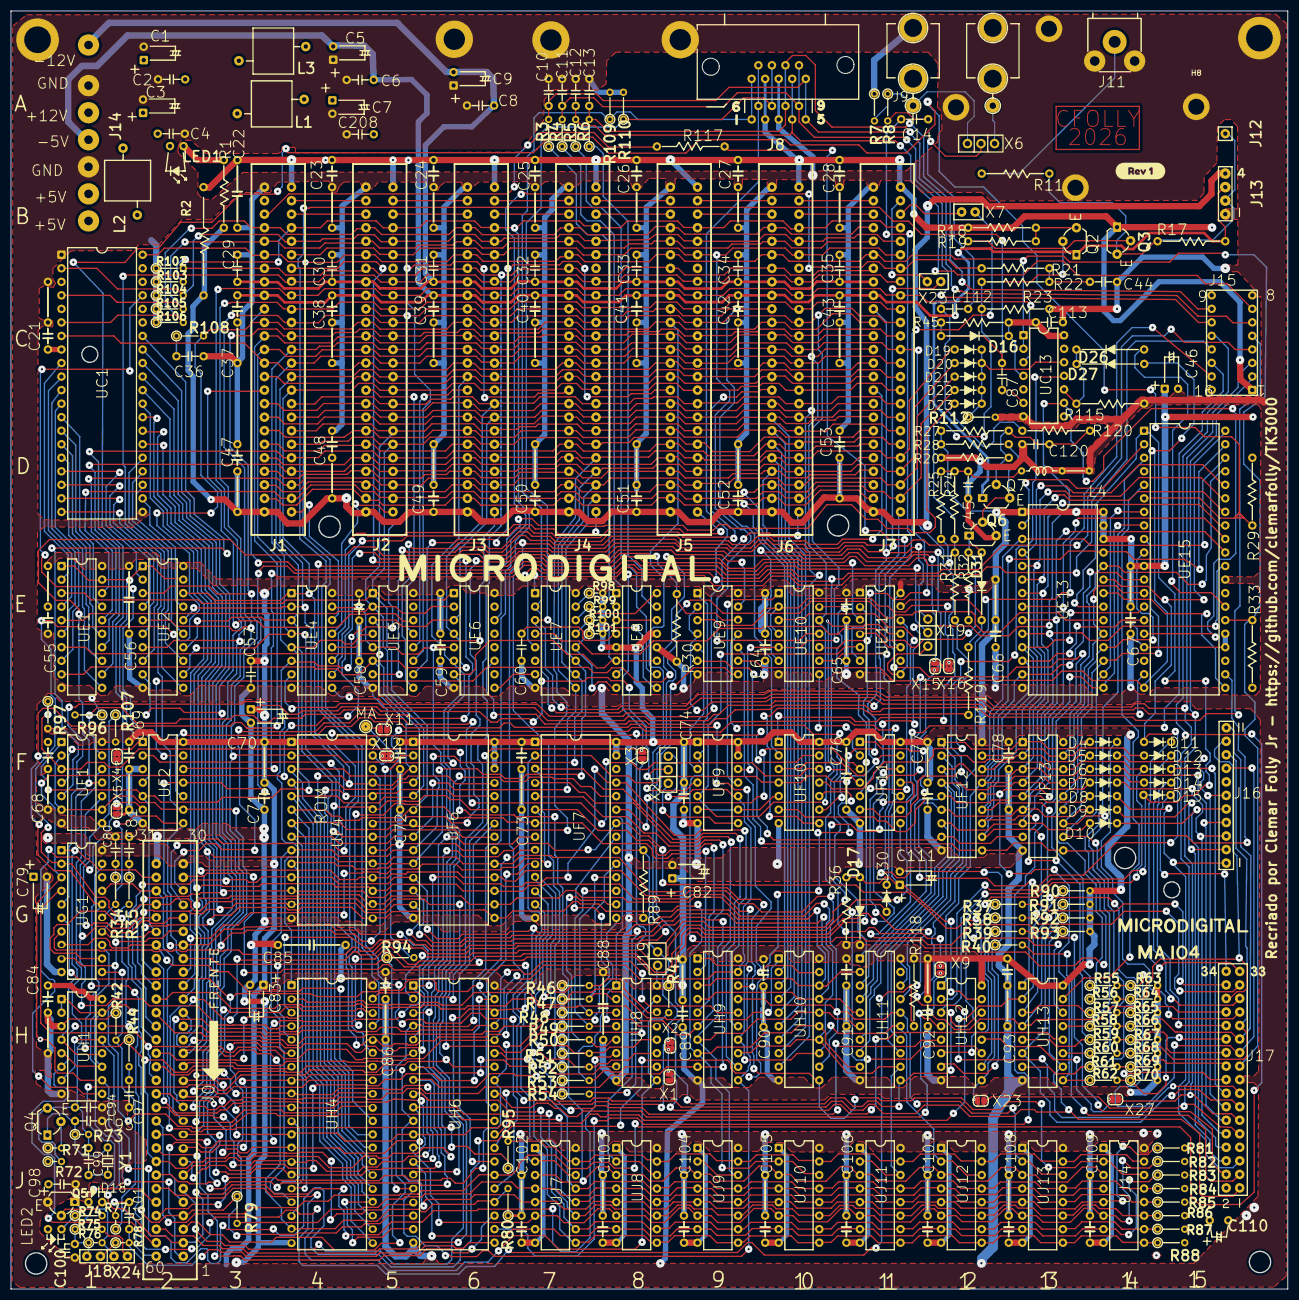
[picture p47: board TK3000.kicad_pcb from above]

Board: 2 copper layers, 239.6 x 239.9 mm, 329 parts (0 on the bottom side), 320 nets.

Other parts of the board:
kibuzzard-6AD58770: G***; kibuzzard-6AD58770
