clemarfolly/TK3000/teste_export_sprintlayout.kicad_pcb

## KiCad design teste_export_sprintlayout.kicad_pcb (2026-08-29)

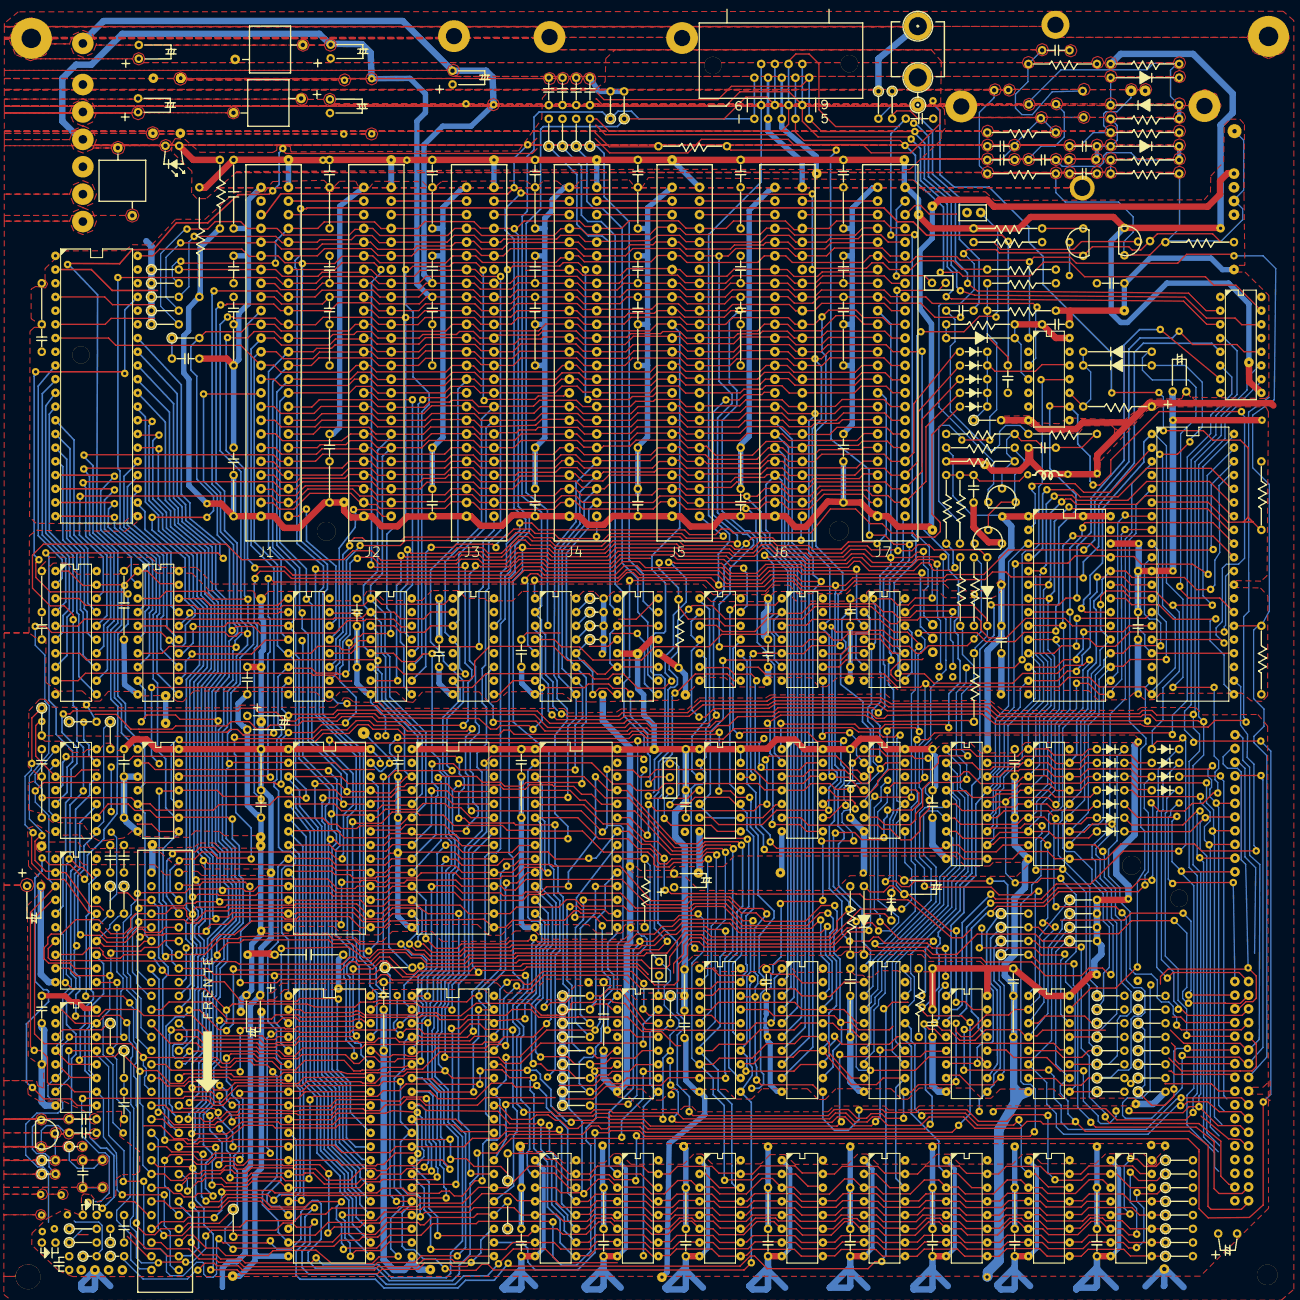
[picture p48: board teste_export_sprintlayout.kicad_pcb from above]

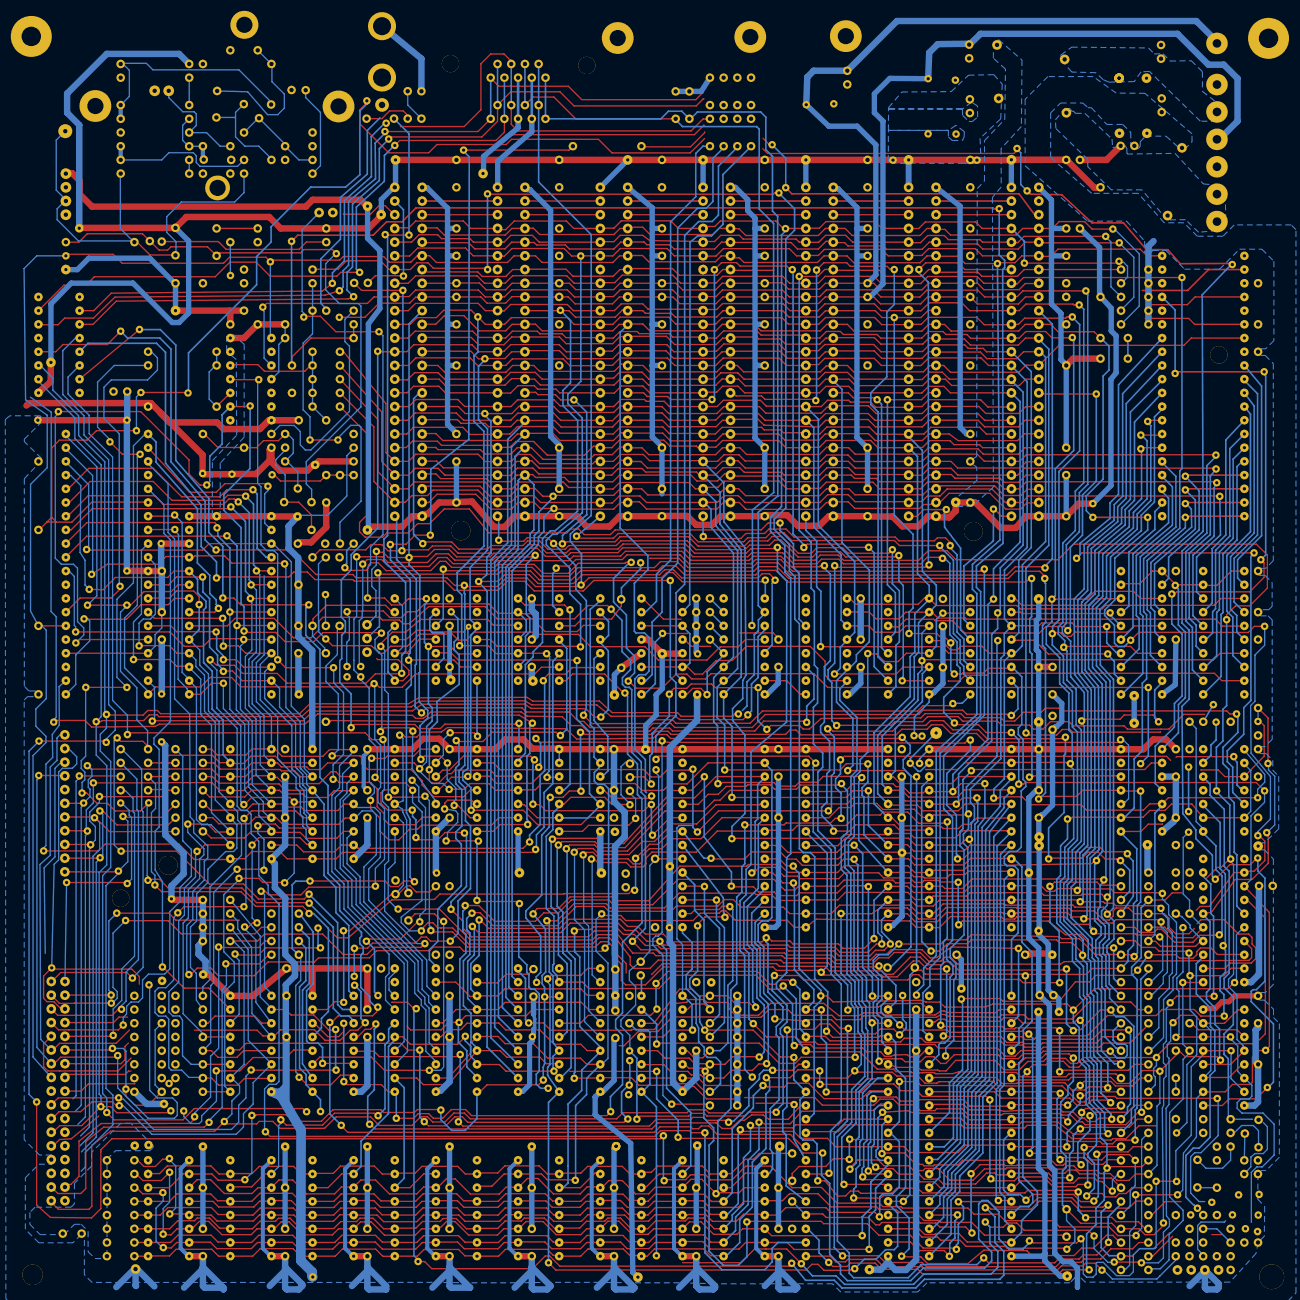
[picture p49: board teste_export_sprintlayout.kicad_pcb from below]

Board: 4 copper layers, 1275 parts (962 on the bottom side), 297 nets.

Parts:
C: FP_11779_4812_909
C110: 16uF/25V; FP_22677_22885_1261
C#2: FP_11779_5955_910
C#3: FP_11779_3415_911
C#4: FP_11779_8749_912
C#5: FP_13684_4812_913
C#6: FP_13684_5955_914
C#7: FP_13684_3415_915
C#8: FP_13684_8749_916
C#9: FP_730_5701_1057
C#10: FP_4540_12432_1058
C#11: FP_4286_4812_1059
C#12: FP_3397_6463_1060
C#13: FP_6064_4812_1061
C#14: FP_6064_5955_1062
C#15: FP_6064_8495_1063
C#16: FP_6064_3415_1064
C#17: FP_7969_3415_1065
C#18: FP_7969_4812_1066
C#19: FP_7969_5955_1067
C#20: FP_9874_4812_1068
C#21: FP_9874_5955_1069
C#22: FP_9874_3415_1070
C#23: FP_4286_8749_1071
C#24: FP_4286_5955_1072
C#25: FP_7969_8749_1073
C#26: FP_9874_8749_1074
C#27: FP_4286_3415_1075
C#28: FP_2254_11035_1078
C#29: FP_730_11035_1079
C#30: FP_730_14337_1080
C#31: FP_2254_14337_1081
C#32: FP_4794_14337_1082
C#33: FP_15589_4812_1083
C#34: FP_15589_5955_1084
C#35: FP_15589_3415_1085
C#36: FP_15589_8495_1086
C#37: FP_10128_1510_1087
C#38: FP_10382_1510_1088
C#39: FP_10636_1510_1089
C#40: FP_10890_1510_1090
C#41: FP_7334_14337_1097
C#42: FP_9620_14337_1098
C#43: FP_11144_18655_1108
C#44: FP_7067_18655_1111
C#45: FP_9620_22465_1112
C#46: FP_6572_11549_1117
C#47: FP_8096_11543_1118
C#48: FP_9620_11924_1119
C#49: FP_12668_14337_1120
C#50: FP_14192_11543_1121
C#51: FP_15716_11543_1122
C#52: FP_4906_13127_1129
C#53: FP_532_16425_1130
C#54: FP_730_18909_1131
C#55: FP_4758_18543_1132
C#56: FP_5683_17512_1133
C#57: FP_1493_21576_1137
C#58: FP_1493_20814_1138
C#59: FP_1493_20560_1139
C#60: FP_2254_20306_1140
C#61: FP_2255_22592_1141
C#62: FP_1123_23227_1147
C#63: FP_14160_18032_1156
C#64: FP_12642_18420_1158
C#65: FP_15716_14337_1159
C#66: FP_17000_2015_1163
C#67: FP_18516_11289_1167
C#68: FP_18002_8876_1170
C#69: FP_19272_8114_1176
C#70: FP_20542_5066_1177
C#71: FP_19272_2780_1192
C#72: FP_20034_2526_1193
C#73: FP_20034_3034_1194
C#74: FP_19526_748_1195
C#75: FP_18510_2780_1196
C#76: FP_18510_2526_1197
C#77: FP_17748_5574_1200
C#78: FP_18637_6844_1201
C#79: FP_12668_22465_1203
C#80: FP_11144_22465_1204
C#81: FP_14192_22465_1205
C#82: FP_17240_18401_1207
C#83: FP_15716_22465_1208
C#84: FP_17240_22465_1209
C#85: FP_18764_22465_1210
C#86: FP_20288_22465_1211
C#87: FP_18764_14337_1216
C#88: FP_17240_14337_1217
C#89: FP_21050_11035_1225
C#90: FP_19526_5828_1242
C#91: FP_2000_15734_1243
C#92: FP_2254_15734_1244
C#93: FP_15716_18400_1254
C#94: FP_18738_18401_1256
C#95: FP_21765_6883_1257
C#96: FP_16908_16315_1258
C#97: FP_12641_16188_1260
C#98: FP_2718_829_1267
C#99: FP_2706_1820_1268
C#100: FP_6274_823_1269
C#101: FP_8534_1306_1270
C#102: FP_6262_1730_1274
CMP1: Pad_1456_6394_1
CMP2: Pad_1508_8509_2
CMP3: Pad_1512_8252_3
CMP4: Pad_1496_8764_4
CMP5: Pad_1440_9016_5
CMP6: Pad_2078_8643_6
CMP7: Pad_2078_8897_7
CMP8: Pad_2078_9151_8
CMP9: Pad_2078_9405_9
CMP10: Pad_2776_9405_10
CMP11: Pad_2903_8134_11
CMP12: Pad_2903_7881_12
CMP13: Pad_2776_7627_13
CMP14: Pad_3729_7119_14
CMP15: Pad_3792_9151_15
CMP16: Pad_3792_9405_16
CMP17: Pad_4173_6072_17
CMP18: Pad_4173_5691_18
CMP19: Pad_4046_5468_19
CMP20: Pad_3922_5208_20
CMP21: Pad_617_6706_21
CMP22: Pad_2268_6738_22
CMP23: Pad_2141_4960_23
CMP24: Pad_1208_4719_24
CMP25: Pad_805_10064_25
CMP26: Pad_678_10191_26
CMP27: Pad_2329_10826_27
CMP28: Pad_2265_10667_28
CMP29: Pad_1313_11302_29
CMP30: Pad_3091_11683_30
CMP31: Pad_3535_11429_31
CMP32: Pad_3515_11937_32
CMP33: Pad_3472_11175_33
CMP34: Pad_2765_12559_34
CMP35: Pad_2575_13194_35
CMP36: Pad_3026_13219_36
CMP37: Pad_3026_12712_37
CMP38: Pad_1559_12877_38
CMP39: Pad_1508_13201_39
CMP40: Pad_732_13188_40
CMP41: Pad_1129_13049_41
CMP42: Pad_2018_14033_42
CMP43: Pad_2018_14859_43
CMP44: Pad_2018_15240_44
CMP45: Pad_2907_13969_45
CMP46: Pad_2907_14478_46
CMP47: Pad_4000_13178_47
CMP48: Pad_4301_13481_48
CMP49: Pad_4208_13969_49
CMP50: Pad_4263_14997_50
CMP51: Pad_4612_15736_51
CMP52: Pad_4588_16244_52
CMP53: Pad_4079_16319_53
CMP54: Pad_4027_16530_54
CMP55: Pad_3725_15766_55
CMP56: Pad_3960_16846_56
CMP57: Pad_3589_16125_57
CMP58: Pad_3525_16443_58
CMP59: Pad_3525_16760_59
CMP60: Pad_3779_17078_60
CMP61: Pad_3983_17522_61
CMP62: Pad_4281_17776_62
CMP63: Pad_4408_18030_63
CMP64: Pad_3307_4659_64
CMP65: Pad_3303_4317_65
CMP66: Pad_3554_4197_66
CMP67: Pad_3422_4061_67
CMP68: Pad_4257_11504_68
CMP69: Pad_4544_11561_69
CMP70: Pad_4333_11813_70
CMP71: Pad_4094_10164_71
CMP72: Pad_4678_10343_72
CMP73: Pad_4684_10539_73
CMP74: Pad_4928_10539_74
CMP75: Pad_4552_10922_75
CMP76: Pad_4796_10917_76
CMP77: Pad_5062_4693_77
CMP78: Pad_5561_4701_78
CMP79: Pad_5635_9252_79
CMP80: Pad_5804_10363_80
CMP81: Pad_6509_9261_81
CMP82: Pad_6437_9930_82
CMP83: Pad_6630_9928_83
CMP84: Pad_6579_10166_84
CMP85: Pad_6828_10287_85
CMP86: Pad_7509_10005_86
CMP87: Pad_7389_10113_87
CMP88: Pad_7200_11559_88
CMP89: Pad_5011_3354_89
CMP90: Pad_5528_3684_90
CMP91: Pad_5198_2568_91
CMP92: Pad_5303_2777_92
CMP93: Pad_5941_2784_93
CMP94: Pad_7206_2780_94
CMP95: Pad_7497_2784_95
CMP96: Pad_9112_2780_96
CMP97: Pad_7017_4812_97
CMP98: Pad_7473_4812_98
CMP99: Pad_7473_5701_99
CMP100: Pad_7601_7225_100
CMP101: Pad_7791_7225_101
CMP102: Pad_7948_9961_102
CMP103: Pad_8578_10300_103
CMP104: Pad_8768_10300_104
CMP105: Pad_9149_9964_105
CMP106: Pad_9590_9510_106
CMP107: Pad_9639_9962_107
CMP108: Pad_9682_10571_108
CMP109: Pad_9864_10569_109
CMP110: Pad_8928_7240_110
CMP111: Pad_11013_9761_111
CMP112: Pad_11625_10576_112
CMP113: Pad_12174_10247_113
CMP114: Pad_12349_10239_114
CMP115: Pad_12534_10925_115
CMP116: Pad_12721_11107_116
CMP117: Pad_13362_9753_117
CMP118: Pad_13625_9895_118
CMP119: Pad_13788_9890_119
CMP120: Pad_13740_10346_120
CMP121: Pad_14805_9829_121
CMP122: Pad_14128_10109_122
CMP123: Pad_15177_10594_123
CMP124: Pad_15443_10666_124
CMP125: Pad_15833_10366_125
CMP126: Pad_16146_10913_126
CMP127: Pad_16108_11798_127
CMP128: Pad_15530_11784_128
CMP129: Pad_15686_11157_129
CMP130: Pad_15509_9652_130
CMP131: Pad_16072_9735_131
CMP132: Pad_16213_9892_132
CMP133: Pad_16467_10150_133
CMP134: Pad_16599_10024_134
CMP135: Pad_13781_9241_135
CMP136: Pad_13797_9014_136
CMP137: Pad_15062_7481_137
CMP138: Pad_15062_6466_138
CMP139: Pad_15191_5689_139
CMP140: Pad_15011_4812_140
CMP141: Pad_15013_3410_141
CMP142: Pad_15456_2598_142
CMP143: Pad_13411_7228_143
CMP144: Pad_13284_4561_144
CMP145: Pad_9612_3392_145
CMP146: Pad_9489_4054_146
CMP147: Pad_9363_4814_147
CMP148: Pad_9235_4940_148
CMP149: Pad_8914_4821_149
CMP150: Pad_10807_4815_150
CMP151: Pad_10852_7220_151
CMP152: Pad_6426_11731_152
CMP153: Pad_6362_12308_153
CMP154: Pad_5634_10920_154
CMP155: Pad_5557_11176_155
CMP156: Pad_5555_11689_156
CMP157: Pad_6387_12857_157
CMP158: Pad_6359_13216_158
CMP159: Pad_6063_13533_159
CMP160: Pad_5031_13401_160
CMP161: Pad_5303_13394_161
CMP162: Pad_5303_13077_162
CMP163: Pad_6045_14101_163
CMP164: Pad_5794_14341_164
CMP165: Pad_6387_14488_165
CMP166: Pad_6324_14721_166
CMP167: Pad_5941_14606_167
CMP168: Pad_5631_14610_168
CMP169: Pad_6491_15049_169
CMP170: Pad_6098_14902_170
CMP171: Pad_6080_15372_171
CMP172: Pad_6300_15735_172
CMP173: Pad_6288_16169_173
CMP174: Pad_6280_16957_174
CMP175: Pad_6791_17443_175
CMP176: Pad_6502_17775_176
CMP177: Pad_7756_17720_177
CMP178: Pad_7388_17313_178
CMP179: Pad_7545_17313_179
CMP180: Pad_7705_17313_180
CMP181: Pad_7848_17214_181
CMP182: Pad_6523_19388_182
CMP183: Pad_6564_19017_183
CMP184: Pad_6612_18819_184
CMP185: Pad_6230_18334_185
CMP186: Pad_6230_18139_186
CMP187: Pad_4544_17512_187
CMP188: Pad_5043_17903_188
CMP189: Pad_5170_17395_189
CMP190: Pad_4798_17068_190
CMP191: Pad_4420_18571_191
CMP192: Pad_4801_18571_192
CMP193: Pad_4408_18919_193
CMP194: Pad_4154_18919_194
CMP195: Pad_4154_18538_195
CMP196: Pad_4027_18729_196
CMP197: Pad_4154_19427_197
CMP198: Pad_4408_19681_198
CMP199: Pad_5011_19681_199
CMP200: Pad_4980_18983_200
CMP201: Pad_4027_19935_201
CMP202: Pad_4027_20126_202
CMP203: Pad_4260_20300_203
CMP204: Pad_4397_20080_204
CMP205: Pad_4000_20436_205
CMP206: Pad_3847_20495_206
CMP207: Pad_4024_20739_207
CMP208: Pad_4258_20610_208
CMP209: Pad_4275_21073_209
CMP210: Pad_4401_21310_210
CMP211: Pad_4220_21645_211
CMP212: Pad_4010_21404_212
CMP213: Pad_3954_21084_213
CMP214: Pad_3721_21209_214
CMP215: Pad_3529_21467_215
CMP216: Pad_3509_20829_216
CMP217: Pad_3443_20561_217
CMP218: Pad_3463_20254_218
CMP219: Pad_3515_19979_219
CMP220: Pad_4965_21192_220
CMP221: Pad_3885_21780_221
CMP222: Pad_4063_21909_222
CMP223: Pad_3927_22387_223
CMP224: Pad_3906_21983_224
CMP225: Pad_3774_22077_225
CMP226: Pad_3770_22725_226
CMP227: Pad_3509_22153_227
CMP228: Pad_3432_21892_228
CMP229: Pad_3000_21962_229
CMP230: Pad_2990_22718_230
CMP231: Pad_3007_21324_231
CMP232: Pad_3010_20948_232
CMP233: Pad_2889_20432_233
CMP234: Pad_2620_21711_234
CMP235: Pad_2484_22484_235
CMP236: Pad_2223_21962_236
CMP237: Pad_2240_21714_237
CMP238: Pad_2240_20815_238
CMP239: Pad_3458_18536_239
CMP240: Pad_3469_19300_240
CMP241: Pad_3129_18906_241
CMP242: Pad_5702_20201_242
CMP243: Pad_5683_21665_243
CMP244: Pad_6050_21570_244
CMP245: Pad_6285_22091_245
CMP246: Pad_6301_22334_246
CMP247: Pad_6033_22670_247
CMP248: Pad_5786_22466_248
CMP249: Pad_5786_22202_249
CMP250: Pad_5544_22068_250
CMP251: Pad_5032_22062_251
CMP252: Pad_4968_22815_252
CMP253: Pad_4274_22971_253
CMP254: Pad_4013_22777_254
CMP255: Pad_2892_23223_255
CMP256: Pad_3502_22843_256
CMP257: Pad_3397_23209_257
CMP258: Pad_3624_23359_258
CMP259: Pad_3861_23352_259
CMP260: Pad_4268_23469_260
CMP261: Pad_4797_13194_261
CMP262: Pad_4968_14219_262
CMP263: Pad_5166_14350_263
CMP264: Pad_4797_12179_264
CMP265: Pad_3279_13527_265
CMP266: Pad_1181_13840_266
CMP267: Pad_1499_14475_267
CMP268: Pad_737_14602_268
CMP269: Pad_610_14475_269
CMP270: Pad_546_13966_270
CMP271: Pad_569_15249_271
CMP272: Pad_734_15305_272
CMP273: Pad_736_15719_273
CMP274: Pad_3279_15766_274
CMP275: Pad_3153_15640_275
CMP276: Pad_3407_17386_276
CMP277: Pad_3026_17545_277
CMP278: Pad_2963_17799_278
CMP279: Pad_2550_19672_279
CMP280: Pad_2613_19418_280
CMP281: Pad_2252_19043_281
CMP282: Pad_2306_18772_282
CMP283: Pad_2359_18402_283
CMP284: Pad_2125_18027_284
CMP285: Pad_1991_17900_285
CMP286: Pad_2010_17481_286
CMP287: Pad_2122_17011_287
CMP288: Pad_2503_16376_288
CMP289: Pad_2531_16651_289
CMP290: Pad_2528_16903_290
CMP291: Pad_2552_17182_291
CMP292: Pad_1448_17143_292
CMP293: Pad_1377_17344_293
CMP294: Pad_1166_18029_294
CMP295: Pad_1544_18281_295
CMP296: Pad_1357_18649_296
CMP297: Pad_1241_19035_297
CMP298: Pad_1231_19291_298
CMP299: Pad_1427_19466_299
CMP300: Pad_1487_20177_300
CMP301: Pad_558_19973_301
CMP302: Pad_590_19284_302
CMP303: Pad_1523_16112_303
CMP304: Pad_1237_15738_304
CMP305: Pad_4787_15330_305
CMP306: Pad_4788_15491_306
CMP307: Pad_4979_15991_307
CMP308: Pad_2780_15474_308
CMP309: Pad_3306_1265_309
CMP310: Pad_729_15499_310
CMP311: Pad_476_23482_311
CMP312: Pad_6451_23101_312
CMP313: Pad_6321_22973_313
CMP314: Pad_5815_23131_314
CMP315: Pad_7337_23100_315
CMP316: Pad_7305_22084_316
CMP317: Pad_7940_22973_317
CMP318: Pad_8067_22719_318
CMP319: Pad_8226_22021_319
CMP320: Pad_7748_22370_320
CMP321: Pad_7702_21198_321
CMP322: Pad_7819_21449_322
CMP323: Pad_7954_21521_323
CMP324: Pad_8059_21631_324
CMP325: Pad_8406_21769_325
CMP326: Pad_8295_21488_326
CMP327: Pad_8306_21306_327
CMP328: Pad_8300_20932_328
CMP329: Pad_7691_20433_329
CMP330: Pad_7859_20179_330
CMP331: Pad_7379_19864_331
CMP332: Pad_8206_19664_332
CMP333: Pad_8683_21563_333
CMP334: Pad_8800_21187_334
CMP335: Pad_8892_21702_335
CMP336: Pad_7933_23349_336
CMP337: Pad_8689_23216_337
CMP338: Pad_9196_23239_338
CMP339: Pad_9375_23231_339
CMP340: Pad_8432_23094_340
CMP341: Pad_8206_23332_341
CMP342: Pad_8735_20056_342
CMP343: Pad_8850_19914_343
CMP344: Pad_8855_19665_344
CMP345: Pad_8729_18930_345
CMP346: Pad_8198_19413_346
CMP347: Pad_7753_19485_347
CMP348: Pad_7376_18997_348
CMP349: Pad_7373_18812_349
CMP350: Pad_7884_18774_350
CMP351: Pad_8324_18878_351
CMP352: Pad_8334_18537_352
CMP353: Pad_8826_18533_353
CMP354: Pad_8836_18275_354
CMP355: Pad_9598_21064_355
CMP356: Pad_9330_20290_356
CMP357: Pad_9662_20432_357
CMP358: Pad_9981_20617_358
CMP359: Pad_10139_20676_359
CMP360: Pad_10327_20756_360
CMP361: Pad_10544_20617_361
CMP362: Pad_9906_19936_362
CMP363: Pad_9844_19791_363
CMP364: Pad_9729_19654_364
CMP365: Pad_9839_19531_365
CMP366: Pad_9976_19408_366
CMP367: Pad_10105_19780_367
CMP368: Pad_10087_18789_368
CMP369: Pad_10043_18485_369
CMP370: Pad_9688_18700_370
CMP371: Pad_9458_18906_371
CMP372: Pad_9327_19196_372
CMP373: Pad_9335_19416_373
CMP374: Pad_9532_18091_374
CMP375: Pad_9353_18023_375
CMP376: Pad_9695_17897_376
CMP377: Pad_8827_17837_377
CMP378: Pad_7878_18278_378
CMP379: Pad_7318_18268_379
CMP380: Pad_8460_16748_380
CMP381: Pad_7953_16249_381
CMP382: Pad_8217_15741_382
CMP383: Pad_8217_15482_383
CMP384: Pad_8600_15221_384
CMP385: Pad_8458_14984_385
CMP386: Pad_8695_14844_386
CMP387: Pad_7953_14472_387
CMP388: Pad_8076_14229_388
CMP389: Pad_7963_13975_389
CMP390: Pad_8336_14099_390
CMP391: Pad_8470_13899_391
CMP392: Pad_8452_14340_392
CMP393: Pad_8542_13263_393
CMP394: Pad_8708_13324_394
CMP395: Pad_9097_13204_395
CMP396: Pad_8930_13960_396
CMP397: Pad_7059_14213_397
CMP398: Pad_7326_13484_398
CMP399: Pad_7330_15621_399
CMP400: Pad_7327_12434_400
CMP401: Pad_8582_12308_401
CMP402: Pad_7965_11930_402
CMP403: Pad_8840_11801_403
CMP404: Pad_6961_12062_404
CMP405: Pad_609_11425_405
CMP406: Pad_4797_14626_406
CMP407: Pad_1854_22211_407
CMP408: Pad_7062_18260_408
CMP409: Pad_6006_9665_409
CMP410: Pad_9485_3295_410
CMP411: Pad_9737_2499_411
CMP412: Pad_10113_11410_412
CMP413: Pad_10363_13049_413
CMP414: Pad_10188_13066_414
CMP415: Pad_9835_13334_415
CMP416: Pad_9996_12561_416
CMP417: Pad_10944_12690_417
CMP418: Pad_11125_12690_418
CMP419: Pad_9346_15869_419
CMP420: Pad_9343_16182_420
CMP421: Pad_6572_11181_421
CMP422: Pad_10484_14596_422
CMP423: Pad_10617_14087_423
CMP424: Pad_10742_14341_424
CMP425: Pad_10993_14213_425
CMP426: Pad_11206_14072_426
CMP427: Pad_10244_15105_427
CMP428: Pad_10484_15362_428
CMP429: Pad_11122_15237_429
CMP430: Pad_10869_15724_430
CMP431: Pad_10113_15994_431
CMP432: Pad_10493_16240_432
CMP433: Pad_10520_16620_433
CMP434: Pad_11769_11557_434
CMP435: Pad_11774_11932_435
CMP436: Pad_11017_2780_436
CMP437: Pad_12404_12441_437
CMP438: Pad_12466_12661_438
CMP439: Pad_12661_12697_439
CMP440: Pad_12912_13107_440
CMP441: Pad_13233_13072_441
CMP442: Pad_13288_13390_442
CMP443: Pad_13352_12059_443
CMP444: Pad_13288_11805_444
CMP445: Pad_13484_11118_445
CMP446: Pad_13279_10658_446
CMP447: Pad_13918_11932_447
CMP448: Pad_13979_12433_448
CMP449: Pad_14171_12439_449
CMP450: Pad_12084_13708_450
CMP451: Pad_11777_13547_451
CMP452: Pad_11955_15296_452
CMP453: Pad_12268_14986_453
CMP454: Pad_12373_14732_454
CMP455: Pad_11976_14347_455
CMP456: Pad_12651_15233_456
CMP457: Pad_11633_15875_457
CMP458: Pad_12268_15725_458
CMP459: Pad_12286_16316_459
CMP460: Pad_12902_15997_460
CMP461: Pad_13087_15738_461
CMP462: Pad_13240_15662_462
CMP463: Pad_13405_15612_463
CMP464: Pad_13551_15547_464
CMP465: Pad_13699_15479_465
CMP466: Pad_13811_15369_466
CMP467: Pad_10865_18025_467
CMP468: Pad_10611_16818_468
CMP469: Pad_10769_16498_469
CMP470: Pad_10992_16247_470
CMP471: Pad_11119_16977_471
CMP472: Pad_11817_17263_472
CMP473: Pad_12325_17263_473
CMP474: Pad_12897_16755_474
CMP475: Pad_12833_17390_475
CMP476: Pad_13405_17072_476
CMP477: Pad_13913_16882_477
CMP478: Pad_14166_16755_478
CMP479: Pad_14421_16564_479
CMP480: Pad_14103_18025_480
CMP481: Pad_13899_17959_481
CMP482: Pad_13953_18293_482
CMP483: Pad_14249_18777_483
CMP484: Pad_14181_19031_484
CMP485: Pad_13405_19803_485
CMP486: Pad_13781_19670_486
CMP487: Pad_13979_19835_487
CMP488: Pad_13888_19988_488
CMP489: Pad_12244_20561_489
CMP490: Pad_12412_20557_490
CMP491: Pad_12729_20421_491
CMP492: Pad_12380_19294_492
CMP493: Pad_12376_19475_493
CMP494: Pad_11878_19167_494
CMP495: Pad_11873_18520_495
CMP496: Pad_11878_19674_496
CMP497: Pad_12629_21063_497
CMP498: Pad_11739_21700_498
CMP499: Pad_11753_20868_499
CMP500: Pad_11481_20895_500
CMP501: Pad_10983_20812_501
CMP502: Pad_11599_20282_502
CMP503: Pad_10978_19670_503
CMP504: Pad_10987_18909_504
CMP505: Pad_11212_18909_505
CMP506: Pad_11889_18045_506
CMP507: Pad_11118_11936_507
CMP508: Pad_11643_12683_508
CMP509: Pad_13279_14480_509
CMP510: Pad_14122_15561_510
CMP511: Pad_14233_15422_511
CMP512: Pad_14268_15097_512
CMP513: Pad_14171_14721_513
CMP514: Pad_13850_14596_514
CMP515: Pad_13909_14222_515
CMP516: Pad_14063_14038_516
CMP517: Pad_14143_13899_517
CMP518: Pad_14115_13505_518
CMP519: Pad_14181_13219_519
CMP520: Pad_14429_13222_520
CMP521: Pad_13661_13447_521
CMP522: Pad_15197_13462_522
CMP523: Pad_15593_13543_523
CMP524: Pad_15706_13397_524
CMP525: Pad_15756_13959_525
CMP526: Pad_15724_14447_526
CMP527: Pad_15631_14744_527
CMP528: Pad_15808_14810_528
CMP529: Pad_16172_14574_529
CMP530: Pad_16340_15340_530
CMP531: Pad_16408_14831_531
CMP532: Pad_16402_14463_532
CMP533: Pad_16410_14279_533
CMP534: Pad_16271_14063_534
CMP535: Pad_16247_13890_535
CMP536: Pad_16091_14083_536
CMP537: Pad_15316_14834_537
CMP538: Pad_15780_15402_538
CMP539: Pad_15440_15257_539
CMP540: Pad_15182_15405_540
CMP541: Pad_15378_14206_541
CMP542: Pad_16397_13366_542
CMP543: Pad_16236_13029_543
CMP544: Pad_16641_13441_544
CMP545: Pad_9847_17198_545
CMP546: Pad_10206_22464_546
CMP547: Pad_10777_21941_547
CMP548: Pad_13662_5568_548
CMP549: Pad_17249_1685_549
CMP550: Pad_16891_2100_550
CMP551: Pad_16914_2254_551
CMP552: Pad_16845_2393_552
CMP553: Pad_16731_2512_553
CMP554: Pad_16468_4173_554
CMP555: Pad_16909_4165_555
CMP556: Pad_16474_12052_556
CMP557: Pad_16603_12296_557
CMP558: Pad_16990_11798_558
CMP559: Pad_16979_11551_559
CMP560: Pad_17115_12488_560
CMP561: Pad_16997_13376_561
CMP562: Pad_17540_13303_562
CMP563: Pad_17875_14261_563
CMP564: Pad_17892_13826_564
CMP565: Pad_20564_7098_565
CMP566: Pad_21437_7091_566
CMP567: Pad_21520_7798_567
CMP568: Pad_21453_8236_568
CMP569: Pad_22011_8006_569
CMP570: Pad_20216_8805_570
CMP571: Pad_19360_8894_571
CMP572: Pad_19496_9013_572
CMP573: Pad_19633_9118_573
CMP574: Pad_19770_9212_574
CMP575: Pad_20026_9600_575
CMP576: Pad_19842_9747_576
CMP577: Pad_20044_10009_577
CMP578: Pad_19296_10397_578
CMP579: Pad_18774_10267_579
CMP580: Pad_18326_11027_580
CMP581: Pad_19394_10656_581
CMP582: Pad_19407_10909_582
CMP583: Pad_20036_10529_583
CMP584: Pad_20294_10511_584
CMP585: Pad_20357_11023_585
CMP586: Pad_19919_10900_586
CMP587: Pad_20000_11093_587
CMP588: Pad_19788_11159_588
CMP589: Pad_19922_11276_589
CMP590: Pad_20043_11530_590
CMP591: Pad_19909_11792_591
CMP592: Pad_19532_11670_592
CMP593: Pad_19526_11513_593
CMP594: Pad_19656_11410_594
CMP595: Pad_20153_12046_595
CMP596: Pad_19909_12043_596
CMP597: Pad_19909_12260_597
CMP598: Pad_19909_12480_598
CMP599: Pad_20033_9384_599
CMP600: Pad_19083_8828_600
CMP601: Pad_18303_7970_601
CMP602: Pad_17784_7970_602
CMP603: Pad_18534_9389_603
CMP604: Pad_17439_10136_604
CMP605: Pad_17326_10271_605
CMP606: Pad_17656_10339_606
CMP607: Pad_16814_9909_607
CMP608: Pad_17072_10036_608
CMP609: Pad_17045_10434_609
CMP610: Pad_17235_10900_610
CMP611: Pad_20812_9362_611
CMP612: Pad_20808_9631_612
CMP613: Pad_16984_3794_613
CMP614: Pad_17236_3638_614
CMP615: Pad_16718_2780_615
CMP616: Pad_15094_3032_616
CMP617: Pad_6334_9125_617
CMP618: Pad_12414_2780_618
CMP619: Pad_15362_11432_619
CMP620: Pad_16571_4932_620
CMP621: Pad_16581_5198_621
CMP622: Pad_17239_9639_622
CMP623: Pad_17024_5965_623
CMP624: Pad_17048_6327_624
CMP625: Pad_17384_4864_625
CMP626: Pad_17495_5315_626
CMP627: Pad_17757_5204_627
CMP628: Pad_17889_5068_628
CMP629: Pad_17816_4518_629
CMP630: Pad_17760_5697_630
CMP631: Pad_18418_5693_631
CMP632: Pad_18645_4289_632
CMP633: Pad_19038_4669_633
CMP634: Pad_19178_5509_634
CMP635: Pad_19777_4923_635
CMP636: Pad_20796_5574_636
CMP637: Pad_22828_4812_637
CMP638: Pad_22828_4558_638
CMP639: Pad_21812_5955_639
CMP640: Pad_21463_5923_640
CMP641: Pad_11882_23091_641
CMP642: Pad_7005_13966_642
CMP643: Pad_7177_13963_643
CMP644: Pad_6697_13402_644
CMP645: Pad_6959_13460_645
CMP646: Pad_7106_13452_646
CMP647: Pad_11889_13891_647
CMP648: Pad_11889_14084_648
CMP649: Pad_11972_14571_649
CMP650: Pad_11976_14728_650
CMP651: Pad_12629_21063_651
CMP652: Pad_11125_21049_652
CMP653: Pad_12225_23489_653
CMP654: Pad_13386_21693_654
CMP655: Pad_13882_23222_655
CMP656: Pad_14191_21068_656
CMP657: Pad_15552_20609_657
CMP658: Pad_15877_20391_658
CMP659: Pad_16185_20606_659
CMP660: Pad_16704_20544_660
CMP661: Pad_17041_20495_661
CMP662: Pad_17198_20654_662
CMP663: Pad_17724_20674_663
CMP664: Pad_17676_19864_664
CMP665: Pad_18108_20418_665
CMP666: Pad_18366_20422_666
CMP667: Pad_18843_20571_667
CMP668: Pad_19129_20794_668
CMP669: Pad_19380_20491_669
CMP670: Pad_19394_19648_670
CMP671: Pad_17819_19652_671
CMP672: Pad_18070_19526_672
CMP673: Pad_18505_19784_673
CMP674: Pad_17828_18898_674
CMP675: Pad_17936_18767_675
CMP676: Pad_17678_18783_676
CMP677: Pad_17678_18394_677
CMP678: Pad_17083_18796_678
CMP679: Pad_17279_18772_679
CMP680: Pad_17046_18483_680
CMP681: Pad_17043_18268_681
CMP682: Pad_17477_18078_682
CMP683: Pad_17483_17912_683
CMP684: Pad_15716_21068_684
CMP685: Pad_17240_21068_685
CMP686: Pad_18764_21068_686
CMP687: Pad_20288_21068_687
CMP688: Pad_19510_21683_688
CMP689: Pad_19891_20604_689
CMP690: Pad_20174_20619_690
CMP691: Pad_20442_20515_691
CMP692: Pad_20643_20408_692
CMP693: Pad_20882_20405_693
CMP694: Pad_20915_19899_694
CMP695: Pad_21715_20004_695
CMP696: Pad_21868_19381_696
CMP697: Pad_21849_20165_697
CMP698: Pad_21837_20309_698
CMP699: Pad_21965_19249_699
CMP700: Pad_21951_19008_700
CMP701: Pad_21765_18816_701
CMP702: Pad_21797_18523_702
CMP703: Pad_21986_18410_703
CMP704: Pad_21989_18260_704
CMP705: Pad_21287_18071_705
CMP706: Pad_21594_17945_706
CMP707: Pad_20041_19664_707
CMP708: Pad_20548_17880_708
CMP709: Pad_21038_17740_709
CMP710: Pad_19863_17681_710
CMP711: Pad_19692_17499_711
CMP712: Pad_19997_17370_712
CMP713: Pad_16300_23198_713
CMP714: Pad_12397_20107_714
CMP715: Pad_12386_19928_715
CMP716: Pad_12643_18268_716
CMP717: Pad_15208_16505_717
CMP718: Pad_15427_16600_718
CMP719: Pad_15301_16742_719
CMP720: Pad_15166_16868_720
CMP721: Pad_15293_16988_721
CMP722: Pad_15688_16670_722
CMP723: Pad_15826_16895_723
CMP724: Pad_15957_15997_724
CMP725: Pad_15702_17260_725
CMP726: Pad_16174_17306_726
CMP727: Pad_16062_17064_727
CMP728: Pad_16238_17070_728
CMP729: Pad_16268_16901_729
CMP730: Pad_16669_16666_730
CMP731: Pad_17091_16241_731
CMP732: Pad_16366_16158_732
CMP733: Pad_17258_17262_733
CMP734: Pad_17480_17394_734
CMP735: Pad_17683_17068_735
CMP736: Pad_18109_17385_736
CMP737: Pad_18154_17018_737
CMP738: Pad_18320_16748_738
CMP739: Pad_18318_16557_739
CMP740: Pad_18320_16390_740
CMP741: Pad_18303_16146_741
CMP742: Pad_18773_16179_742
CMP743: Pad_19528_16622_743
CMP744: Pad_19515_16997_744
CMP745: Pad_19284_16922_745
CMP746: Pad_19209_16335_746
CMP747: Pad_19156_15946_747
CMP748: Pad_19619_16097_748
CMP749: Pad_19654_15928_749
CMP750: Pad_16091_19655_750
CMP751: Pad_16268_19279_751
CMP752: Pad_16334_18512_752
CMP753: Pad_15425_19024_753
CMP754: Pad_15519_19362_754
CMP755: Pad_15540_18767_755
CMP756: Pad_16850_14591_756
CMP757: Pad_17097_14225_757
CMP758: Pad_17161_13871_758
CMP759: Pad_17182_14651_759
CMP760: Pad_16950_13525_760
CMP761: Pad_14421_15993_761
CMP762: Pad_18596_14680_762
CMP763: Pad_19271_15122_763
CMP764: Pad_19376_15480_764
CMP765: Pad_19529_14729_765
CMP766: Pad_19525_14986_766
CMP767: Pad_22076_13058_767
CMP768: Pad_22266_13191_768
CMP769: Pad_22080_13575_769
CMP770: Pad_21878_13493_770
CMP771: Pad_21687_13431_771
CMP772: Pad_21226_13181_772
CMP773: Pad_21697_12557_773
CMP774: Pad_21575_12041_774
CMP775: Pad_21471_11787_775
CMP776: Pad_22643_11733_776
CMP777: Pad_22647_11529_777
CMP778: Pad_22430_14009_778
CMP779: Pad_22579_14197_779
CMP780: Pad_22319_14327_780
CMP781: Pad_22206_14579_781
CMP782: Pad_22198_14847_782
CMP783: Pad_22528_14515_783
CMP784: Pad_22499_14700_784
CMP785: Pad_22297_14972_785
CMP786: Pad_22429_15219_786
CMP787: Pad_22369_15474_787
CMP788: Pad_22194_15715_788
CMP789: Pad_21804_15591_789
CMP790: Pad_21770_14947_790
CMP791: Pad_21812_14700_791
CMP792: Pad_21293_14697_792
CMP793: Pad_21854_15962_793
CMP794: Pad_21690_16191_794
CMP795: Pad_21885_16742_795
CMP796: Pad_21721_16878_796
CMP797: Pad_20397_15596_797
CMP798: Pad_20568_15091_798
CMP799: Pad_20753_16735_799
CMP800: Pad_20871_16477_800
CMP801: Pad_21178_16219_801
CMP802: Pad_21307_16132_802
CMP803: Pad_21054_13566_803
CMP804: Pad_21054_12679_804
CMP805: Pad_22459_12557_805
CMP806: Pad_22491_11287_806
CMP807: Pad_22427_11033_807
CMP808: Pad_22395_10740_808
CMP809: Pad_21697_11033_809
CMP810: Pad_21824_10683_810
CMP811: Pad_21697_10398_811
CMP812: Pad_22351_10461_812
CMP813: Pad_22443_10001_813
CMP814: Pad_21062_9890_814
CMP815: Pad_21697_7604_815
CMP816: Pad_22967_7445_816
CMP817: Pad_23348_7604_817
CMP818: Pad_21272_4285_818
CMP819: Pad_19253_6853_819
CMP820: Pad_19412_7341_820
CMP821: Pad_23105_6534_821
CMP822: Pad_22180_20328_822
CMP823: Pad_22070_20437_823
CMP824: Pad_20284_17879_824
CMP825: Pad_21022_22940_825
CMP826: Pad_21025_22691_826
CMP827: Pad_20902_22317_827
CMP828: Pad_21030_21921_828
CMP829: Pad_20906_21544_829
CMP830: Pad_20908_21290_830
CMP831: Pad_21295_21040_831
CMP832: Pad_21552_21051_832
CMP833: Pad_21009_20278_833
CMP834: Pad_21045_17995_834
CMP835: Pad_18510_12686_835
CMP836: Pad_17616_11154_836
CMP837: Pad_17616_12170_837
CMP838: Pad_17616_12361_838
CMP839: Pad_18016_10837_839
CMP840: Pad_17868_12192_840
CMP841: Pad_18010_11659_841
CMP842: Pad_18206_8432_842
CMP843: Pad_20931_15856_843
CMP844: Pad_21812_16467_844
CMP845: Pad_18902_12045_845
CMP846: Pad_22815_16174_846
CMP847: Pad_23240_15588_847
CMP848: Pad_23091_17756_848
CMP849: Pad_23370_20241_849
CMP850: Pad_23326_13552_850
CMP851: Pad_23330_14190_851
CMP852: Pad_23053_13200_852
CMP853: Pad_20024_1502_853
CMP854: Pad_20038_1993_854
CMP855: Pad_19530_1746_855
CMP856: Pad_19024_1753_856
CMP857: Pad_19247_2007_857
CMP858: Pad_18645_1484_858
CMP859: Pad_18383_1488_859
CMP860: Pad_19763_2780_860
CMP861: Pad_20272_2774_861
CMP862: Pad_20922_1499_862
CMP863: Pad_21182_1499_863
CMP864: Pad_22839_2247_864
CMP865: Pad_1979_22335_865
CMP866: Pad_1855_21826_866
CMP867: Pad_1853_21314_867
CMP868: Pad_21536_23338_868
CMP869: Pad_18252_23485_869
CMP870: Pad_16968_1761_870
CMP871: Pad_16968_1253_871
CMP872: Pad_16968_301_872
CMP873: Pad_17774_1789_873
CMP874: Pad_19519_276_874
CMP875: Pad_22281_1780_875
CMP876: Pad_20016_3299_876
CMP877: Pad_23469_491_877
CMP878: Pad_12599_521_878
CMP879: Pad_10142_501_879
CMP880: Pad_8371_486_880
CMP881: Pad_536_527_881
CMP882: Pad_23445_23445_882
CMP883: Pad_22580_4047_883
CMP884: Pad_1588_22101_884
CMP885: Pad_1091_21964_885
CMP886: Pad_711_21955_886
CMP887: Pad_1205_22334_887
CMP888: Pad_964_22591_888
CMP889: Pad_740_22643_889
CMP890: Pad_727_22338_890
CMP891: Pad_15694_12419_891
CMP892: Pad_20293_8592_892
CMP893: Pad_11641_17010_893
CMP894: Pad_6328_2301_894
CMP895: Pad_6845_2297_895
CMP896: Pad_6341_1302_896
CMP897: Pad_2791_2286_897
CMP898: Pad_3306_1265_898
CMP899: Pad_2798_1265_899
CMP900: Pad_3299_2286_900
CMP901: Pad_6845_1275_901
CMP902: Pad_8594_1739_902
CMP903: Pad_9105_1757_903
CMP904: FP_17875_14718_904
CMP905: FP_19399_14718_905
CMP906: FP_6064_15353_906
CMP907: FP_8350_15353_907
CMP908: FP_10636_15353_908
CMP917: Pad_12173_17642_917
CMP918: Pad_12173_17896_918
CMP947: Pad_17362_12170_947
CMP948: Pad_17362_12361_948
CMP949: Pad_22828_3034_949
CMP950: Pad_22828_3288_950
CMP951: Pad_22828_3542_951
CMP952: Pad_22828_3796_952
CMP953: Pad_22845_18008_953
CMP954: Pad_23099_18008_954
CMP955: Pad_22845_18262_955
CMP956: Pad_23099_18262_956
CMP957: Pad_22845_18516_957
CMP958: Pad_23099_18516_958
CMP959: Pad_22845_18770_959
CMP960: Pad_23099_18770_960
CMP961: Pad_22845_19024_961
CMP962: Pad_23099_19024_962
CMP963: Pad_22845_19278_963
CMP964: Pad_23099_19278_964
CMP965: Pad_22845_19532_965
CMP966: Pad_23099_19532_966
CMP967: Pad_22845_19786_967
CMP968: Pad_23099_19786_968
CMP969: Pad_22845_20040_969
CMP970: Pad_23099_20040_970
CMP971: Pad_22845_20294_971
CMP972: Pad_23099_20294_972
CMP973: Pad_22845_20548_973
CMP974: Pad_23099_20548_974
CMP975: Pad_22845_20802_975
CMP976: Pad_23099_20802_976
CMP977: Pad_22845_21056_977
CMP978: Pad_23099_21056_978
CMP979: Pad_22845_21310_979
CMP980: Pad_23099_21310_980
CMP981: Pad_22845_21564_981
CMP982: Pad_23099_21564_982
CMP983: Pad_22845_21818_983
CMP984: Pad_23099_21818_984
CMP985: Pad_22845_22072_985
CMP986: Pad_23099_22072_986
CMP987: Pad_22847_13436_987
CMP988: Pad_22847_13690_988
CMP989: Pad_22847_13944_989
CMP990: Pad_22847_14197_990
CMP991: Pad_22847_14452_991
CMP992: Pad_22847_14706_992
CMP993: Pad_22847_14960_993
CMP994: Pad_22847_15213_994
CMP995: Pad_22847_15468_995
CMP996: Pad_22847_15722_996
CMP997: Pad_22847_15976_997
CMP998: Pad_17246_11396_998
CMP999: Pad_17246_11650_999
CMP1000: Pad_17246_11904_1000
CMP1001: Pad_1462_23355_1001
CMP1002: Pad_1716_23355_1002
CMP1003: Pad_1970_23355_1003
CMP1004: Pad_2224_23355_1004
CMP1005: FP_22066_10273_1005
CMP1006: FP_19780_11035_1006
CMP1007: FP_19399_6844_1007
CMP1008: FP_22955_6209_1008
CMP1009: FP_10255_22211_1009
CMP1010: FP_11779_22211_1010
CMP1011: FP_13303_22211_1011
CMP1012: FP_14827_22211_1012
CMP1013: FP_16351_22211_1013
CMP1014: FP_17875_22211_1014
CMP1015: FP_19399_22211_1015
CMP1016: FP_20923_22211_1016
CMP1017: FP_6064_20687_1017
CMP1018: FP_8350_20687_1018
CMP1019: FP_11779_19163_1019
CMP1020: FP_13303_18909_1020
CMP1021: FP_14827_18909_1021
CMP1022: FP_16351_18909_1022
CMP1023: FP_17875_19163_1023
CMP1024: FP_19399_19163_1024
CMP1025: FP_3017_19671_1025
CMP1033: FP_1746_6971_1033
CMP1034: FP_1366_11543_1034
CMP1035: FP_2890_11543_1035
CMP1036: FP_1366_14464_1036
CMP1037: FP_2890_14464_1037
CMP1038: FP_1366_16877_1038
CMP1039: FP_1366_19417_1039
CMP1040: FP_5683_11797_1040
CMP1041: FP_7207_11797_1041
CMP1042: FP_8731_11797_1042
CMP1043: FP_10255_11797_1043
CMP1044: FP_11779_11797_1044
CMP1045: FP_13303_11670_1045
CMP1046: FP_14827_11670_1046
CMP1047: FP_16351_11670_1047
CMP1048: FP_13303_14464_1048
CMP1049: FP_14827_14464_1049
CMP1050: FP_16351_14464_1050
CMP1160: FP_14431_1036_1160
CMP1255: FP_19377_8634_1255
CMP1259: FP_17985_3760_1259
CMP1262: FP_12372_14237_1262
CMP1263: FP_12168_17768_1263
CMP1265: FP_17354_5060_1265
CMP1266: FP_3798_18813_1266
CMP1271: FP_2225_3185_1271
CMP1272: FP_4911_1725_1272
CMP1273: FP_4942_734_1273
CMP1275: FP_3172_2771_1275
D: FP_21558_14464_919
D#2: FP_21558_14210_920
D#3: FP_21558_13956_921
D#4: FP_21558_13702_922
D#5: FP_858_22961_1148
D#6: FP_1620_22223_1149
D#7: FP_20542_14718_1218
D#8: FP_20542_14464_1219
D#9: FP_20542_14972_1220
D#10: FP_20542_15226_1221
D#11: FP_20542_14210_1222
D#12: FP_20542_13956_1223
D#13: FP_20542_13702_1224
D#14: FP_18256_10780_1226
D#15: FP_20669_6590_1227
D#16: FP_20669_6336_1228
D#17: FP_21177_2525_1233
D#18: FP_21177_1255_1234
D#19: FP_21177_1764_1235
D#20: FP_18129_6081_1236
D#21: FP_18002_6336_1237
D#22: FP_18002_6590_1238
D#23: FP_18002_6844_1239
D#24: FP_18002_7098_1240
D#25: FP_18002_7352_1241
D#26: FP_16478_16622_1245
D#27: FP_15970_16877_1246
J: FP_1492_2272_1113
J1: FP_5027_6354_1026
J2: FP_6932_6354_1027
J3: FP_8837_6354_1028
J4: FP_10742_6354_1029
J5: FP_12647_6354_1030
J6: FP_14552_6354_1031
J7: FP_16457_6354_1032
Q: FP_20001_4304_1231
Q#2: FP_20829_4294_1232
Q#3: FP_18275_9859_1252
Q#4: FP_18529_9090_1253
Q#5: FP_753_20827_1264
R: FP_20523_18274_923
R#2: FP_21285_18274_924
R#3: FP_20523_18528_925
R#4: FP_21285_18528_926
R#5: FP_20523_18782_927
R#6: FP_21285_18782_928
R#7: FP_20523_19036_929
R#8: FP_21285_19036_930
R#9: FP_20523_19290_931
R#10: FP_21285_19290_932
R#11: FP_20523_19544_933
R#12: FP_21285_19544_934
R#13: FP_20523_19798_935
R#14: FP_21285_19798_936
R#15: FP_20523_20052_937
R#16: FP_21285_20052_938
R#17: FP_21793_21322_939
R#18: FP_21793_21576_940
R#19: FP_21793_21830_941
R#20: FP_21793_22084_942
R#21: FP_21793_22338_943
R#22: FP_21793_22592_944
R#23: FP_21793_22846_945
R#24: FP_21793_23100_946
R#25: FP_2997_4812_1051
R#26: FP_2997_5066_1052
R#27: FP_2997_5320_1053
R#28: FP_2997_5574_1054
R#29: FP_2997_5828_1055
R#30: FP_3378_6082_1056
R#31: FP_4052_3415_1076
R#32: FP_3671_4304_1077
R#33: FP_10128_2290_1091
R#34: FP_10382_2290_1092
R#35: FP_10636_2290_1093
R#36: FP_10890_2290_1094
R#37: FP_11271_1782_1095
R#38: FP_11525_1782_1096
R#39: FP_10617_18274_1099
R#40: FP_10617_18528_1100
R#41: FP_10617_18782_1101
R#42: FP_10617_19036_1102
R#43: FP_10617_19290_1103
R#44: FP_10617_19544_1104
R#45: FP_10617_19798_1105
R#46: FP_10617_20052_1106
R#47: FP_10617_20306_1107
R#48: FP_9366_21467_1109
R#49: FP_9366_22356_1110
R#50: FP_1473_13194_1114
R#51: FP_2000_13429_1115
R#52: FP_730_13175_1116
R#53: FP_2000_19017_1123
R#54: FP_2254_19525_1124
R#55: FP_2000_16477_1125
R#56: FP_2254_16477_1126
R#57: FP_7327_17749_1127
R#58: FP_4279_22465_1128
R#59: FP_1347_21068_1134
R#60: FP_839_21322_1135
R#61: FP_839_21576_1136
R#62: FP_1474_22846_1142
R#63: FP_1601_23100_1143
R#64: FP_2109_23100_1144
R#65: FP_1474_22592_1145
R#66: FP_2001_22738_1146
R#67: FP_10998_10908_1150
R#68: FP_10998_11162_1151
R#69: FP_10998_11416_1152
R#70: FP_10998_11670_1153
R#71: FP_12553_11559_1154
R#72: FP_11926_16369_1155
R#73: FP_12382_18509_1157
R#74: FP_16238_1742_1161
R#75: FP_16492_1742_1162
R#76: FP_18028_12559_1164
R#77: FP_18028_10781_1165
R#78: FP_17774_10781_1166
R#79: FP_17514_9257_1168
R#80: FP_17768_9257_1169
R#81: FP_18237_7606_1171
R#82: FP_18129_7880_1172
R#83: FP_18129_8134_1173
R#84: FP_18129_8388_1174
R#85: FP_19653_7880_1175
R#86: FP_18129_5848_1178
R#87: FP_18891_5594_1179
R#88: FP_18891_5086_1180
R#89: FP_18891_4832_1181
R#90: FP_18637_4324_1182
R#91: FP_18637_4070_1183
R#92: FP_18891_3054_1184
R#93: FP_18891_2292_1185
R#94: FP_19653_1022_1186
R#95: FP_21177_1022_1187
R#96: FP_21177_2038_1188
R#97: FP_21177_2292_1189
R#98: FP_21177_2800_1190
R#99: FP_21177_3054_1191
R#100: FP_22193_4324_1198
R#101: FP_20669_7372_1199
R#102: FP_12795_2546_1202
R#103: FP_17006_18401_1206
R#104: FP_18745_16750_1212
R#105: FP_18745_17004_1213
R#106: FP_18745_17258_1214
R#107: FP_18745_17512_1215
R#108: FP_23356_9003_1229
R#109: FP_23356_12051_1230
R#110: FP_15736_16876_1247
R#111: FP_20015_17258_1248
R#112: FP_20015_17004_1249
R#113: FP_20015_16750_1250
R#114: FP_20015_16496_1251

Connections:
Net-2: CMP2.1, CMP250.1, CMP387.1, CMP422.1, CMP906.15, CMP907.15, CMP1017.36, CMP1034.14, CMP1043.16, D#22.2, J1.44, J2.44, J3.44, J4.44, J5.44, J6.44, J7.44
Net-3: CMP3.1, CMP428.1, CMP906.12, CMP907.12, CMP1017.34, CMP1034.18, D#21.2, J1.42, J2.42, J3.42, J4.42, J5.42, J6.42, J7.42
Net-4: CMP4.1, CMP389.1, CMP423.1, CMP906.17, CMP907.17, CMP1017.37, CMP1034.10, CMP1043.14, D#23.2, J1.46, J2.46, J3.46, J4.46, J5.46, J6.46, J7.46
Net-5: CMP5.1, CMP388.1, CMP424.1, CMP906.19, CMP907.19, CMP1017.38, CMP1034.7, CMP1043.13, D#24.2, J1.48, J2.48, J3.48, J4.48, J5.48, J6.48, J7.48
Net-6: CMP6.1, CMP1033.37, CMP1035.2
Net-7: CMP7.1, CMP1033.38, CMP1035.4
Net-8: CMP8.1, CMP1033.39, CMP1035.11
Net-9: CMP9.1, CMP1033.40, CMP1035.15
Net-10: CMP10.1, CMP16.1, CMP30.1, CMP272.1, CMP405.1, CMP1038.2, J1.21, J2.21, J3.21, J4.21, J5.21, J6.21, J7.21, R#30.2
Net-11: CMP11.1, CMP55.1, CMP199.1, CMP478.1, CMP482.1, CMP487.1, CMP658.1, CMP669.1, CMP688.1, CMP906.20, CMP907.20, CMP1016.2, CMP1016.7, CMP1017.39, CMP1018.31, CMP1020.7, CMP1021.20, CMP1025.30, CMP1033.29, R#49.2
Net-12: CMP12.1, CMP57.1, CMP718.1, CMP755.1, CMP906.21, CMP907.21, CMP1020.8, CMP1021.18, CMP1025.28, CMP1033.28
Net-13: CMP13.1, CMP58.1, CMP477.1, CMP486.1, CMP753.1, CMP906.22, CMP907.22, CMP1014.2, CMP1014.7, CMP1020.14, CMP1021.16, CMP1022.13, CMP1025.22, CMP1033.27
Net-14: CMP14.1, CMP68.1, CMP1041.7, J1.31
Net-15: C#4.3, C#8.3, C#15.1, C#15.2, C#23.1, C#23.2, C#25.3, C#26.3, C#36.1, C#36.2, CMP15.1, CMP614.1, CMP617.1, CMP622.1, CMP949.1, CMP1273.2, J1.49, J2.49, J3.49, J4.49, J5.49, J6.49, J7.49, R#31.1, R#32.1
Net-16: CMP17.1, CMP49.1, CMP75.1, CMP216.1, CMP906.2, CMP1017.20, CMP1035.3, J1.24, J2.24, J3.24, J4.24, J5.24, J6.24, J7.24
Net-17: CMP18.1, CMP61.1, CMP69.1, CMP128.1, CMP139.1, CMP175.1, CMP217.1, CMP447.1, CMP515.1, CMP906.7, CMP1017.18, CMP1035.9, CMP1046.9, CMP1048.7, J1.22, J2.22, J3.22, J4.22, J5.22, J6.22, J7.22
Net-18: CMP19.1, CMP70.1, CMP218.1, CMP228.1, CMP242.1, CMP243.1, CMP342.1, CMP353.1, CMP420.1, CMP908.19, CMP1017.16, CMP1018.6, CMP1025.46, CMP1035.12, J1.20, J2.20, J3.20, J4.20, J5.20, J6.20, J7.20
Net-19: CMP20.1, CMP35.1, CMP47.1, CMP202.1, CMP208.1, CMP219.1, CMP318.1, CMP329.1, CMP634.1, CMP826.1, CMP829.1, CMP1007.3, CMP1009.11, CMP1010.11, CMP1011.11, CMP1012.11, CMP1013.11, CMP1014.11, CMP1015.11, CMP1016.11, CMP1017.14, CMP1017.19, CMP1018.25, CMP1025.34, CMP1035.17, J1.18, J2.18, J3.18, J4.18, J5.18, J6.18, J7.18, R#18.1
Net-20: CMP21.1, CMP22.1, CMP26.1, CMP27.1, CMP1033.8, CMP1037.4
Net-21: CMP23.1, CMP50.1, CMP196.1, CMP215.1, CMP259.1, CMP337.1, CMP1017.7, CMP1018.32, CMP1025.43, CMP1036.2, CMP1036.11, CMP1036.13, CMP1037.13, J1.16, J2.16, J3.16, J4.16, J5.16, J6.16, J7.16
Net-22: C.2, C110.1, C110.2, C#2.1, C#2.2, C#2.3, C#3.2, C#3.3, C#4.1, C#4.2, C#5.2, C#6.3, C#7.2, C#7.3, C#8.1, C#8.2, C#9.1, C#9.2, C#9.3, C#10.1, C#10.2, C#12.1, C#13.2, C#14.3, C#15.3, C#16.2, C#16.3, C#17.2, C#17.3, C#18.2, C#19.3, C#20.2, C#21.3, C#22.2, C#22.3, C#23.3, C#24.1, C#24.2, C#25.1, C#25.2, C#26.1, C#26.2, C#27.2, C#28.1, C#28.2, C#29.1, C#29.2, C#29.3, C#30.1, C#30.2, C#30.3, C#31.1, C#31.2, C#31.3, C#32.1, C#32.2, C#32.3, C#33.1, C#33.2, C#34.1, C#34.3, C#35.1, C#35.2, C#35.3, C#36.3, C#37.1, C#37.2, C#38.1, C#38.2, C#39.1, C#39.2, C#40.1, C#40.2, C#41.1, C#41.2, C#42.1, C#42.2, C#42.3, C#43.1, C#43.2, C#44.3, C#45.1, C#45.2, C#45.3, C#46.1, C#46.2, C#46.3, C#47.3, C#48.2, C#49.1, C#49.2, C#50.1, C#50.2, C#50.3, C#51.1, C#51.2, C#51.3, C#52.2, C#53.1, C#53.2, C#54.1, C#54.2, C#54.3, C#55.1, C#55.2, C#56.1, C#56.2, C#57.1, C#57.2, C#58.1, C#58.2, C#59.1, C#60.2, C#63.2, C#64.1, C#64.2, C#64.3, C#65.1, C#65.2, C#67.1, C#67.2, C#67.3, C#69.2, C#70.1, C#71.1, C#71.2, C#72.1, C#72.2, C#73.1, C#73.2, C#74.2, C#75.1, C#75.2, C#76.1, C#76.2, C#79.1, C#79.2, C#79.3, C#80.1, C#80.2, C#80.3, C#81.1, C#81.2, C#81.3, C#82.1, C#82.2, C#82.3, C#83.1, C#83.2, C#83.3, C#84.1, C#84.2, C#84.3, C#85.1, C#85.2, C#85.3, C#86.1, C#86.2, C#86.3, C#87.1, C#87.2, C#87.3, C#88.1, C#88.2, C#88.3, C#89.1, C#89.2, C#89.3, C#90.2, C#91.1, C#92.1, C#93.1, C#93.2, C#93.3, C#94.1, C#94.2, C#94.3, C#95.1, C#95.2, C#96.2, C#97.2, C#98.1, C#98.2, C#99.1, C#99.2, C#100.1, C#100.2, C#101.1, C#101.2, C#102.1, C#102.2, CMP24.1, CMP29.1, CMP36.1, CMP37.1, CMP38.1, CMP40.1, CMP76.1, CMP89.1, CMP91.1, CMP92.1, CMP93.1, CMP94.1, CMP95.1, CMP96.1, CMP107.1, CMP109.1, CMP112.1, CMP124.1, CMP131.1, CMP134.1, CMP140.1, CMP141.1, CMP142.1, CMP145.1, CMP186.1, CMP187.1, CMP190.1, CMP191.1, CMP192.1, CMP238.1, CMP244.1, CMP247.1, CMP260.1, CMP261.1, CMP264.1, CMP267.1, CMP270.1, CMP271.1, CMP273.1, CMP279.1, CMP285.1, CMP286.1, CMP299.1, CMP301.1, CMP303.1, CMP304.1, CMP305.1, CMP306.1, CMP307.1, CMP308.1, CMP309.1, CMP310.1, CMP311.1, CMP315.1, CMP345.1, CMP355.1, CMP367.1, CMP375.1, CMP399.1, CMP410.1, CMP411.1, CMP412.1, CMP418.1, CMP435.1, CMP436.1, CMP439.1, CMP446.1, CMP449.1, CMP450.1, CMP457.1, CMP460.1, CMP467.1, CMP484.1, CMP495.1, CMP497.1, CMP506.1, CMP507.1, CMP521.1, CMP523.1, CMP549.1, CMP551.1, CMP552.1, CMP553.1, CMP556.1, CMP565.1, CMP566.1, CMP567.1, CMP577.1, CMP583.1, CMP599.1, CMP603.1, CMP607.1, CMP613.1, CMP615.1, CMP616.1, CMP618.1, CMP621.1, CMP625.1, CMP626.1, CMP627.1, CMP630.1, CMP636.1, CMP637.1, CMP639.1, CMP642.1, CMP646.1, CMP651.1, CMP652.1, CMP653.1, CMP656.1, CMP673.1, CMP683.1, CMP684.1, CMP685.1, CMP686.1, CMP687.1, CMP714.1, CMP716.1, CMP724.1, CMP725.1, CMP732.1, CMP734.1, CMP741.1, CMP761.1, CMP800.1, CMP803.1, CMP804.1, CMP806.1, CMP811.1, CMP814.1, CMP815.1, CMP817.1, CMP821.1, CMP824.1, CMP831.1, CMP832.1, CMP833.1, CMP835.1, CMP839.1, CMP842.1, CMP853.1, CMP855.1, CMP856.1, CMP857.1, CMP858.1, CMP859.1, CMP860.1, CMP861.1, CMP862.1, CMP863.1, CMP864.1, CMP866.1, CMP867.1, CMP868.1, CMP869.1, CMP870.1, CMP871.1, CMP872.1, CMP873.1, CMP874.1, CMP875.1, CMP876.1, CMP877.1, CMP878.1, CMP879.1, CMP880.1, CMP881.1, CMP882.1, CMP883.1, CMP885.1, CMP886.1, CMP891.1, CMP892.1, CMP893.1, CMP894.1, CMP895.1, CMP896.1, CMP897.1, CMP898.1, CMP899.1, CMP900.1, CMP901.1, CMP902.1, CMP903.1, CMP904.5, CMP904.17, CMP905.17, CMP906.1, CMP906.5, CMP906.18, CMP906.26, CMP907.1, CMP907.5, CMP907.18, CMP907.26, CMP908.1, CMP908.5, CMP908.26, CMP918.1, CMP951.1, CMP970.1, CMP980.1, CMP1002.1, CMP1005.11, CMP1005.22, CMP1005.23, CMP1005.31, CMP1005.34, CMP1005.37, CMP1006.1, CMP1006.5, CMP1006.7, CMP1006.14, CMP1006.26, CMP1007.4, CMP1007.5, CMP1007.6, CMP1007.12, CMP1007.14, CMP1008.3, CMP1008.6, CMP1008.7, CMP1008.9, CMP1008.10, CMP1008.16, CMP1009.1, CMP1009.5, CMP1009.15, CMP1010.1, CMP1010.5, CMP1010.15, CMP1011.1, CMP1011.5, CMP1011.15, CMP1012.1, CMP1012.5, CMP1012.15, CMP1013.1, CMP1013.5, CMP1013.15, CMP1014.1, CMP1014.5, CMP1014.15, CMP1015.1, CMP1015.5, CMP1015.15, CMP1016.1, CMP1016.5, CMP1016.15, CMP1017.5, CMP1017.12, CMP1017.40, CMP1018.4, CMP1018.5, CMP1018.8, CMP1018.37, CMP1019.5, CMP1019.15, CMP1020.5, CMP1020.10, CMP1020.19, CMP1021.5, CMP1021.19, CMP1022.1, CMP1022.5, CMP1022.7, CMP1022.19, CMP1023.5, CMP1023.12, CMP1023.15, CMP1024.5, CMP1024.15, CMP1025.1, CMP1025.2, CMP1025.12, CMP1025.26, CMP1025.45, CMP1025.56, CMP1033.1, CMP1033.34, CMP1034.5, CMP1034.19, CMP1035.5, CMP1035.19, CMP1036.3, CMP1036.5, CMP1036.12, CMP1037.3, CMP1037.5, CMP1037.12, CMP1038.5, CMP1038.10, CMP1038.17, CMP1038.19, CMP1039.4, CMP1039.5, CMP1039.10, CMP1039.15, CMP1039.16, CMP1040.5, CMP1040.15, CMP1041.5, CMP1041.15, CMP1042.5, CMP1042.15, CMP1043.1, CMP1043.2, CMP1043.5, CMP1043.15, CMP1044.2, CMP1044.6, CMP1044.8, CMP1044.9, CMP1044.10, CMP1044.12, CMP1044.14, CMP1045.5, CMP1045.8, CMP1045.12, CMP1046.5, CMP1046.12, CMP1046.13, CMP1047.1, CMP1047.12, CMP1048.1, CMP1048.5, CMP1048.6, CMP1048.12, CMP1049.5, CMP1049.12, CMP1050.5, CMP1050.12, CMP1160.1, CMP1160.2, CMP1160.3, CMP1160.4, CMP1160.5, CMP1160.6, CMP1160.7, CMP1160.8, CMP1160.9, CMP1160.10, CMP1160.11, CMP1160.12, CMP1160.13, CMP1160.14, CMP1160.15, CMP1160.16, CMP1160.17, CMP1160.18, CMP1160.19, CMP1160.20, CMP1255.2, CMP1265.2, CMP1271.1, CMP1271.2, CMP1272.1, CMP1272.2, CMP1273.1, CMP1275.1, CMP1275.2, D#5.1, D#6.1, D#14.2, D#17.1, D#17.2, D#18.2, D#19.1, D#19.2, D#20.1, D#27.1, J.1, J.2, J.3, J.4, J.5, J.6, J.7, J1.1, J1.2, J1.5, J1.15, J1.17, J2.1, J2.2, J2.15, J2.17, J3.1, J3.2, J3.15, J3.17, J4.1, J4.2, J4.15, J4.17, J5.1, J5.2, J5.15, J5.17, J6.1, J6.2, J6.15, J6.17, J7.1, J7.2, J7.14, J7.15, J7.17, Q#2.1, Q#2.3, Q#5.1, Q#5.2, Q#5.3, R#16.2, R#17.2, R#18.2, R#19.2, R#20.2, R#21.2, R#22.2, R#23.2, R#24.2, R#25.1, R#26.1, R#27.1, R#28.1, R#29.1, R#31.2, R#32.2, R#33.1, R#34.1, R#35.1, R#36.1, R#36.2, R#37.1, R#37.2, R#38.1, R#38.2, R#39.1, R#40.1, R#41.1, R#42.1, R#43.1, R#44.1, R#45.1, R#46.1, R#47.1, R#50.2, R#52.1, R#52.2, R#54.1, R#59.1, R#59.2, R#60.1, R#60.2, R#61.1, R#67.2, R#68.2, R#69.2, R#70.2, R#71.1, R#72.1, R#73.1, R#74.1, R#74.2, R#75.1, R#77.1, R#81.2, R#83.1, R#84.1, R#86.2, R#87.2, R#89.1, R#91.1, R#92.1, R#92.2, R#93.1, R#93.2, R#94.1, R#94.2, R#95.1, R#95.2, R#96.1, R#96.2, R#97.1, R#97.2, R#98.2, R#99.2, R#100.1, R#101.2, R#102.1, R#102.2, R#103.2, R#107.1, R#108.1, R#108.2, R#109.1, R#110.1, R#111.2, R#112.2, R#113.2, R#114.2
Net-23: CMP25.1, CMP71.1, CMP1033.14, CMP1036.9
Net-24: CMP28.1, CMP1034.1, CMP1034.6, CMP1035.1, CMP1035.6, CMP1037.1
Net-25: CMP31.1, CMP171.1, CMP906.16, CMP907.16, CMP1017.27, CMP1035.14, CMP1040.3, J1.28, J2.28, J3.28, J4.28, J5.28, J6.28, J7.28
Net-26: CMP32.1, CMP520.1, CMP562.1, CMP624.1, CMP1035.18, CMP1040.4, CMP1049.1, J1.26, J2.26, J3.26, J4.26, J5.26, J6.26, J7.26
Net-27: CMP33.1, CMP1035.10, CMP1040.2
Net-28: CMP34.1, CMP45.1, CMP114.1, CMP437.1, CMP606.1, R#79.1
Net-29: CMP39.1, CMP1036.6
Net-30: CMP41.1, CMP415.1, CMP416.1, CMP455.1, CMP508.1, CMP1038.9, CMP1262.2
Net-31: CMP42.1, CMP43.1
Net-32: CMP44.1, CMP1025.9, CMP1038.13, R#55.2
Net-33: CMP46.1, CMP73.1, CMP125.1, CMP178.1, CMP277.1, CMP406.1, CMP1018.9, CMP1025.14, CMP1037.8, CMP1047.3
Net-34: CMP48.1, CMP51.1, CMP274.1, CMP386.1, CMP394.1, CMP426.1, CMP429.1, CMP505.1, CMP1019.1, CMP1019.8, CMP1025.6, CMP1049.7
Net-35: CMP52.1, CMP63.1, CMP357.1, CMP365.1, CMP376.1, CMP489.1, CMP492.1, CMP641.1, CMP648.1, CMP908.18, CMP908.25, CMP908.28, CMP917.1, CMP1019.13, CMP1019.14, CMP1019.16, CMP1025.4, R#45.2, R#46.2, R#72.2, R#73.2
Net-36: CMP53.1, CMP181.1, CMP288.1, CMP545.1, CMP720.1, CMP906.23, CMP907.23, CMP1009.2, CMP1009.7, CMP1020.3, CMP1021.7, CMP1022.2, CMP1025.27, CMP1033.16
Net-37: CMP54.1, CMP180.1, CMP289.1, CMP472.1, CMP721.1, CMP906.24, CMP907.24, CMP1010.2, CMP1010.7, CMP1020.4, CMP1021.8, CMP1022.9, CMP1025.25, CMP1033.18
Net-38: CMP56.1, CMP179.1, CMP290.1, CMP476.1, CMP906.25, CMP907.25, CMP1011.2, CMP1011.7, CMP1020.12, CMP1021.10, CMP1022.11, CMP1025.19, CMP1033.20
Net-39: CMP59.1, CMP719.1, CMP906.27, CMP907.27, CMP1013.2, CMP1013.7, CMP1020.16, CMP1021.14, CMP1022.18, CMP1025.20, CMP1033.22
Net-40: CMP60.1, CMP291.1, CMP474.1, CMP654.1, CMP906.28, CMP907.28, CMP1012.2, CMP1012.7, CMP1020.15, CMP1021.13, CMP1022.17, CMP1025.17, CMP1033.21
Net-41: CMP62.1, CMP194.1, CMP239.1, CMP1025.40
Net-42: CMP64.1, CMP77.1, CMP146.1, CMP372.1, CMP1017.10, J1.8, J2.8, J3.8, J4.8, J5.8, J6.8, J7.8, R#26.2
Net-43: CMP65.1, J1.9, J2.9, J3.9, J4.9, J5.9, J6.9, J7.9, R#28.2
Net-44: CMP66.1, J1.10, J2.10, J3.10, J4.10, J5.10, J6.10, J7.10, R#27.2
Net-45: CMP67.1, J1.7, J2.7, J3.7, J4.7, J5.7, J6.7, J7.7, R#29.2
Net-46: CMP72.1, J1.19
Net-47: CMP74.1, CMP262.1, CMP609.1, CMP999.1, CMP1037.7
Net-48: CMP78.1, CMP408.1, CMP633.1, CMP638.1, CMP968.1, CMP1005.29, CMP1007.1, CMP1033.5, J1.11, J2.11, J3.11, J4.11, J5.11, J6.11, J7.11, R#109.2
Net-49: CMP79.1, CMP1040.7, J1.50
Net-50: CMP80.1, CMP120.1, CMP1017.13, CMP1045.6
Net-51: CMP81.1, CMP1040.8, J2.50
Net-52: CMP82.1, CMP111.1, CMP1040.13, J4.50
Net-53: CMP83.1, CMP117.1, CMP1040.14, J5.50
Net-54: CMP84.1, CMP133.1, CMP158.1, CMP161.1, CMP229.1, CMP236.1, CMP263.1, CMP269.1, CMP302.1, CMP525.1, CMP527.1, CMP535.1, CMP608.1, CMP998.1, CMP1025.60, CMP1038.3, CMP1039.14, CMP1049.13, J7.19
Net-55: CMP85.1, CMP97.1, CMP103.1, CMP393.1, J1.14
Net-56: CMP86.1, CMP118.1, CMP143.1, CMP1041.16, J6.31
Net-57: CMP87.1, CMP132.1, CMP400.1, CMP1041.12, J7.31
Net-58: CMP88.1, CMP99.1, CMP152.1, CMP153.1, CMP548.1, CMP1017.1, CMP1040.11, CMP1049.2, J2.19, J3.19, J4.19, J5.19, J6.19
Net-59: C#78.1, CMP90.1, CMP632.1, CMP1017.8, D#20.2, R#86.1
Net-60: CMP98.1, CMP110.1, CMP149.1, CMP1041.13, J4.31
Net-61: CMP100.1, CMP1041.8, J2.31
Net-62: CMP101.1, CMP1041.10, J3.31
Net-63: CMP102.1, CMP105.1, CMP147.1, CMP150.1, CMP151.1, CMP1041.14, J5.31
Net-64: CMP104.1, CMP384.1, CMP605.1, CMP906.14, CMP947.1
Net-65: CMP106.1, CMP1042.7, D#25.2
Net-66: CMP108.1, CMP123.1, CMP137.1, CMP1021.17, CMP1043.9, J1.33, J2.33, J3.33, J4.33, J5.33, J6.33, J7.33
Net-67: CMP113.1, CMP115.1, CMP1045.7, R#71.2
Net-68: CMP116.1, CMP189.1, CMP473.1, CMP836.1, CMP837.1, CMP1017.3, CMP1046.2, CMP1046.4
Net-69: CMP119.1, CMP121.1, CMP157.1, CMP441.1, CMP1040.16, J6.50
Net-70: CMP122.1, CMP532.1, CMP604.1, CMP728.1, CMP757.1, CMP948.1, CMP1046.11
Net-71: CMP126.1, CMP127.1, CMP340.1, CMP351.1, CMP370.1, CMP526.1, CMP534.1, CMP610.1, CMP623.1, CMP631.1, CMP908.2, CMP1018.7, CMP1025.55, CMP1046.10, CMP1049.4, CMP1050.6, CMP1259.2
Net-72: CMP129.1, CMP536.1, CMP1049.3
Net-74: CMP135.1, CMP1021.2, J1.47, J2.47, J3.47, J4.47, J5.47, J6.47, J7.47
Net-75: CMP136.1, CMP1021.3, J1.45, J2.45, J3.45, J4.45, J5.45, J6.45, J7.45
Net-76: CMP138.1, CMP168.1, CMP268.1, CMP541.1, CMP1025.11, CMP1036.1, CMP1037.9, CMP1038.14, CMP1040.9, CMP1041.4, CMP1046.7, CMP1050.4, J1.25, J2.25, J3.25, J4.25, J5.25, J6.25, J7.25, R#56.2
Net-77: CMP144.1, CMP444.1, CMP1046.8, J1.12, J2.12, J3.12, J4.12, J5.12, J6.12, J7.12
Net-78: CMP148.1, CMP352.1, CMP1017.6, J1.13, J2.13, J3.13, R#25.2
Net-79: CMP154.1, CMP164.1, CMP165.1, CMP906.8, CMP907.8, CMP1017.29, J1.32, J2.32, J3.32, J4.32, J5.32, J6.32, J7.32
Net-80: CMP155.1, CMP166.1, CMP167.1, CMP906.10, CMP907.10, CMP1017.28, J1.30, J2.30, J3.30, J4.30, J5.30, J6.30, J7.30
Net-81: CMP156.1, CMP170.1, CMP906.13, CMP907.13, CMP1017.22
Net-82: CMP159.1, CMP172.1, CMP275.1, CMP451.1, CMP502.1, CMP516.1, CMP518.1, CMP1025.8, CMP1049.6, R#47.2
Net-83: CMP160.1, J1.23, J2.23, J3.23, J4.23, J5.23, J6.23, J7.23
Net-84: CMP162.1, CMP543.1, CMP1040.12, J7.50
Net-85: CMP163.1, CMP182.1, CMP1037.2
Net-86: CMP169.1, CMP184.1, CMP193.1, CMP198.1, CMP461.1, CMP908.12, CMP1020.2, CMP1025.29
Net-87: CMP173.1, CMP174.1, CMP276.1, CMP431.1, CMP465.1, CMP908.3, CMP1020.18, CMP1025.18
Net-88: CMP176.1, CMP183.1, CMP241.1, CMP377.1, CMP529.1, CMP558.1, CMP727.1, CMP756.1, CMP907.14, CMP1025.38, CMP1046.3
Net-89: CMP177.1, CMP730.1, CMP1018.2, CMP1050.14
Net-90: CMP185.1, CMP278.1, CMP1017.21, CMP1025.13, CMP1038.15
Net-91: CMP188.1, CMP316.1, CMP341.1, CMP390.1, CMP397.1, CMP481.1, CMP655.1, CMP1017.9, CMP1018.36, CMP1020.1, CMP1020.20, CMP1025.16, CMP1037.14, CMP1042.11, J1.29, J2.29, J3.29, J4.29, J5.29, J6.29, J7.29, R#57.1
Net-92: CMP195.1, CMP224.1, CMP294.1, CMP354.1, CMP419.1, CMP908.17, CMP1018.20, CMP1025.47, CMP1038.11
Net-93: CMP197.1, CMP235.1, CMP253.1, CMP283.1, CMP295.1, CMP1017.11, CMP1018.38, CMP1025.54, CMP1038.6, R#58.1
Net-94: CMP200.1, CMP220.1, CMP231.1, CMP349.1, CMP378.1, CMP383.1, CMP908.15, CMP1018.1, CMP1025.52
Net-95: CMP201.1, CMP203.1, CMP317.1, CMP323.1, CMP330.1, CMP825.1, CMP828.1, CMP1009.12, CMP1010.12, CMP1011.12, CMP1012.12, CMP1013.12, CMP1014.12, CMP1015.12, CMP1016.12, CMP1017.17, CMP1018.26, CMP1025.31, R#19.1
Net-96: CMP204.1, CMP210.1, CMP320.1, CMP331.1, CMP827.1, CMP830.1, CMP1009.9, CMP1010.9, CMP1011.9, CMP1012.9, CMP1013.9, CMP1014.9, CMP1015.9, CMP1016.9, CMP1017.15, CMP1018.23, CMP1025.44, R#17.1
Net-97: CMP205.1, CMP209.1, CMP360.1, CMP1009.10, CMP1010.10, CMP1011.10, CMP1012.10, CMP1013.10, CMP1014.10, CMP1015.10, CMP1016.10, CMP1017.24, CMP1018.24, CMP1025.36, R#21.1
Net-98: CMP206.1, CMP212.1, CMP321.1, CMP359.1, CMP1009.13, CMP1010.13, CMP1011.13, CMP1012.13, CMP1013.13, CMP1014.13, CMP1015.13, CMP1016.13, CMP1017.25, CMP1018.19, CMP1025.35, R#22.1
Net-99: CMP207.1, CMP211.1, CMP322.1, CMP358.1, CMP1009.14, CMP1010.14, CMP1011.14, CMP1012.14, CMP1013.14, CMP1014.14, CMP1015.14, CMP1016.14, CMP1017.26, CMP1018.17, CMP1025.37, R#23.1
Net-100: CMP213.1, CMP221.1, CMP324.1, CMP362.1, CMP1009.8, CMP1010.8, CMP1011.8, CMP1012.8, CMP1013.8, CMP1014.8, CMP1015.8, CMP1016.8, CMP1017.35, CMP1018.15, CMP1025.42, R#20.1
Net-101: CMP214.1, CMP225.1, CMP251.1, CMP1017.23, CMP1018.21, CMP1025.41
Net-102: CMP222.1, CMP223.1, CMP335.1, CMP373.1, CMP468.1, CMP471.1, CMP504.1, CMP908.16, CMP1018.16, CMP1025.53
Net-103: CMP226.1, CMP248.1, CMP255.1, CMP257.1, CMP282.1, CMP338.1, CMP1039.1, CMP1039.6, CMP1039.9, CMP1039.13
Net-104: CMP227.1, CMP245.1, CMP313.1, CMP503.1, CMP546.1, CMP1019.11, CMP1025.58
Net-105: CMP230.1, CMP232.1, CMP327.1, CMP328.1, CMP498.1, CMP499.1, CMP769.1, CMP849.1, CMP850.1, CMP1008.4, CMP1018.29, CMP1025.5, CMP1025.39, R#48.1
Net-106: CMP233.1, CMP1025.15
Net-107: CMP234.1, CMP237.1, CMP252.1, CMP254.1, CMP298.1, CMP334.1, CMP496.1, CMP500.1, CMP1039.8, CMP1039.12
Net-108: CMP240.1, CMP347.1, CMP381.1, CMP425.1, CMP432.1, CMP466.1, CMP908.8, CMP1020.13, CMP1025.24
Net-109: CMP246.1, CMP312.1, CMP404.1, CMP906.4, CMP907.4, CMP1017.31, CMP1018.39, CMP1034.12, CMP1041.3, CMP1042.3, J1.36, J2.36, J3.36, J4.36, J5.36, J6.36, J7.36
Net-110: CMP249.1, CMP339.1, CMP713.1, CMP752.1, CMP1025.49
Net-111: CMP256.1, CMP314.1, CMP1025.50, CMP1042.12, CMP1044.3, CMP1044.7, CMP1044.11, CMP1044.13
Net-112: CMP258.1, CMP1018.34, R#64.2
Net-113: CMP265.1, CMP442.1, CMP480.1, CMP509.1, CMP514.1, CMP1037.10
Net-114: CMP266.1, CMP1036.4
Net-115: CMP280.1, CMP374.1, CMP438.1, CMP454.1, CMP491.1, CMP660.1, CMP664.1, CMP676.1, CMP1018.10, CMP1018.11, CMP1020.6, CMP1022.20, CMP1023.7, CMP1025.32, CMP1025.33, CMP1038.4, CMP1045.14, CMP1048.10, CMP1262.1
Net-116: CMP281.1, CMP287.1, CMP297.1, CMP1039.7, CMP1039.11
Net-117: CMP284.1, CMP1025.59, CMP1038.20, R#53.2
Net-118: CMP292.1, CMP1025.10, CMP1036.14, R#51.1
Net-119: CMP293.1, CMP296.1, CMP1017.4, CMP1036.10
Net-120: CMP300.1, CMP332.1, CMP392.1, CMP908.10, CMP1018.14
Net-121: CMP319.1, CMP343.1, CMP344.1, CMP363.1, CMP1009.16, CMP1010.16, CMP1011.16, CMP1012.16, CMP1013.16, CMP1014.16, CMP1015.16, CMP1016.16, CMP1018.12, R#24.1
Net-122: CMP325.1, CMP402.1, CMP421.1, CMP1018.35, CMP1040.6, CMP1041.9
Net-123: CMP326.1, CMP350.1, CMP382.1, CMP430.1, CMP458.1, CMP459.1, CMP908.14, CMP1018.3, CMP1025.48
Net-124: CMP333.1, CMP396.1, CMP647.1, CMP1018.28
Net-125: C#44.1, C#44.2, CMP336.1, CMP1018.40
Net-126: CMP346.1, CMP380.1, CMP494.1, CMP1019.6, CMP1025.7
Net-127: CMP348.1, CMP371.1, CMP379.1, CMP1018.30
Net-128: CMP356.1, CMP1018.27
Net-129: CMP361.1, CMP364.1, CMP657.1, CMP754.1, CMP1018.13, CMP1023.9
Net-130: CMP366.1, CMP908.24, CMP1019.10, R#44.2
Net-131: CMP368.1, CMP462.1, CMP908.11, CMP1020.9, CMP1025.23
Net-132: CMP369.1, CMP908.23, CMP1019.7, R#39.2
Net-133: CMP385.1, CMP391.1, CMP427.1, CMP547.1, CMP1009.3, CMP1010.3, CMP1011.3, CMP1012.3, CMP1013.3, CMP1014.3, CMP1015.3, CMP1016.3
Net-134: CMP395.1, CMP852.1, CMP1042.13
Net-135: CMP398.1, CMP544.1, CMP1050.10, D#26.1, R#57.2
Net-136: CMP401.1, CMP906.3, CMP907.3, CMP1017.30, CMP1041.11, CMP1042.4, J1.34, J2.34, J3.34, J4.34, J5.34, J6.34, J7.34
Net-137: CMP403.1, CMP1040.10, J3.50
Net-138: CMP407.1, CMP1038.16
Net-140: CMP413.1, CMP666.1, CMP767.1, CMP823.1, CMP1008.13
Net-141: CMP414.1, CMP693.1, CMP768.1, CMP822.1, CMP976.1, CMP1008.14, CMP1043.3
Net-142: CMP417.1, CMP1043.10, CMP1044.15, R#70.1
Net-143: CMP433.1, CMP908.27, CMP1019.9, R#43.2
Net-144: CMP434.1, CMP1044.16
Net-145: CMP440.1, CMP772.1, CMP1005.39, CMP1045.2, CMP1045.4
Net-146: CMP443.1, CMP1047.9, CMP1048.9, CMP1048.13, CMP1049.9
Net-147: CMP445.1, CMP1046.1, CMP1048.8
Net-148: CMP448.1, CMP511.1, CMP904.15, CMP905.15, CMP1045.11
Net-149: CMP452.1, CMP513.1, CMP517.1, CMP650.1, CMP908.13, CMP1050.3
Net-150: CMP453.1, CMP1048.14, CMP1262.3
Net-152: CMP463.1, CMP908.9, CMP1020.11
Net-153: CMP464.1, CMP485.1, CMP908.4, CMP1020.17
Net-154: CMP469.1, CMP908.22, R#42.2
Net-155: CMP470.1, CMP908.21, R#41.2
Net-156: CMP475.1, CMP708.1, CMP1005.3, CMP1045.1, CMP1048.2
Net-157: CMP479.1, CMP488.1, CMP528.1, CMP538.1, CMP540.1, CMP717.1, CMP1049.10
Net-158: CMP483.1, CMP1017.2, CMP1021.1
Net-159: CMP490.1, CMP493.1, CMP659.1, CMP715.1, CMP751.1, CMP1024.10
Net-160: C#66.2, CMP501.1, CMP554.1, CMP555.1, CMP557.1, CMP595.1, CMP668.1, CMP1018.33
Net-161: CMP510.1, CMP847.1, CMP904.18, CMP905.18, CMP1005.33, CMP1045.10
Net-162: CMP512.1, CMP519.1, CMP1049.14, R#76.1
Net-163: CMP522.1, CMP524.1, CMP1046.14, CMP1050.2
Net-164: CMP530.1, CMP531.1, CMP539.1, CMP722.1, CMP1038.12, CMP1050.8
Net-165: CMP533.1, CMP681.1, CMP729.1, CMP733.1
Net-166: CMP537.1, CMP619.1, CMP1047.8, CMP1048.11
Net-167: CMP542.1, CMP559.1, CMP561.1, CMP570.1, CMP593.1, CMP776.1, CMP816.1, CMP820.1, CMP1005.36, CMP1007.13, CMP1050.9
Net-168: CMP550.1, CMP628.1, CMP1008.2
Net-169: CMP560.1, CMP568.1, CMP569.1, CMP731.1, CMP746.1, CMP1005.40, CMP1024.1, CMP1045.13, D#15.2
Net-170: CMP563.1, CMP819.1, CMP840.1, CMP845.1, CMP1007.8, CMP1050.11
Net-171: CMP564.1, CMP1049.8, R#78.1
Net-172: CMP571.1, CMP1005.10, CMP1006.4
Net-173: CMP572.1, CMP578.1, CMP904.2, CMP905.2, CMP1005.13, CMP1006.9, CMP1022.14, D#12.2
Net-174: CMP573.1, CMP581.1, CMP904.3, CMP905.3, CMP1005.14, CMP1006.11, CMP1022.16, D#11.2
Net-175: CMP574.1, CMP582.1, CMP904.4, CMP905.4, CMP1005.16, CMP1006.12, CMP1022.15, D#8.2
Net-176: CMP575.1, CMP588.1, CMP904.12, CMP905.12, CMP1005.18, CMP1006.15, CMP1022.12, D#10.2
Net-177: CMP576.1, CMP594.1, CMP904.11, CMP905.11, CMP1005.20, CMP1006.17, CMP1022.4, D#9.2
Net-178: CMP579.1, CMP812.1, CMP904.8, CMP905.8, CMP1005.6, CMP1006.8, CMP1023.1, D.2
Net-179: CMP580.1, CMP586.1, CMP640.1, CMP663.1, CMP675.1, CMP680.1, CMP1008.12, CMP1018.22
Net-180: CMP584.1, CMP597.1, CMP743.1, CMP766.1, CMP799.1, CMP904.13, CMP1005.24, CMP1006.25, CMP1024.12, R#13.1
Net-181: CMP585.1, CMP905.10, CMP1005.25, CMP1006.20, R.1
Net-182: CMP587.1, CMP739.1, CMP773.1, CMP783.1, CMP792.1, CMP802.1, CMP805.1, CMP1005.1, CMP1006.16, CMP1023.3
Net-183: CMP589.1, CMP591.1, CMP744.1, CMP745.1, CMP764.1, CMP904.16, CMP1005.26, CMP1006.23, CMP1024.3, R#5.1
Net-184: CMP590.1, CMP596.1, CMP747.1, CMP749.1, CMP763.1, CMP904.14, CMP1005.35, CMP1006.24, CMP1024.9, R#9.1
Net-185: CMP592.1, CMP777.1, CMP904.9, CMP905.9, CMP1005.21, CMP1006.19, CMP1022.3, D#7.2
Net-186: CMP598.1, CMP612.1, CMP742.1, CMP748.1, CMP762.1, CMP765.1, CMP904.10, CMP1005.15, CMP1006.28, CMP1024.16, R#15.1
Net-187: CMP600.1, CMP1005.2, CMP1006.2
Net-188: CMP601.1, CMP602.1, R#80.1, R#87.1, R#88.1
Net-189: CMP611.1, CMP797.1, CMP905.16, CMP1005.12, CMP1006.27, CMP1024.13, R#11.1
Net-190: CMP620.1, CMP1265.1, J7.4
Net-191: CMP629.1, CMP818.1, Q.3, Q#4.3, R#100.2
Net-192: CMP635.1, Q.2
Net-193: CMP643.1, CMP644.1, CMP906.6
Net-195: CMP649.1, CMP1048.4
Net-196: CMP661.1, CMP667.1, CMP1015.2, CMP1015.7, CMP1022.10
Net-197: CMP662.1, CMP678.1, CMP1018.18, CMP1023.4
Net-198: CMP665.1, CMP1023.16, R#106.1
Net-199: CMP670.1, CMP671.1, CMP674.1, CMP697.1, CMP972.1, CMP1024.2, R#114.1
Net-200: CMP672.1, CMP1023.11, R#104.1
Net-201: C#96.1, CMP677.1, CMP735.1, CMP1023.6, CMP1050.13, D#27.2
Net-202: CMP679.1, CMP682.1, CMP1024.4, R#113.1
Net-203: CMP689.1, CMP726.1, CMP760.1, CMP771.1, CMP986.1, CMP1008.11, CMP1024.14, R#111.1
Net-204: CMP690.1, CMP710.1, CMP984.1, R#107.2
Net-205: CMP691.1, CMP712.1, CMP983.1, R#106.2
Net-206: CMP692.1, CMP707.1, CMP1023.10
Net-208: CMP695.1, CMP699.1, CMP963.1, R#6.1, R#16.1
Net-209: CMP696.1, CMP705.1, CMP851.1, CMP966.1, CMP990.1
Net-210: CMP698.1, CMP974.1, CMP1024.11, R#112.1
Net-211: CMP700.1, CMP961.1, D.1
Net-212: CMP701.1, CMP960.1, D#13.1
Net-213: CMP702.1, CMP958.1, D#3.1
Net-214: CMP703.1, CMP796.1, CMP848.1, CMP956.1, CMP957.1, CMP988.1, R#105.2
Net-215: CMP704.1, CMP795.1, CMP955.1
Net-216: CMP706.1, CMP954.1, D#4.1
Net-217: CMP709.1, CMP1005.9, CMP1024.6
Net-218: CMP711.1, CMP736.1, CMP737.1, CMP1024.7
Net-219: CMP723.1, CMP750.1, CMP1023.13, D#26.2
Net-220: CMP738.1, CMP801.1, CMP813.1, CMP904.7, CMP905.7, CMP1005.7, CMP1006.3, CMP1023.8, D#2.2
Net-221: CMP740.1, CMP770.1, CMP789.1, CMP807.1, CMP809.1, CMP1005.5, CMP1006.13, CMP1023.2, D#4.2
Net-222: CMP758.1, CMP759.1, CMP1049.11, CMP1050.1
Net-223: CMP774.1, CMP798.1, CMP905.14, CMP1005.17, CMP1006.22, CMP1024.8, R#7.1
Net-224: CMP775.1, CMP905.13, CMP1005.19, CMP1006.21, R#3.1
Net-225: CMP778.1, CMP784.1, CMP992.1, D#12.1
Net-226: CMP779.1, D#2.1
Net-227: CMP780.1, CMP786.1, CMP994.1, D#11.1
Net-228: CMP781.1, CMP787.1, CMP995.1, D#8.1
Net-229: CMP782.1, CMP788.1, CMP996.1, D#9.1
Net-230: CMP785.1, CMP993.1, D#10.1
Net-231: CMP790.1, CMP793.1, CMP997.1, D#7.1
Net-232: CMP791.1, CMP794.1, CMP846.1, CMP953.1
Net-233: CMP808.1, CMP904.6, CMP905.6, CMP1005.8, CMP1006.10, D#3.2
Net-234: CMP810.1, CMP1005.28, D#16.2
Net-237: CMP841.1, CMP1043.4, R#77.2
Net-247: CMP904.1, CMP905.1, CMP1022.8, D#13.2
Net-249: CMP906.9, CMP907.9, CMP1017.32, CMP1034.9, CMP1041.2, CMP1042.2, J1.38, J2.38, J3.38, J4.38, J5.38, J6.38, J7.38
Net-250: CMP906.11, CMP907.11, CMP1017.33, CMP1034.3, CMP1041.1, CMP1042.1, J1.40, J2.40, J3.40, J4.40, J5.40, J6.40, J7.40
Net-256: CMP908.20, CMP1019.2, R#40.2
Net-288: CMP964.1, CMP987.1
Net-313: CMP1006.18, CMP1045.3
Net-315: CMP1007.7, D#21.1, D#22.1, D#23.1, D#24.1, D#25.1, R#81.1
Net-317: CMP1007.10, D#15.1, D#16.1, R#101.1
Net-323: CMP1009.4, CMP1010.4, CMP1011.4, CMP1012.4, CMP1013.4, CMP1014.4, CMP1015.4, CMP1016.4, R#58.2
Net-324: CMP1009.6, CMP1010.6, CMP1011.6, CMP1012.6, CMP1013.6, CMP1014.6, CMP1015.6, CMP1016.6, R#48.2
Net-328: CMP1021.4, CMP1021.9, J1.43, J2.43, J3.43, J4.43, J5.43, J6.43, J7.43
Net-329: C#63.1, CMP1021.6
Net-330: CMP1021.11, J1.39, J2.39, J3.39, J4.39, J5.39, J6.39, J7.39
Net-331: CMP1021.12, J1.37, J2.37, J3.37, J4.37, J5.37, J6.37, J7.37
Net-332: CMP1021.15, J1.35, J2.35, J3.35, J4.35, J5.35, J6.35, J7.35
Net-334: CMP1023.14, R#105.1
Net-340: J1.4, J2.3
Net-341: J1.6, J2.5
Net-342: CMP1033.12, J1.27, J2.27, J3.27, J4.27, J5.27, J6.27, J7.27
Net-343: J1.41, J2.41, J3.41, J4.41, J5.41, J6.41, J7.41
Net-344: J2.4, J3.3
Net-345: J2.6, J3.5
Net-347: J3.4, J4.3
Net-348: J3.6, J4.5
Net-350: J4.4, J5.3
Net-351: J4.6, J5.5
Net-352: J4.13, J5.13, J6.13, J7.13
Net-354: J5.4, J6.3
Net-355: J5.6, J6.5
Net-357: J6.4, J7.3
Net-358: J6.6, J7.5
Net-371: CMP1033.17, CMP1034.2
Net-372: CMP1033.19, CMP1034.4
Net-373: CMP1033.23, CMP1034.11
Net-374: CMP1033.24, CMP1034.15
Net-375: CMP1033.25, CMP1034.8
Net-376: CMP1033.26, CMP1034.13
Net-377: CMP1033.30, CMP1035.20
Net-378: CMP1033.31, CMP1035.16
Net-379: CMP1033.32, CMP1035.13
Net-380: CMP1033.33, CMP1035.8
Net-381: CMP1033.35, CMP1034.16
Net-382: CMP1033.36, CMP1034.20
Net-384: CMP1035.7, CMP1040.1
Net-385: C#59.2, CMP1036.7
Net-394: CMP1039.3, R#53.1
Net-401: CMP1042.16, CMP1043.12
Net-402: CMP1043.6, R#67.1
Net-403: CMP1043.7, R#68.1
Net-404: CMP1043.8, R#69.1
Net-409: CMP1045.9, CMP1048.3
Net-411: CMP1047.2, CMP1047.11
Net-412: CMP1047.4, CMP1047.5, CMP1047.10
Net-413: CMP1047.6, D#14.1, R#76.2
Net-414: CMP1047.7, CMP1047.14
Net-417: C#12.2, R#30.1
Net-442: C#47.1, C#47.2
Net-445: C#60.1, R#54.2
Net-452: R#62.1, R#65.2
Net-464: C#66.1, R#75.2
Net-466: C#68.1, CMP1255.1, R#79.2, R#80.2
Net-467: C#68.2, Q#3.1
Net-469: C#69.1, Q#4.2, R#82.2, R#84.2, R#85.2
Net-470: Q#3.2, Q#4.1, R#83.2
Net-471: C#77.2, R#85.1
Net-475: Q#2.2, R#90.1
Net-477: Q.1, R#91.2
Net-478: R#98.1, R#99.1
