clemarfolly/TK3000/(commit log)

2026-08-10 Avanços na PCB
2026-08-12 Inclusão de novos componentes.
2026-08-31 Erros de DRC zerados.
2026-09-04 Ajustes em footprint
2026-09-05 Inclusão de valores de alguns componentes
2026-09-07 Atualização de valores dos componentes
2026-09-24 Valores de componentes e furos de fixação
2026-10-19 Organização para revisão 1.
2026-10-20 Boardview, arquivos de produção, ibom, roms
